CircuitMonkey/synth-zodiac/Documents/photos/USB-c-though-pcb-demo - 1.jpeg

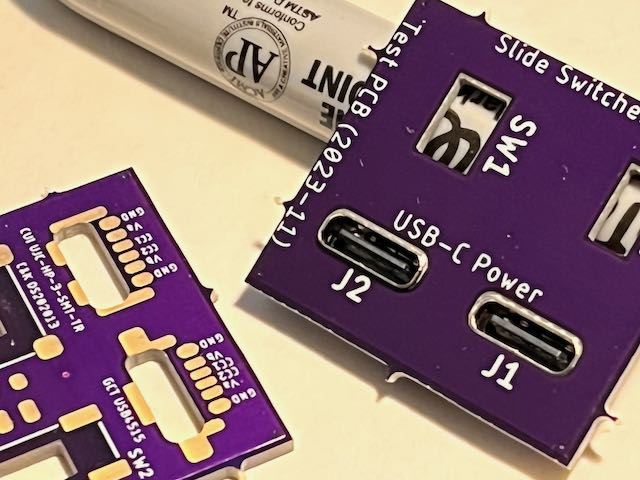
Documents/photos/USB-c-though-pcb-demo - 1.jpeg
