CircuitMonkey/synth-zodiac/Documents/photos/zodiac-pcbs - 1.jpeg

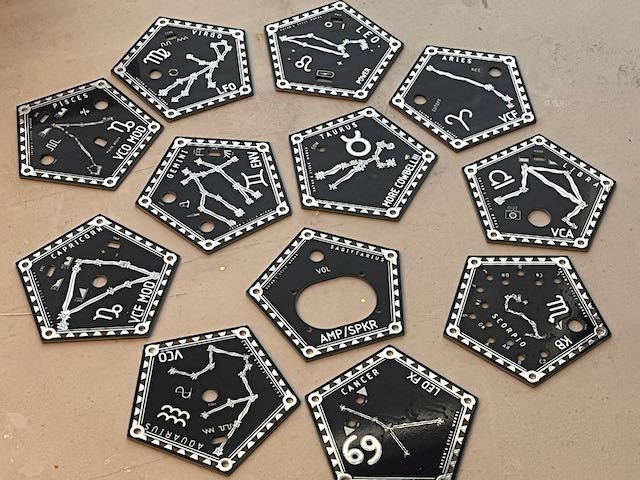
Documents/photos/zodiac-pcbs - 1.jpeg
