CircuitMonkey/synth-zodiac/README.md

# synth-zodiac
Zodiac themed analog synthesizer, shaped like a Dodecahedron.
