CircuitMonkey/synth-zodiac/Documents/zodiac-block-diagram.pdf

# Zodiac Synthesizer – Block Diagram

2022-06-02

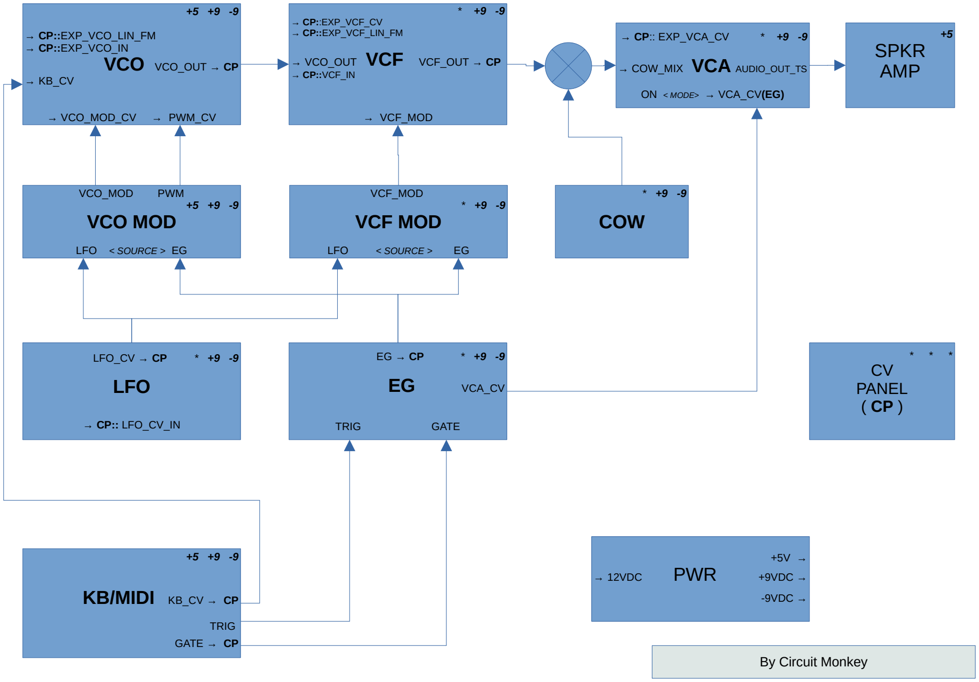
[picture p3: figure]
→ CP::EXP_VCO_LIN_FM → CP::EXP_VCO_IN VCO VCO_OUT → CP; → VCO_MOD_CV; → PWM_CV; LFO_CV → CP; LFO; → CP:: LFO_CV_IN; VCO_MOD; PWM; VCO MOD; LFO < SOURCE > EG; VCA_CV; TRIG; GATE; KB/MIDI KB_CV → CP; TRIG GATE → CP; → CP:: EXP_VCA_CV; → COW_MIX VCA AUDIO_OUT_TS; ON < MODE> → VCA_CV(EG); → 12VDC; PWR; +9VDC →; -9VDC →; SPKR AMP; * +9 -9 COW; CV PANEL ( CP ); → CP::EXP_VCF_CV → CP::EXP_VCF_LIN_FM; → VCO_OUT VCF VCF_OUT → CP; → CP::VCF_IN; → VCF_MOD; VCF_MOD; VCF MOD; < SOURCE >; By Circuit Monkey
