CircuitMonkey/synth-zodiac/Documents/Layouts/layout-bottom-3.png

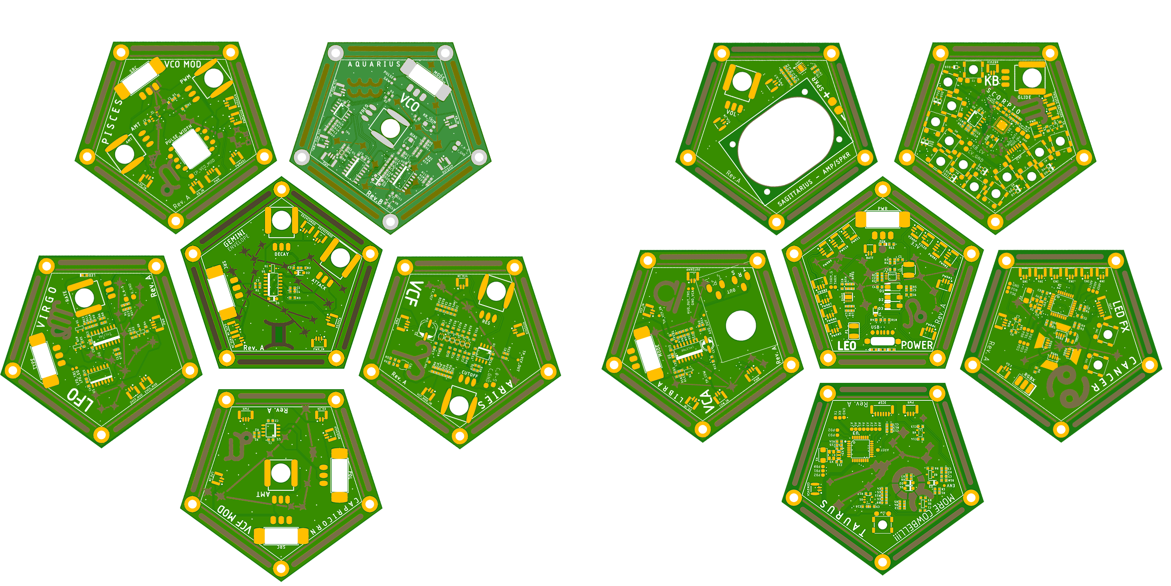
Documents/Layouts/layout-bottom-3.png
