CircuitMonkey/synth-zodiac/Documents/Layouts/layout-top-3.png

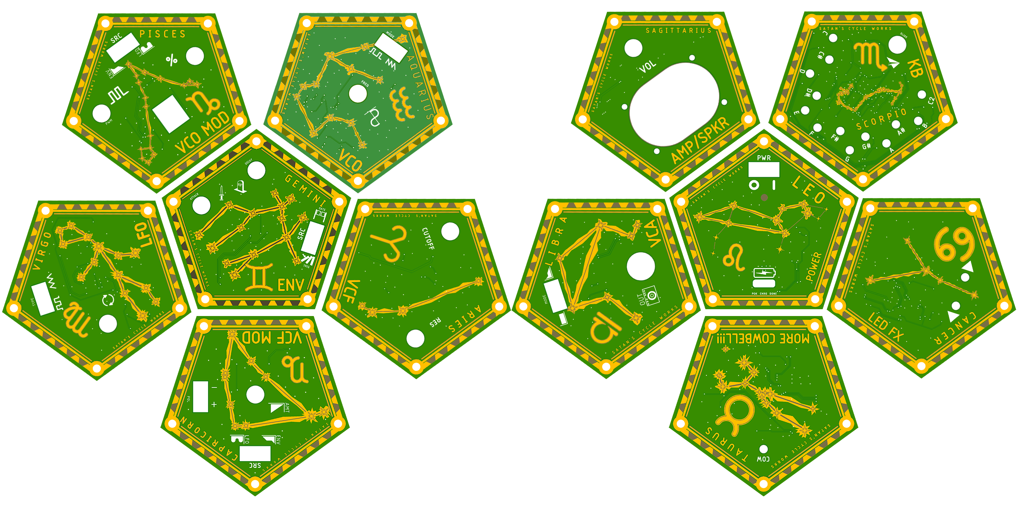
Documents/Layouts/layout-top-3.png
