CircuitMonkey/synth-zodiac/Documents/Layouts/zodiac-layout-2.png

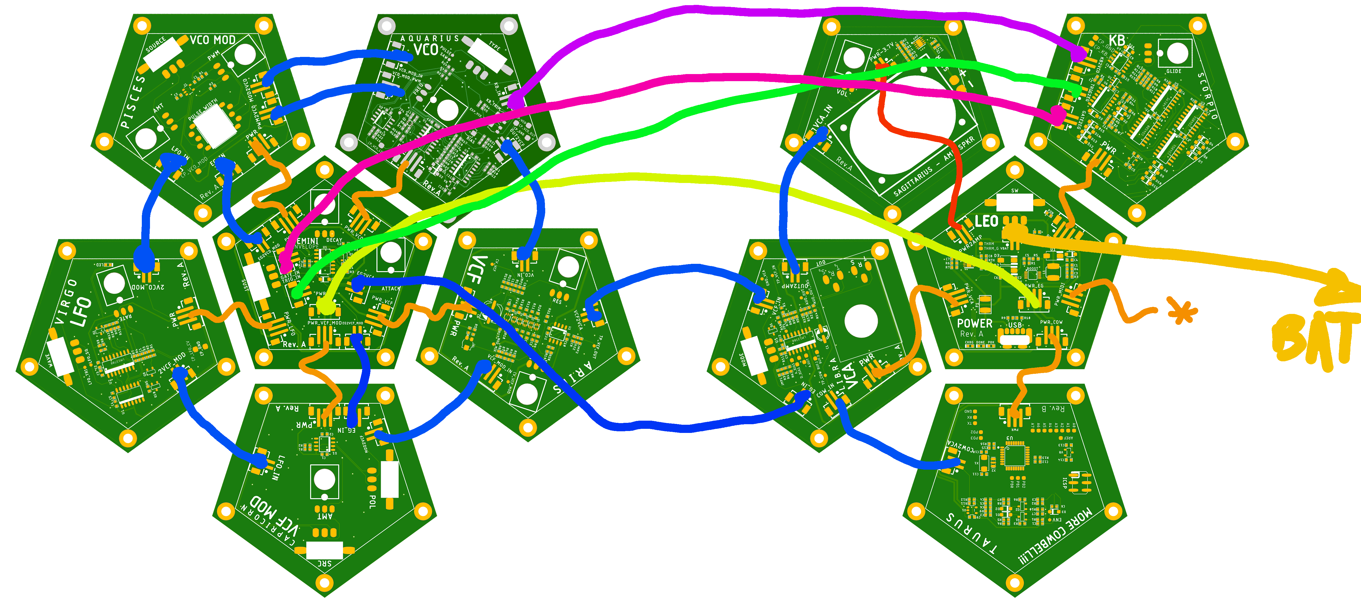
Documents/Layouts/zodiac-layout-2.png
