CircuitMonkey/synth-zodiac/Documents/photos/USB-c-though-pcb-demo - 2.jpeg

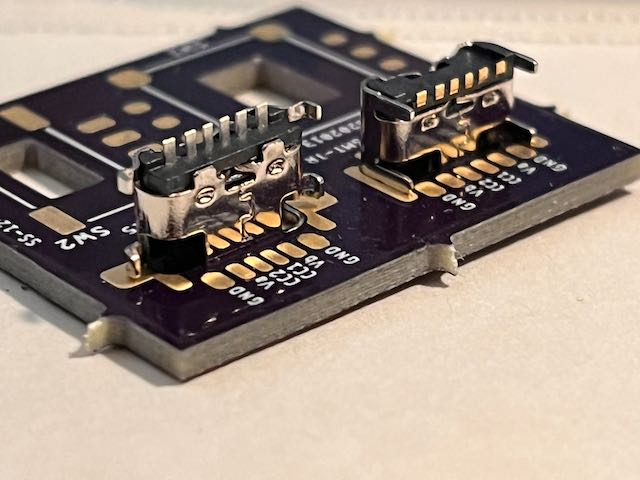
Documents/photos/USB-c-though-pcb-demo - 2.jpeg
