CircuitMonkey/synth-zodiac/Documents/photos/zodiac-pcbs - 2.jpeg

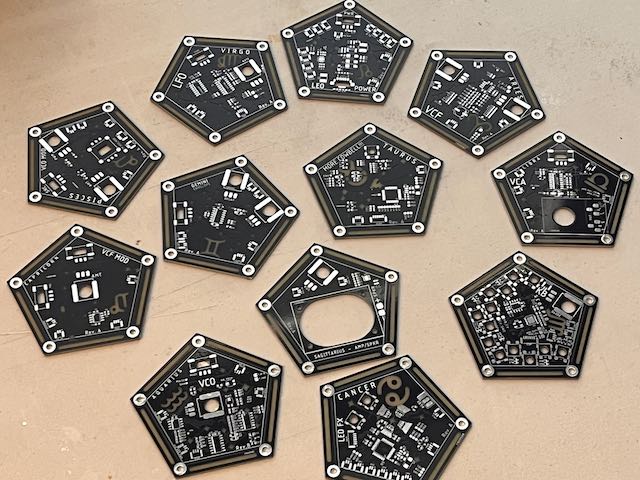
Documents/photos/zodiac-pcbs - 2.jpeg
