CircuitMonkey/synth-zodiac/Documents/synth-zodiac-aries-vcf-bom.ods

Synth – Zodiac – Aries – VCF |  |  |  | Rev. A
Part | Value | Device | Package | Description | COST01 | COST10 | COST100 | MFR | MPN | SKU
PCB | PCB FAB | PENTAGON-40R | PENTAGON-40MM | Pentagram shaped PCB | $2.00 | $1.00 | $0.70
R1 | 68.1K | RESISTOR0603 | 0603-RES | Resistor | $0.10 | $0.05 | $0.02
R2 | 150K | RESISTOR0603 | 0603-RES | Resistor | $0.10 | $0.05 | $0.02
R3 | 100K | RESISTOR0603 | 0603-RES | Resistor | $0.10 | $0.05 | $0.02
R4 | 33.2K | RESISTOR0603 | 0603-RES | Resistor | $0.10 | $0.05 | $0.02
R5 | 4.99K | RESISTOR0603 | 0603-RES | Resistor | $0.10 | $0.05 | $0.02
R6 | 4.99K | RESISTOR0603 | 0603-RES | Resistor | $0.10 | $0.05 | $0.02
R7 | 68.1K | RESISTOR0603 | 0603-RES | Resistor | $0.10 | $0.05 | $0.02
R8 | 1.0K | RESISTOR0603 | 0603-RES | Resistor | $0.10 | $0.05 | $0.02
R9 | 2.74K | RESISTOR0603 | 0603-RES | Resistor | $0.10 | $0.05 | $0.02
R10 | 1.0K | RESISTOR0603 | 0603-RES | Resistor | $0.10 | $0.05 | $0.02
R11 | 1.0K | RESISTOR0603 | 0603-RES | Resistor | $0.10 | $0.05 | $0.02
R12 | 1.0K | RESISTOR0603 | 0603-RES | Resistor | $0.10 | $0.05 | $0.02
R13 | 1.0K | RESISTOR0603 | 0603-RES | Resistor | $0.10 | $0.05 | $0.02
R14 | 2.74K | RESISTOR0603 | 0603-RES | Resistor | $0.10 | $0.05 | $0.02
R15 | 1.0K | RESISTOR0603 | 0603-RES | Resistor | $0.10 | $0.05 | $0.02
R16 | 1.0K | RESISTOR0603 | 0603-RES | Resistor | $0.10 | $0.05 | $0.02
R17 | 12.1K | RESISTOR0603 | 0603-RES | Resistor | $0.10 | $0.05 | $0.02
R18 | 1.0K | RESISTOR0603 | 0603-RES | Resistor | $0.10 | $0.05 | $0.02
R19 | 100 | RESISTOR0603 | 0603-RES | Resistor | $0.10 | $0.05 | $0.02
R20 | 6.81K | RESISTOR0603 | 0603-RES | Resistor | $0.10 | $0.05 | $0.02
R21 | 12.1K | RESISTOR0603 | 0603-RES | Resistor | $0.10 | $0.05 | $0.02
R22 | 100K | RESISTOR0603 | 0603-RES | Resistor | $0.10 | $0.05 | $0.02
R23 | 150K | RESISTOR0603 | 0603-RES | Resistor | $0.10 | $0.05 | $0.02
R24 | 47K | RESISTOR0603 | 0603-RES | Resistor | $0.10 | $0.05 | $0.02
C1 | 2.2uF | CAPACITOR0603 | 0603-CAP | Capacitor | $0.12 | $0.09 | $0.05
C2 | 0.1uF | CAPACITOR0603 | 0603-CAP | Capacitor | $0.12 | $0.09 | $0.05
C3 | 0.1uF | CAPACITOR0603 | 0603-CAP | Capacitor | $0.12 | $0.09 | $0.05
C4 | 0.1uF | CAPACITOR0603 | 0603-CAP | Capacitor | $0.12 | $0.09 | $0.05
C5 | 0.1uF | CAPACITOR0603 | 0603-CAP | Capacitor | $0.12 | $0.09 | $0.05
C6 | 100uF/25V | CAPACITOR_POL-ALUM-SMT-6.3 | CAP_ALUM_SMT_6.3 | Polarized Capacitor | $0.50 | $0.50 | $0.40 | Wurth | 865090445008
C7 | 0.1uF | CAPACITOR0603 | 0603-CAP | Capacitor | $0.12 | $0.09 | $0.05
C8 | 2.2uF | CAPACITOR0603 | 0603-CAP | Capacitor | $0.12 | $0.09 | $0.05
C9 | 2.2uF | CAPACITOR0603 | 0603-CAP | Capacitor | $0.12 | $0.09 | $0.05
C10 | 0.1uF | CAPACITOR0603 | 0603-CAP | Capacitor | $0.12 | $0.09 | $0.05
C11 | 0.1uF | CAPACITOR0603 | 0603-CAP | Capacitor | $0.12 | $0.09 | $0.05
Q1 | PMP4201 | NPN-DUALPMP4201 | SOT666 | Dual NPN Transistor | $0.55 | $0.45 | $0.35 | NXP | PMP4201V
Q2 | PMP4201 | NPN-DUALPMP4201 | SOT666 | Dual NPN Transistor | $0.55 | $0.45 | $0.35 | NXP | PMP4201V
Q3 | PMP4201 | NPN-DUALPMP4201 | SOT666 | Dual NPN Transistor | $0.55 | $0.45 | $0.35 | NXP | PMP4201V
Q4 | PMP4201 | NPN-DUALPMP4201 | SOT666 | Dual NPN Transistor | $0.55 | $0.45 | $0.35 | NXP | PMP4201V
Q5 | PMP4201 | NPN-DUALPMP4201 | SOT666 | Dual NPN Transistor | $0.55 | $0.45 | $0.35 | NXP | PMP4201V
Q6 | BC847BPN | NPN-PNPBC847BPN | SOT363 | NPN PNP pair | $0.25 | $0.20 | $0.10 | PANJIT | BC487BPN
U1 | NE5532A | DUALNE5532-SMD | SOP08 | Dual Op-Amp | $0.65 | $0.55 | $0.40 | TI | NE5532DR
CAL | 10K | TRIMPOTTC33X | TRIM_BOURNS_TC33X | Potentiometer |  |  |  | Bourns | TC33X
CUTOFF | 10K | TRIMPOT9MM_PCB_SHAFT | POT-RV9110 | Potentiometer | $0.70 | $0.60 | $0.60 | Tayda | RV9110NO-OS15A00 | A-5517
RES | 10K | TRIMPOT9MM_PCB_SHAFT | POT-RV9110 | Potentiometer | $0.70 | $0.60 | $0.60 | Tayda | RV9110NO-OS15A00 | A-5517
VCF2VCA | JST, SH, 2P | 02P-SM-VT-SMT | BM02B-SRSS-TB | 2 pin connector | $0.45 | $0.40 | $0.35 | JST | BMB02B-SRSS-TB
VCF_MOD_IN | JST, SH, 2P | 02P-SM-VT-SMT | BM02B-SRSS-TB | 2 pin connector | $0.45 | $0.40 | $0.35 | JST | BMB02B-SRSS-TB
VCO_IN | JST, SH, 2P | 02P-SM-VT-SMT | BM02B-SRSS-TB | 2 pin connector | $0.45 | $0.40 | $0.35 | JST | BMB02B-SRSS-TB
PWR | JST SM 3P | 03P-SM-VT-SMT | BM03B-SRSS-TB | 3 pin connector | $0.60 | $0.45 | $0.38 | JST | BM03B-SRSS-TB
C_0-5 | PADSMD-070X070 | PADSMD-070X070 | SMD-070MIL | Solder Pad
C_GND | PADSMD-070X070 | PADSMD-070X070 | SMD-070MIL | Solder Pad
JMP1 | NP | SHORT0603 | 0603-SHORT | Pre-shorted SMT Resistor Pad
