CircuitMonkey/synth-zodiac/Documents/synth-zodiac-aquarius-vco-bom.ods

Sheet: Rev. B
Synth – Zodiac – Aquarius – VCO |  |  |  | Rev. B
Part | Value | Device | Package | Description | COST01 | COST10 | COST100 | MFR | MPN | SKU
PCB | PCB FAB | PENTAGON-40R | PENTAGON-40MM | Pentagram PCB | $2.00 | $1.00 | $0.70
R1 | 150K | RESISTOR0603 | 0603-RES | Resistor | $0.10 | $0.05 | $0.02
R2 | 221K | RESISTOR0603 | 0603-RES | Resistor | $0.10 | $0.05 | $0.02
R3 | 221K | RESISTOR0603 | 0603-RES | Resistor | $0.10 | $0.05 | $0.02
R4 | 412K | RESISTOR0603 | 0603-RES | Resistor | $0.10 | $0.05 | $0.02
R5 | 150K | RESISTOR0603 | 0603-RES | Resistor | $0.10 | $0.05 | $0.02
R6 | 2.2K | RESISTOR0603 | 0603-RES | Resistor | $0.10 | $0.05 | $0.02
R7 | 47K | RESISTOR0603 | 0603-RES | Resistor | $0.10 | $0.05 | $0.02
R8 | 1.82M | RESISTOR0603 | 0603-RES | Resistor | $0.10 | $0.05 | $0.02
R9 | 10K | RESISTOR0603 | 0603-RES | Resistor | $0.10 | $0.05 | $0.02
R10 | 0 | RESISTOR0603 | 0603-RES | Resistor | $0.10 | $0.05 | $0.02
R11 | 0 | RESISTOR0603 | 0603-RES | Resistor | $0.10 | $0.05 | $0.02
R12 | NS | RESISTOR0603 | 0603-RES | Resistor | $0.10 | $0.05 | $0.02
R13 | 0 | RESISTOR0603 | 0603-RES | Resistor | $0.10 | $0.05 | $0.02
R14 | 0 | RESISTOR0603 | 0603-RES | Resistor | $0.10 | $0.05 | $0.02
R15 | 100K | RESISTOR0603 | 0603-RES | Resistor | $0.10 | $0.05 | $0.02
R16 | 100K | RESISTOR0603 | 0603-RES | Resistor | $0.10 | $0.05 | $0.02
R17 | 10.0K | RESISTOR0603 | 0603-RES | Resistor | $0.10 | $0.05 | $0.02
R18 | 4.75M | RESISTOR0603 | 0603-RES | Resistor | $0.10 | $0.05 | $0.02
R19 | 4.99K | RESISTOR0603 | 0603-RES | Resistor | $0.10 | $0.05 | $0.02
R20 | 4.99K | RESISTOR0603 | 0603-RES | Resistor | $0.10 | $0.05 | $0.02
R21 | 4.99K | RESISTOR0603 | 0603-RES | Resistor | $0.10 | $0.05 | $0.02
R22 | 4.99K | RESISTOR0603 | 0603-RES | Resistor | $0.10 | $0.05 | $0.02
R23 | 10K | RESISTOR0603 | 0603-RES | Resistor | $0.10 | $0.05 | $0.02
C1 | 4700pF | CAPACITOR0603 | 0603-CAP | Capacitor | $0.12 | $0.09 | $0.05
C2 | 22uF | CAPACITOR0603 | 0603-CAP | Capacitor | $0.12 | $0.09 | $0.05
C3 | 0.1uF | CAPACITOR0603 | 0603-CAP | Capacitor | $0.12 | $0.09 | $0.05
C4 | 0.1uF | CAPACITOR0603 | 0603-CAP | Capacitor | $0.12 | $0.09 | $0.05
C5 | 3900pF | CAPACITOR0603 | 0603-CAP | Capacitor | $0.12 | $0.09 | $0.05
C6 | 0.1uF | CAPACITOR0603 | 0603-CAP | Capacitor | $0.12 | $0.09 | $0.05
C7 | 0.1uF | CAPACITOR0603 | 0603-CAP | Capacitor | $0.12 | $0.09 | $0.05
C8 | 1.0uF | CAPACITOR0603 | 0603-CAP | Capacitor | $0.12 | $0.09 | $0.05
C9 | 100pF | CAPACITOR0603 | 0603-CAP | Capacitor | $0.12 | $0.09 | $0.05
C10 | 220pF | CAPACITOR0603 | 0603-CAP | Capacitor | $0.12 | $0.09 | $0.05
C11 | 1uF | CAPACITOR0603 | 0603-CAP | Capacitor | $0.12 | $0.09 | $0.05
C12 | 1uF | CAPACITOR0603 | 0603-CAP | Capacitor | $0.12 | $0.09 | $0.05
D1 | 1N4148 | DIODE-1N4148 | SOD-123 | Diode | $0.20 | $0.18 | $0.10 |  | 1N4148W
D2 | 1N4148 | DIODE-1N4148 | SOD-123 | Diode | $0.20 | $0.18 | $0.10 |  | 1N4148W
Q1 | PMP4201 | NPN-DUALPMP4201 | SOT666 | Dual NPN Transistor | $0.55 | $0.45 | $0.35 | NXP | PMP4201V
U1 | TL074A | QUADTL074A-SOIC | SOP14 | Quad Op-amp | $0.95 | $0.70 | $0.55 | ST | TL074ACDT
U2 | LM393 | DUAL-LM393ED | SOP08 | Dual Op-Amp | $0.40 | $0.32 | $0.20 | ST | LM393ED | Mouser
U3 | CD4066 | CD4066SO14 | SOP14 | Analog Switch | $0.55 | $0.45 | $0.35 | TI | CD4066BM
VR | 5V | LDO-3P--5V-SOT23 | SOT-23 | regulator 3-pin | $0.66 | $0.56 | $0.39 | Diodes, Inc. | AP7387-50SA
KB_TRIM | 100K | TRIMPOTTC33X | TRIM_BOURNS_TC33X | Potentiometer |  |  |  | Bourns | TC33X
BIAS | NP | TRIMPOTTC33X | TRIM_BOURNS_TC33X | Potentiometer |  |  |  | Bourns | TC33X
FREQ | 10K | TRIMPOT9MM_PCB_SHAFT | POT-RV9110 | Potentiometer | $0.70 | $0.60 | $0.60 | Tayda | RV9110NO-OS15A00 | A-5517
MODE | Switch, SPDT | SLIDE-SPDT-MNTSS-12-F45-TH-PCB-2 | SS-12-F45-PNL-SMT-2 | Slide Switch, SPDT | $0.15 | $0.12 | $0.12 | Tayda | A-659/A-5111/A-5104
OUT2VCF | JST, SH, 2P | 02P-SM-VT-SMT | BM02B-SRSS-TB | 2 pin connector | $0.45 | $0.40 | $0.35 | JST | BMB02B-SRSS-TB
KB_IN | JST, SH, 2P | 02P-Wire | BM02B-SRSS-TB | 2 pin connector | $0.45 | $0.40 | $0.35 | JST | BMB02B-SRSS-TB | Swap Black-Red!
VCO_MOD_IN | JST, SH, 2P | 02P-Wire | BM02B-SRSS-TB | 2 pin connector | $0.45 | $0.40 | $0.35 | JST | BMB02B-SRSS-TB | Swap Black-Red!
VCO_MOD_PWM | JST, SH, 2P | 02P-Wire | BM02B-SRSS-TB | 2 pin connector | $0.45 | $0.40 | $0.35 | JST | BMB02B-SRSS-TB | Swap Black-Red!
PWR | JST SM 3P | 03P-Wire | BM03B-SRSS-TB | 3 pin connector | $0.60 | $0.45 | $0.38 | JST | BM03B-SRSS-TB | Swap Black-Red!

Sheet: Rev. A
Synth – Zodiac – Aquarius – VCO |  |  |  | Rev. A
 |  | Don’t Use!
Part | Value | Device | Package | Description | MPN | COST01 | COST10 | COST100 | MFR | SKU | VALUE
FAB |  | PCB Fab |  | PCB Fab |  | $10.00 | $5.00 | $2.00
R2 | 221K | RESISTOR0603 | 0603-RES | Resistor |  | $0.10 | $0.05 | $0.02
R3 | 221K | RESISTOR0603 | 0603-RES | Resistor |  | $0.10 | $0.05 | $0.02
R4 | 412K | RESISTOR0603 | 0603-RES | Resistor |  | $0.10 | $0.05 | $0.02
R5 | 68.1K - NP | RESISTOR0603 | 0603-RES | Resistor |  | $0.10 | $0.05 | $0.02
R6 | 2.2K | RESISTOR0603 | 0603-RES | Resistor |  | $0.10 | $0.05 | $0.02
R7 | 499K | RESISTOR0603 | 0603-RES | Resistor |  | $0.10 | $0.05 | $0.02
R8 | 1.82M | RESISTOR0603 | 0603-RES | Resistor |  | $0.10 | $0.05 | $0.02
R9 | 10K | RESISTOR0603 | 0603-RES | Resistor |  | $0.10 | $0.05 | $0.02
R10 | 0 | RESISTOR0603 | 0603-RES | Resistor |  | $0.10 | $0.05 | $0.02
R11 | 0 | RESISTOR0603 | 0603-RES | Resistor |  | $0.10 | $0.05 | $0.02
R12 | NS | RESISTOR0603 | 0603-RES | Resistor |  | $0.10 | $0.05 | $0.02
R13 | 0 | RESISTOR0603 | 0603-RES | Resistor |  | $0.10 | $0.05 | $0.02
R14 | 0 | RESISTOR0603 | 0603-RES | Resistor |  | $0.10 | $0.05 | $0.02
R15 | 100K | RESISTOR0603 | 0603-RES | Resistor |  | $0.10 | $0.05 | $0.02
R16 | 100K | RESISTOR0603 | 0603-RES | Resistor |  | $0.10 | $0.05 | $0.02
R17 | 10.0K | RESISTOR0603 | 0603-RES | Resistor |  | $0.10 | $0.05 | $0.02
R18 | 4.75M | RESISTOR0603 | 0603-RES | Resistor |  | $0.10 | $0.05 | $0.02
R19 | 4.99K | RESISTOR0603 | 0603-RES | Resistor |  | $0.10 | $0.05 | $0.02
R20 | 4.99K | RESISTOR0603 | 0603-RES | Resistor |  | $0.10 | $0.05 | $0.02
R21 | 4.99K | RESISTOR0603 | 0603-RES | Resistor |  | $0.10 | $0.05 | $0.02
R22 | 4.99K | RESISTOR0603 | 0603-RES | Resistor |  | $0.10 | $0.05 | $0.02
R23 | 10K | RESISTOR0603 | 0603-RES | Resistor |  | $0.10 | $0.05 | $0.02
R24 | 0 | RESISTOR0603 | 0603-RES | Resistor |  | $0.10 | $0.05 | $0.02
C1 | 4700pF | CAPACITOR0603 | 0603-CAP | Capacitor |  | $0.12 | $0.09 | $0.05
C2 | 22uF | CAPACITOR0603 | 0603-CAP | Capacitor |  | $0.12 | $0.09 | $0.05
C3 | 0.1uF | CAPACITOR0603 | 0603-CAP | Capacitor |  | $0.12 | $0.09 | $0.05
C4 | 0.1uF | CAPACITOR0603 | 0603-CAP | Capacitor |  | $0.12 | $0.09 | $0.05
C5 | 3900pF | CAPACITOR0603 | 0603-CAP | Capacitor |  | $0.12 | $0.09 | $0.05
C6 | 0.1uF | CAPACITOR0603 | 0603-CAP | Capacitor |  | $0.12 | $0.09 | $0.05
C7 | 0.1uF | CAPACITOR0603 | 0603-CAP | Capacitor |  | $0.12 | $0.09 | $0.05
C8 | 1.0uF | CAPACITOR0603 | 0603-CAP | Capacitor |  | $0.12 | $0.09 | $0.05
C9 | 100pF | CAPACITOR0603 | 0603-CAP | Capacitor |  | $0.12 | $0.09 | $0.05
C10 | 220pF | CAPACITOR0603 | 0603-CAP | Capacitor |  | $0.12 | $0.09 | $0.05
C11 | 1uF | CAPACITOR0603 | 0603-CAP | Capacitor |  | $0.12 | $0.09 | $0.05
C12 | 1uF | CAPACITOR0603 | 0603-CAP | Capacitor |  | $0.12 | $0.09 | $0.05
D1 | 1N4148 | DIODE-1N4148 | SOD-123 | Diode | 1N4148W | $0.14 | $0.10 | $0.06 |  |  | 1N4148
D2 | 1N4148 | DIODE-1N4148 | SOD-123 | Diode | 1N4148W | $0.14 | $0.10 | $0.06 |  |  | 1N4148
Q1 | PMP4201 | NPN-DUALPMP4201 | SOT666 | Dual NPN Transistor | PMP4201V | $0.55 | $0.45 | $0.35 | NXP |  | PMP4201
U1 | TL074A | QUADTL074A-SOIC | SOP14 | Quad Op-amp | TL074ACDT | $0.95 | $0.70 | $0.55 | ST |  | TL074A
U2 | LM393 | DUAL-LM393ED | SOP08 | Dual Op-Amp | LM393ED | $0.40 | $0.32 | $0.20 | ST |  | LM393
U3 | CD4066 | CD4066SO14 | SOP14 | CD4066 Analog Switch | CD4066BM | $0.55 | $0.45 | $0.35 | TI |  | CD4066
VR | 5V | LDO-3P--5V-SOT23 | SOT-23 | regulator 3-pin | AP7387-50SA | $0.66 | $0.56 | $0.39 | Diodes, Inc. |  | 5V
BIAS | NP | TRIMPOTTC33X | TRIM_BOURNS_TC33X | Potentiometer | TC33X | $0.60 | $0.50 | $0.40 | Bourns
EXP_VCO_TRIM | 100K - NP | TRIMPOTTC33X | TRIM_BOURNS_TC33X | Potentiometer | TC33X | $0.60 | $0.50 | $0.40 | Bourns
FREQ | 10K | TRIMPOT9MM_PCB_SHAFT | POT-RV9110 | Potentiometer | RV9110NO-OS15A00 | $0.70 | $0.60 | $0.60 | Tayda A-5517 | A-5517
KB_TRIM | 100K | TRIMPOTTC33X | TRIM_BOURNS_TC33X | Potentiometer | TC33X | $0.60 | $0.50 | $0.40 | Bourns
KB_IN | 2-pin, VT, SMT | 02PVT-SMT | B2B-PH-SM4 | 2 pin connector | B2B-PH-SM4 | $0.60 | $0.52 | $0.43 | JST |  | 2-pin, VT, SMT
OUT2VCF | 2-pin, VT, SMT | 02PVT-SMT | B2B-PH-SM4 | 2 pin connector | B2B-PH-SM4 | $0.60 | $0.52 | $0.43 | JST |  | 2-pin, VT, SMT
PWR | JST, 3P, VT, SMT | 03P-VT-SMT | B3B-PH-SM4 | 3 pin connector | B3B-PH-SM4 | $0.60 | $0.52 | $0.43 | JST |  | JST, 3P, VT, SMT
VCO_MOD_IN | 2-pin, VT, SMT | 02PVT-SMT | B2B-PH-SM4 | 2 pin connector | B2B-PH-SM4 |  |  |  | JST |  | 2-pin, VT, SMT
VCO_MOD_PWM | 2-pin, VT, SMT | 02PVT-SMT | B2B-PH-SM4 | 2 pin connector | B2B-PH-SM4 |  |  |  | JST |  | 2-pin, VT, SMT
TYPE | SPDT | SLIDE-SPDTSS-12-F45-TH-PCB | SS-12-F45-PNL-SMT | Slide Switch, SPDT | A-659 / A-5111 | $0.15 | $0.12 | $0.12 | Tayda
 |  |  |  |  |  | $21.43 | $13.57 | $8.11
