CircuitMonkey/synth-zodiac/Documents/synth-zodiac-cancer-led-bom.ods

Synth – Zodiac – Cancer – LED Effects |  |  |  | Rev. A
Part | Value | Device | Package | Description | COST01 | COST10 | COST100 | MFR | MPN | MPN2 | OC_MOUSER | OC_SEEED | VALUE
PCB1 | PCB FAB | PENTAGON-40R | PENTAGON-40MM | Pentagram shaped PCB | $2.00 | $1.00 | $0.70 |  |  |  |  |  | PCB FAB
R1 | 10K | RESISTOR0603 | 0603-RES | Resistor | $0.10 | $0.05 | $0.02
R2 | 470 | RESISTOR0603 | 0603-RES | Resistor | $0.10 | $0.05 | $0.02
R3 | 470 | RESISTOR0603 | 0603-RES | Resistor | $0.10 | $0.05 | $0.02
R4 | 4.7K | RESISTOR0603 | 0603-RES | Resistor | $0.10 | $0.05 | $0.02
R5 | 10K | RESISTOR0603 | 0603-RES | Resistor | $0.10 | $0.05 | $0.02
R6 | 330 | RESISTOR0603 | 0603-RES | Resistor | $0.10 | $0.05 | $0.02
C1 | 0.1uF | CAPACITOR0603 | 0603-CAP | Capacitor | $0.12 | $0.09 | $0.05
C2 | 0.1uF | CAPACITOR0603 | 0603-CAP | Capacitor | $0.12 | $0.09 | $0.05
C3 | 0.1uF | CAPACITOR0603 | 0603-CAP | Capacitor | $0.12 | $0.09 | $0.05
C4 | 18pF | CAPACITOR0603 | 0603-CAP | Capacitor | $0.12 | $0.09 | $0.05
C5 | 18pF | CAPACITOR0603 | 0603-CAP | Capacitor | $0.12 | $0.09 | $0.05
C6 | 1uF | CAPACITOR0603 | 0603-CAP | Capacitor | $0.12 | $0.09 | $0.05
C7 | 1uF | CAPACITOR0603 | 0603-CAP | Capacitor | $0.12 | $0.09 | $0.05
DEC | SPST, TACT, MOM | PUSHBTN-MOMB3FS-BLIND | B3FS-BACKMOUNT | Pushbutton Switch | $0.15 | $0.12 | $0.09 | CK | B3FS | Tayda A-3961(2.3mm), A-5134(3.14mm,RA) |  |  | SPST, TACT, MOM
INC | SPST, TACT, MOM | PUSHBTN-MOMB3FS-BLIND | B3FS-BACKMOUNT | Pushbutton Switch | $0.15 | $0.12 | $0.09 | CK | B3FS | Tayda A-3961(2.3mm), A-5134(3.14mm,RA) |  |  | SPST, TACT, MOM
VR1 | 5V | LDO-3P--5V-SOT23 | SOT-23 | regulator 3-pin | $0.66 | $0.56 | $0.39 | Diodes, Inc. | AP7387-50SA |  |  |  | 5V
X1 | 16MHz | 2P3.2X2.5 | 32X25 | Crystal | $0.65 | $0.55 | $0.45 | Epson | FA-238 16.0000MB-K3 |  |  |  | 16MHz
X2 | 16MHz | 2PCTS_445 | CTS_5X3 | Crystal | $0.65 | $0.55 | $0.45 | CTS | 445C35K16M0000 |  |  |  | 16MHz
X3 | 16MHz | RESONATOR-CSTE16 | CSTE-RESONATOR | Resonator | $0.35 | $0.30 | $0.27 | Murata | CSTCE16M |  |  |  | 16MHz
U1 | ATmega328P-AU | ATMEGA328AU | TQFP-32-08 | Atmega 328P | $3.00 | $2.00 | $1.60 | Atmel | ATMEGA328P-AU |  | 556-ATMEGA328P-AU | 310010049 | ATmega328P-AU
RGB1 | SK2812B_3535 | SMART_LED3535 | SMD_3535 | Smart LED SK6812 WS2812 | $0.60 | $0.50 | $0.40 |  |  |  |  |  | SK2812B_3535
RGB2 | SK2812B_4020-Side | SMART_LED4020-SIDE | SMD_4020 | Smart LED SK6812 WS2812 | $0.60 | $0.50 | $0.40
RGB3 | SK2812B_4020-Side | SMART_LED4020-SIDE | SMD_4020 | Smart LED SK6812 WS2812 | $0.60 | $0.50 | $0.40
RGB4 | SK2812B_4020-Side | SMART_LED4020-SIDE | SMD_4020 | Smart LED SK6812 WS2812 | $0.60 | $0.50 | $0.40
RGB5 | SK2812B_4020-Side | SMART_LED4020-SIDE | SMD_4020 | Smart LED SK6812 WS2812 | $0.60 | $0.50 | $0.40
IN0 | JST, SH, 2P | 02P-SM-VT-SMT | BM02B-SRSS-TB | 2 pin connector | $0.45 | $0.40 | $0.35 | JST | BMB02B-SRSS-TB |  |  |  | JST, SH, 2P
IN1 | JST, SH, 2P | 02P-SM-VT-SMT | BM02B-SRSS-TB | 2 pin connector | $0.45 | $0.40 | $0.35 | JST | BMB02B-SRSS-TB |  |  |  | JST, SH, 2P
IN2 | JST, SH, 2P | 02P-SM-VT-SMT | BM02B-SRSS-TB | 2 pin connector | $0.45 | $0.40 | $0.35 | JST | BMB02B-SRSS-TB |  |  |  | JST, SH, 2P
IN3 | JST, SH, 2P | 02P-SM-VT-SMT | BM02B-SRSS-TB | 2 pin connector | $0.45 | $0.40 | $0.35 | JST | BMB02B-SRSS-TB |  |  |  | JST, SH, 2P
IN4 | JST, SH, 2P | 02P-SM-VT-SMT | BM02B-SRSS-TB | 2 pin connector | $0.45 | $0.40 | $0.35 | JST | BMB02B-SRSS-TB |  |  |  | JST, SH, 2P
IN5 | JST, SH, 2P | 02P-SM-VT-SMT | BM02B-SRSS-TB | 2 pin connector | $0.45 | $0.40 | $0.35 | JST | BMB02B-SRSS-TB |  |  |  | JST, SH, 2P
ISCP | Connector, 6P, SM, VT | 06P-SM-VT-SMT | BM06B-SRSS-TB | Connector, 6P | $0.60 | $0.52 | $0.49 | JST | BM06-SRSS-TB |  |  |  | Connector, 6P, SM, VT
V3.7 | JST, SH, 2P | Wire Harness | BM02B-SRSS-TB | 2 pin connector | $0.45 | $0.40 | $0.35 | JST | BMB02B-SRSS-TB |  |  |  | JST, SH, 2P
PWR | JST SM 3P | Wire Harness | BM03B-SRSS-TB | 3 pin connector | $0.60 | $0.45 | $0.38 | JST | BM03B-SRSS-TB |  |  |  | JST SM 3P
