CircuitMonkey/synth-zodiac/Documents/synth-zodiac-leo-power-bom.ods

Synth – Zodiac – Leo – Power |  |  | Rev. A
Part | Value | Device | Package | Description | COST01 | COST10 | COST100 | MFR | MPN
FAB |  | PCB Fab |  |  | $2.00 | $1.00 | $0.75
R1 | 100K | RESISTOR0603 | 0603-RES | Resistor | $0.10 | $0.05 | $0.02
R2 | 10K | RESISTOR0603 | 0603-RES | Resistor | $0.10 | $0.05 | $0.02
R3 | 143K | RESISTOR0603 | 0603-RES | Resistor | $0.10 | $0.05 | $0.02
R4 | 1M | RESISTOR0603 | 0603-RES | Resistor | $0.10 | $0.05 | $0.02
R5 | 0.5ohm | RESISTOR0603 | 0603-RES | Resistor | $0.10 | $0.05 | $0.02
R6 | 1K | RESISTOR0603 | 0603-RES | Resistor | $0.10 | $0.05 | $0.02
R7 | 1K | RESISTOR0603 | 0603-RES | Resistor | $0.10 | $0.05 | $0.02
R8 | 1K | RESISTOR0603 | 0603-RES | Resistor | $0.10 | $0.05 | $0.02
R9 | 5.1K | RESISTOR0603 | 0603-RES | Resistor | $0.10 | $0.05 | $0.02
R10 | 5.1K | RESISTOR0603 | 0603-RES | Resistor | $0.10 | $0.05 | $0.02
R11 | 1K | RESISTOR0603 | 0603-RES | Resistor | $0.10 | $0.05 | $0.02
RPRG | 3K | RESISTOR0603 | 0603-RES | Resistor | $0.10 | $0.05 | $0.02
RTH | 10K | RESISTOR0603 | 0603-RES | Resistor | $0.10 | $0.05 | $0.02
C1 | 10uF/6.3V | CAPACITOR0603 | 0603-CAP | Capacitor | $0.12 | $0.09 | $0.05
C2 | 0.01uF | CAPACITOR0603 | 0603-CAP | Capacitor | $0.12 | $0.09 | $0.05
C3 | 100pF | CAPACITOR0603 | 0603-CAP | Capacitor | $0.12 | $0.09 | $0.05
C4 | 10uF/25V | CAPACITOR0603 | 0603-CAP | Capacitor | $0.12 | $0.09 | $0.05
C5 | 10uF/25V | CAPACITOR0603 | 0603-CAP | Capacitor | $0.12 | $0.09 | $0.05
C6 | 2.2uF/16V | CAPACITOR0603 | 0603-CAP | Capacitor | $0.12 | $0.09 | $0.05
C7 | 1uF/10V | CAPACITOR0603 | 0603-CAP | Capacitor | $0.12 | $0.09 | $0.05
C8 | 1uF/10V | CAPACITOR0603 | 0603-CAP | Capacitor | $0.12 | $0.09 | $0.05
L1 | 10.0uH | INDUCTORSMD-05X04MM | IND-SRN5040 | Inductor | $0.55 | $0.40 | $0.35 | Bourns | SRN5040
D1 | B140 | SCHOTTKYB140 | SMA | Schottky Diodes | $0.38 | $0.28 | $0.18 | Vishay/Various | B140
D2 | B140 | SCHOTTKYB140 | SMA | Schottky Diodes | $0.38 | $0.28 | $0.18 | Vishay/Various | B140
D3 | B140 | SCHOTTKYB140 | SMA | Schottky Diodes | $0.38 | $0.28 | $0.18 | Vishay/Various | B140
D4 | 1N4148 | DIODE-1N4148 | SOD-123 | Diode | $0.20 | $0.18 | $0.10 |  | 1N4148W
POK | BLU | SMT0603 | SMD_0603 | LED SMT | $0.20 | $0.17 | $0.14
PON | WHT | SMT0603 | SMD_0603 | LED SMT | $0.20 | $0.17 | $0.14
DONE | GRN | SMT0603 | SMD_0603 | LED SMT | $0.20 | $0.17 | $0.14
CHRG | RED | SMT0603 | SMD_0603 | LED SMT | $0.20 | $0.17 | $0.14
BOOST | MIC2145 | BOOST-MIC2145-MSOP | MSOP8-0.65 | Micrel 2145 Boost Converter | $2.75 | $2.71 | $2.70 | Micrel | MIC2145YMM
GHRG | MCP73833 | MCP73833-DFN | DFN-10-3X3 | USB Charger for Li-Ion Battery cell. |  |  |  | Microchip | MCP73833-AMI/MF
F1 | 0.5A | FUSEBOURNS-MF-MSMF | BOURNS-MF-MSMF | Fuse | $0.75 | $0.60 | $0.50 | BOURNS | MF-MSMF*
PWR |  | SLIDE-SPDT-MNTSS-12-F45-TH-PCB-2 | SS-12-F45-PNL-SMT-2 | Slide Switch, SPDT | $0.15 | $0.12 | $0.12 | Tayda | A-659/A-5111/A-5104
USB | USB-C, POWER | USB-C-PWRGCT-4515 | GCT-USB4515-PANEL | USB-C, Power Only | $0.70 | $0.55 | $0.45 | GCT | USB4515
PWR01 | JST SM 3P | 03P-SM-VT-SMT | BM03B-SRSS-TB | 3 pin connector | $0.60 | $0.45 | $0.38 | JST | BM03B-SRSS-TB
PWR02 | JST SM 3P | 03P-SM-VT-SMT | BM03B-SRSS-TB | 3 pin connector | $0.60 | $0.45 | $0.38 | JST | BM03B-SRSS-TB
PWR03 | JST SM 3P | 03P-SM-VT-SMT | BM03B-SRSS-TB | 3 pin connector | $0.60 | $0.45 | $0.38 | JST | BM03B-SRSS-TB
PWR04 | JST SM 3P | 03P-SM-VT-SMT | BM03B-SRSS-TB | 3 pin connector | $0.60 | $0.45 | $0.38 | JST | BM03B-SRSS-TB
PWR05 | JST SM 3P | 03P-SM-VT-SMT | BM03B-SRSS-TB | 3 pin connector | $0.60 | $0.45 | $0.38 | JST | BM03B-SRSS-TB
PWR06 | JST SM 3P | 03P-SM-VT-SMT | BM03B-SRSS-TB | 3 pin connector | $0.60 | $0.45 | $0.38 | JST | BM03B-SRSS-TB
PWR07 | JST SM 3P | 03P-SM-VT-SMT | BM03B-SRSS-TB | 3 pin connector | $0.60 | $0.45 | $0.38 | JST | BM03B-SRSS-TB
PWR08 | JST SM 3P | 03P-SM-VT-SMT | BM03B-SRSS-TB | 3 pin connector | $0.60 | $0.45 | $0.38 | JST | BM03B-SRSS-TB
PWR09 | JST SM 3P | 03P-SM-VT-SMT | BM03B-SRSS-TB | 3 pin connector | $0.60 | $0.45 | $0.38 | JST | BM03B-SRSS-TB
PWR10 | JST SM 3P | 03P-SM-VT-SMT | BM03B-SRSS-TB | 3 pin connector | $0.60 | $0.45 | $0.38 | JST | BM03B-SRSS-TB
PWR11 | JST SM 3P | 03P-SM-VT-SMT | BM03B-SRSS-TB | 3 pin connector | $0.60 | $0.45 | $0.38 | JST | BM03B-SRSS-TB
V2AMP | JST, SH, 2P | 02P-SM-VT-SMT | BM02B-SRSS-TB | 2 pin connector | $0.45 | $0.40 | $0.35 | JST | BMB02B-SRSS-TB
V2LED | JST, SH, 2P | 02P-SM-VT-SMT | BM02B-SRSS-TB | 2 pin connector | $0.45 | $0.40 | $0.35 | JST | BMB02B-SRSS-TB
BATT | JST, SH, 2P | 02P-SM-VT-SMT | BM02B-SRSS-TB | 2 pin connector | $0.45 | $0.40 | $0.35 | JST | BMB02B-SRSS-TB
