CircuitMonkey/synth-zodiac/Documents/synth-zodiac-pisces-vco-mod-bom.ods

Synth – Zodiac – Pisces – VCO Mod |  |  |  | Rev. A
Part | Value | Device | Package | Description | COST01 | COST10 | COST100 | MFR | MPN | SKU
PCB | PCB FAB | PENTAGON-40R | PENTAGON-40MM-RAD | Pentagram shaped PCB
R1 | 12K | RESISTOR0603 | 0603-RES | Resistor | $0.10 | $0.05 | $0.02
R2 | 4.99K | RESISTOR0603 | 0603-RES | Resistor | $0.10 | $0.05 | $0.02
C1 | 0.1uF | CAPACITOR0603 | 0603-CAP | Capacitor | $0.12 | $0.09 | $0.05
C2 | 0.1uF | CAPACITOR0603 | 0603-CAP | Capacitor | $0.12 | $0.09 | $0.05
U1 | TL071 | SINGLE-TL071 | SOT-23-5 | Single channel Op-amp | $0.46 | $0.37 | $0.29 | TI | TL071HIDBV
SRC | SPDT, Slide | SLIDE-SPDT-MNTSS-12-F45-TH-PCB-2 | SS-12-F45-PNL-SMT-2 | Slide Switch, SPDT | $0.15 | $0.12 | $0.12 | Tayda | A-659/A-5111/A-5104
PULSE_WIDTH | Switch, DPDT | SLIDE-DPDT-MNTPNL-SMD-TOGGLE-ONLY | CK_OS202013MT5-PNL-SMT-2 | DPDT Slide Switch with mounting pins |  |  |  | CK | OS202013MT5QN1
AMT | 10K | TRIMPOT9MM_PCB_SHAFT | POT-RV9110 | Potentiometer | $0.70 | $0.60 | $0.60 | Tayda | RV9110NO-OS15A00 | A-5517
PWM | 10K | TRIMPOT9MM_PCB_SHAFT | POT-RV9110 | Potentiometer | $0.70 | $0.60 | $0.60 | Tayda | RV9110NO-OS15A00 | A-5517
PWM2VCO | JST, SH, 2P | 02P-SM-VT-SMT | BM02B-SRSS-TB | 2 pin connector | $0.45 | $0.40 | $0.35 | JST | BMB02B-SRSS-TB
MOD2VCO | JST, SH, 2P | 02P-SM-VT-SMT | BM02B-SRSS-TB | 2 pin connector | $0.45 | $0.40 | $0.35 | JST | BMB02B-SRSS-TB
EG_IN | JST, SH, 2P | 02P-SM-VT-SMT | BM02B-SRSS-TB | 2 pin connector | $0.45 | $0.40 | $0.35 | JST | BMB02B-SRSS-TB
LFO_IN | JST, SH, 2P | 02P-SM-VT-SMT | BM02B-SRSS-TB | 2 pin connector | $0.45 | $0.40 | $0.35 | JST | BMB02B-SRSS-TB
PWR | JST SM 3P | 03P-SM-VT-SMT | BM03B-SRSS-TB | 3 pin connector | $0.60 | $0.45 | $0.38 | JST | BM03B-SRSS-TB
PWMADJ | NS, JST, SH, 2P | 02P-SM-VT-SMT | BM02B-SRSS-TB | 2 pin connector | $0.45 | $0.40 | $0.35 | JST | BMB02B-SRSS-TB
