CircuitMonkey/synth-zodiac/Documents/synth-zodiac-sagittarius-speaker-bom.ods

Synth – Zodiac – Sagittarius – Speaker |  |  |  | Rev. A
Part | Value | Device | Package | Description | COST01 | COST10 | COST100 | MFR | MPN | SKU
PCB1 | PCB FAB | PENTAGON-40R | PENTAGON-40MM | Pentagram shaped PCB | 2 | 1 | 0.7
R1 | 100K | RESISTOR0603 | 0603-RES | Resistor | 0.1 | 0.05 | 0.02
R2 | 100K | RESISTOR0603 | 0603-RES | Resistor | 0.1 | 0.05 | 0.02
R3 | 0 | RESISTOR0603 | 0603-RES | Resistor | 0.1 | 0.05 | 0.02
C1 | 0.1uF | CAPACITOR0603 | 0603-CAP | Capacitor | 0.12 | 0.09 | 0.05
C2 | 0.1uF | CAPACITOR0603 | 0603-CAP | Capacitor | 0.12 | 0.09 | 0.05
C3 | 4.7uF | CAPACITOR0603 | 0603-CAP | Capacitor | 0.12 | 0.09 | 0.05
C4 | 10uF | CAPACITOR0603 | 0603-CAP | Capacitor | 0.12 | 0.09 | 0.05
C5 | 1uF | CAPACITOR0603 | 0603-CAP | Capacitor | 0.12 | 0.09 | 0.05
AMP | PAM8302 | PAM8302-DFN | U-DFN3030-8 | PAM8302 Class-D Mono Amplifier | 0.7 | 0.6 | 0.46 | Diodes, Inc. | PAM8302AAYC
VOL | 10K | TRIMPOT9MM_PCB_SHAFT | POT-RV9110 | Potentiometer | 0.7 | 0.6 | 0.6 | Tayda | RV9110NO-OS15A00 | A-5517
SPKR | 8ohm/6W | Speaker | SPKR-40X30 | Speaker | 6.75 | 5.6 | 5.1 | CUI | CDS-40288
VCA_IN | JST, SH, 2P | Wire Harness | BM02B-SRSS-TB | 2 pin connector | 0.45 | 0.4 | 0.35 | JST | BMB02B-SRSS-TB
PWR-3.7 | JST, SH, 2P | Wire Harness | BM02B-SRSS-TB | 2 pin connector | 0.45 | 0.4 | 0.35 | JST | BMB02B-SRSS-TB
