CircuitMonkey/synth-zodiac/Documents/synth-zodiac-scorpio-kbd-mcu-bom.ods

Synth – Zodiac – Scorpio – Keyboard |  |  |  | Rev. A
Part | Value | Device | Package | Description | COST01 | COST10 | COST100 | MFR | MPN | MPN2
PCB | PCB FAB | PENTAGON-40R | PENTAGON-40MM-RAD | Pentagram shaped PCB | $2.00 | $1.00 | $0.70
R8 | 100K | RESISTOR0603 | 0603-RES | Resistor | $0.10 | $0.05 | $0.02
R16 | 10K | RESISTOR0603 | 0603-RES | Resistor | $0.10 | $0.05 | $0.02
C1 | 0.1uF | CAPACITOR0603 | 0603-CAP | Capacitor | $0.12 | $0.09 | $0.05
C5 | 1uF | CAPACITOR0603 | 0603-CAP | Capacitor | $0.12 | $0.09 | $0.05
C6 | 1uF | CAPACITOR0603 | 0603-CAP | Capacitor | $0.12 | $0.09 | $0.05
C7 | 1uF | CAPACITOR0603 | 0603-CAP | Capacitor | $0.12 | $0.09 | $0.05
C9 | 0.1uF | CAPACITOR0603 | 0603-CAP | Capacitor | $0.12 | $0.09 | $0.05
C10 | 0.1uF | CAPACITOR0603 | 0603-CAP | Capacitor | $0.12 | $0.09 | $0.05
C15 | 1.0uF | CAPACITOR0603 | 0603-CAP | Capacitor | $0.12 | $0.09 | $0.05
C16 | 18pF | CAPACITOR0603 | 0603-CAP | Capacitor | $0.12 | $0.09 | $0.05
C17 | 18pF | CAPACITOR0603 | 0603-CAP | Capacitor | $0.12 | $0.09 | $0.05
C18 | 0.1uF | CAPACITOR0603 | 0603-CAP | Capacitor | $0.12 | $0.09 | $0.05
C19 | 0.1uF | CAPACITOR0603 | 0603-CAP | Capacitor | $0.12 | $0.09 | $0.05
D4 | MMDL914 | DIODE-SWITCHING-SOD323 | SOD-323 | Diode | $0.11 | $0.05 | $0.03 | ON Semi | MMDL914
D5 | MMDL914 | DIODE-SWITCHING-SOD323 | SOD-323 | Diode | $0.11 | $0.05 | $0.03 | ON Semi | MMDL914
D6 | MMDL914 | DIODE-SWITCHING-SOD323 | SOD-323 | Diode | $0.11 | $0.05 | $0.03 | ON Semi | MMDL914
D7 | MMDL914 | DIODE-SWITCHING-SOD323 | SOD-323 | Diode | $0.11 | $0.05 | $0.03 | ON Semi | MMDL914
D8 | MMDL914 | DIODE-SWITCHING-SOD323 | SOD-323 | Diode | $0.11 | $0.05 | $0.03 | ON Semi | MMDL914
D9 | MMDL914 | DIODE-SWITCHING-SOD323 | SOD-323 | Diode | $0.11 | $0.05 | $0.03 | ON Semi | MMDL914
D10 | MMDL914 | DIODE-SWITCHING-SOD323 | SOD-323 | Diode | $0.11 | $0.05 | $0.03 | ON Semi | MMDL914
D11 | MMDL914 | DIODE-SWITCHING-SOD323 | SOD-323 | Diode | $0.11 | $0.05 | $0.03 | ON Semi | MMDL914
D12 | MMDL914 | DIODE-SWITCHING-SOD323 | SOD-323 | Diode | $0.11 | $0.05 | $0.03 | ON Semi | MMDL914
D13 | MMDL914 | DIODE-SWITCHING-SOD323 | SOD-323 | Diode | $0.11 | $0.05 | $0.03 | ON Semi | MMDL914
D14 | MMDL914 | DIODE-SWITCHING-SOD323 | SOD-323 | Diode | $0.11 | $0.05 | $0.03 | ON Semi | MMDL914
D15 | MMDL914 | DIODE-SWITCHING-SOD323 | SOD-323 | Diode | $0.11 | $0.05 | $0.03 | ON Semi | MMDL914
D16 | MMDL914 | DIODE-SWITCHING-SOD323 | SOD-323 | Diode | $0.11 | $0.05 | $0.03 | ON Semi | MMDL914
VR | 5V | LDO-3P--5V-SOT23 | SOT-23 | regulator 3-pin | $0.66 | $0.56 | $0.39 | Diodes, Inc. | AP7387-50SA
X1 | 16MHz | 2P3.2X2.5 | 32X25 | Crystal | $0.80 | $0.60 | $0.40 | Epson | FA-238 16.0000MB-K3
U1 | ATmega328P-MU | ATMEGA328MU | MLF32 | Atmega 328P | $3.00 | $2.00 | $1.80 | Atmel | atmega328p-mu
U2 | TL072A | DUALTL072A | SOP08 | Dual Op-Amp | $0.65 | $0.55 | $0.45 | ST | TL072A
RGB | SK2812B_3535 | SMART_LED3535 | SMD_3535 | Smart LED SK6812 WS2812 | $0.60 | $0.50 | $0.40
A | SPST, TACT, MOM | PUSHBTN-MOMB3FS-BLIND | B3FS-BACKMOUNT | Pushbutton Switch | $0.15 | $0.12 | $0.09 | CK | B3FS | Tayda A-3959(3.1mm),A-3961(2.3mm), A-5134(3.14mm,RA)
A# | SPST, TACT, MOM | PUSHBTN-MOMB3FS-BLIND | B3FS-BACKMOUNT | Pushbutton Switch | $0.15 | $0.12 | $0.09 | CK | B3FS | Tayda A-3961(2.3mm), A-5134(3.14mm,RA)
B | SPST, TACT, MOM | PUSHBTN-MOMB3FS-BLIND | B3FS-BACKMOUNT | Pushbutton Switch | $0.15 | $0.12 | $0.09 | CK | B3FS | Tayda A-3961(2.3mm), A-5134(3.14mm,RA)
C | SPST, TACT, MOM | PUSHBTN-MOMB3FS-BLIND | B3FS-BACKMOUNT | Pushbutton Switch | $0.15 | $0.12 | $0.09 | CK | B3FS | Tayda A-3961(2.3mm), A-5134(3.14mm,RA)
C# | SPST, TACT, MOM | PUSHBTN-MOMB3FS-BLIND | B3FS-BACKMOUNT | Pushbutton Switch | $0.15 | $0.12 | $0.09 | CK | B3FS | Tayda A-3961(2.3mm), A-5134(3.14mm,RA)
D | SPST, TACT, MOM | PUSHBTN-MOMB3FS-BLIND | B3FS-BACKMOUNT | Pushbutton Switch | $0.15 | $0.12 | $0.09 | CK | B3FS | Tayda A-3961(2.3mm), A-5134(3.14mm,RA)
D# | SPST, TACT, MOM | PUSHBTN-MOMB3FS-BLIND | B3FS-BACKMOUNT | Pushbutton Switch | $0.15 | $0.12 | $0.09 | CK | B3FS | Tayda A-3961(2.3mm), A-5134(3.14mm,RA)
E | SPST, TACT, MOM | PUSHBTN-MOMB3FS-BLIND | B3FS-BACKMOUNT | Pushbutton Switch | $0.15 | $0.12 | $0.09 | CK | B3FS | Tayda A-3961(2.3mm), A-5134(3.14mm,RA)
F | SPST, TACT, MOM | PUSHBTN-MOMB3FS-BLIND | B3FS-BACKMOUNT | Pushbutton Switch | $0.15 | $0.12 | $0.09 | CK | B3FS | Tayda A-3961(2.3mm), A-5134(3.14mm,RA)
F# | SPST, TACT, MOM | PUSHBTN-MOMB3FS-BLIND | B3FS-BACKMOUNT | Pushbutton Switch | $0.15 | $0.12 | $0.09 | CK | B3FS | Tayda A-3961(2.3mm), A-5134(3.14mm,RA)
G | SPST, TACT, MOM | PUSHBTN-MOMB3FS-BLIND | B3FS-BACKMOUNT | Pushbutton Switch | $0.15 | $0.12 | $0.09 | CK | B3FS | Tayda A-3961(2.3mm), A-5134(3.14mm,RA)
G# | SPST, TACT, MOM | PUSHBTN-MOMB3FS-BLIND | B3FS-BACKMOUNT | Pushbutton Switch | $0.15 | $0.12 | $0.09 | CK | B3FS | Tayda A-3961(2.3mm), A-5134(3.14mm,RA)
C2 | SPST, TACT, MOM | PUSHBTN-MOMB3FS-BLIND | B3FS-BACKMOUNT | Pushbutton Switch | $0.15 | $0.12 | $0.09 | CK | B3FS | Tayda A-3961(2.3mm), A-5134(3.14mm,RA)
GATE2EG | JST, SH, 2P | 02P-SM-VT-SMT | BM02B-SRSS-TB | 2 pin connector | $0.45 | $0.40 | $0.35 | JST | BMB02B-SRSS-TB
KB2VCO | JST, SH, 2P | 02P-SM-VT-SMT | BM02B-SRSS-TB | 2 pin connector | $0.45 | $0.40 | $0.35 | JST | BMB02B-SRSS-TB
TRIG2EG | JST, SH, 2P | 02P-SM-VT-SMT | BM02B-SRSS-TB | 2 pin connector | $0.45 | $0.40 | $0.35 | JST | BMB02B-SRSS-TB
PWR | JST, SH, 3P | Wire harness | BM03B-SRSS-TB | 3 pin connector | $0.60 | $0.45 | $0.38 | JST | BM03B-SRSS-TB
ICSP | JAS, SH, 6P | 06P-SM-VT-SMT | BM06B-SRSS-TB | Connector, 6P | $0.60 | $0.52 | $0.49 | JST | BM06-SRSS-TB
GLIDE | 1M | TRIMPOT9MM_PCB_SHAFT | POT-RV9110 | Potentiometer | $0.70 | $0.60 | $0.60 | Tayda | RV9110NO-OS15A00 | Tayda A-5517
 |  |  |  | Parts: | $15.86 | $11.28 | $8.81
