CircuitMonkey/synth-zodiac/Documents/Layouts/layout-bottom-3-wiring.png

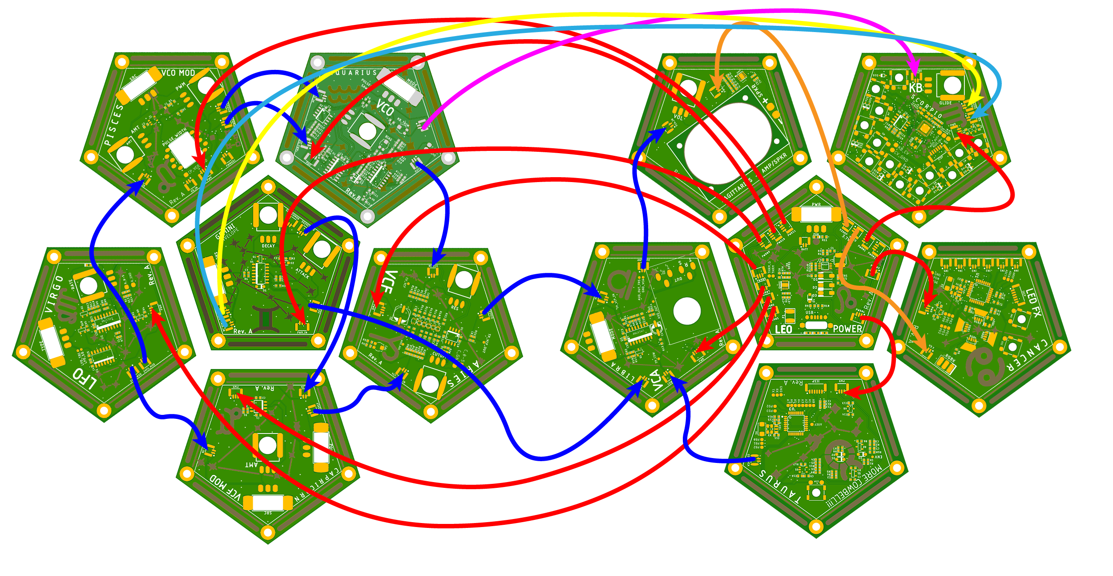
Documents/Layouts/layout-bottom-3-wiring.png
