CircuitMonkey/synth-zodiac/PCB/synth-zodiac-aquarius-vco-sch-b.pdf

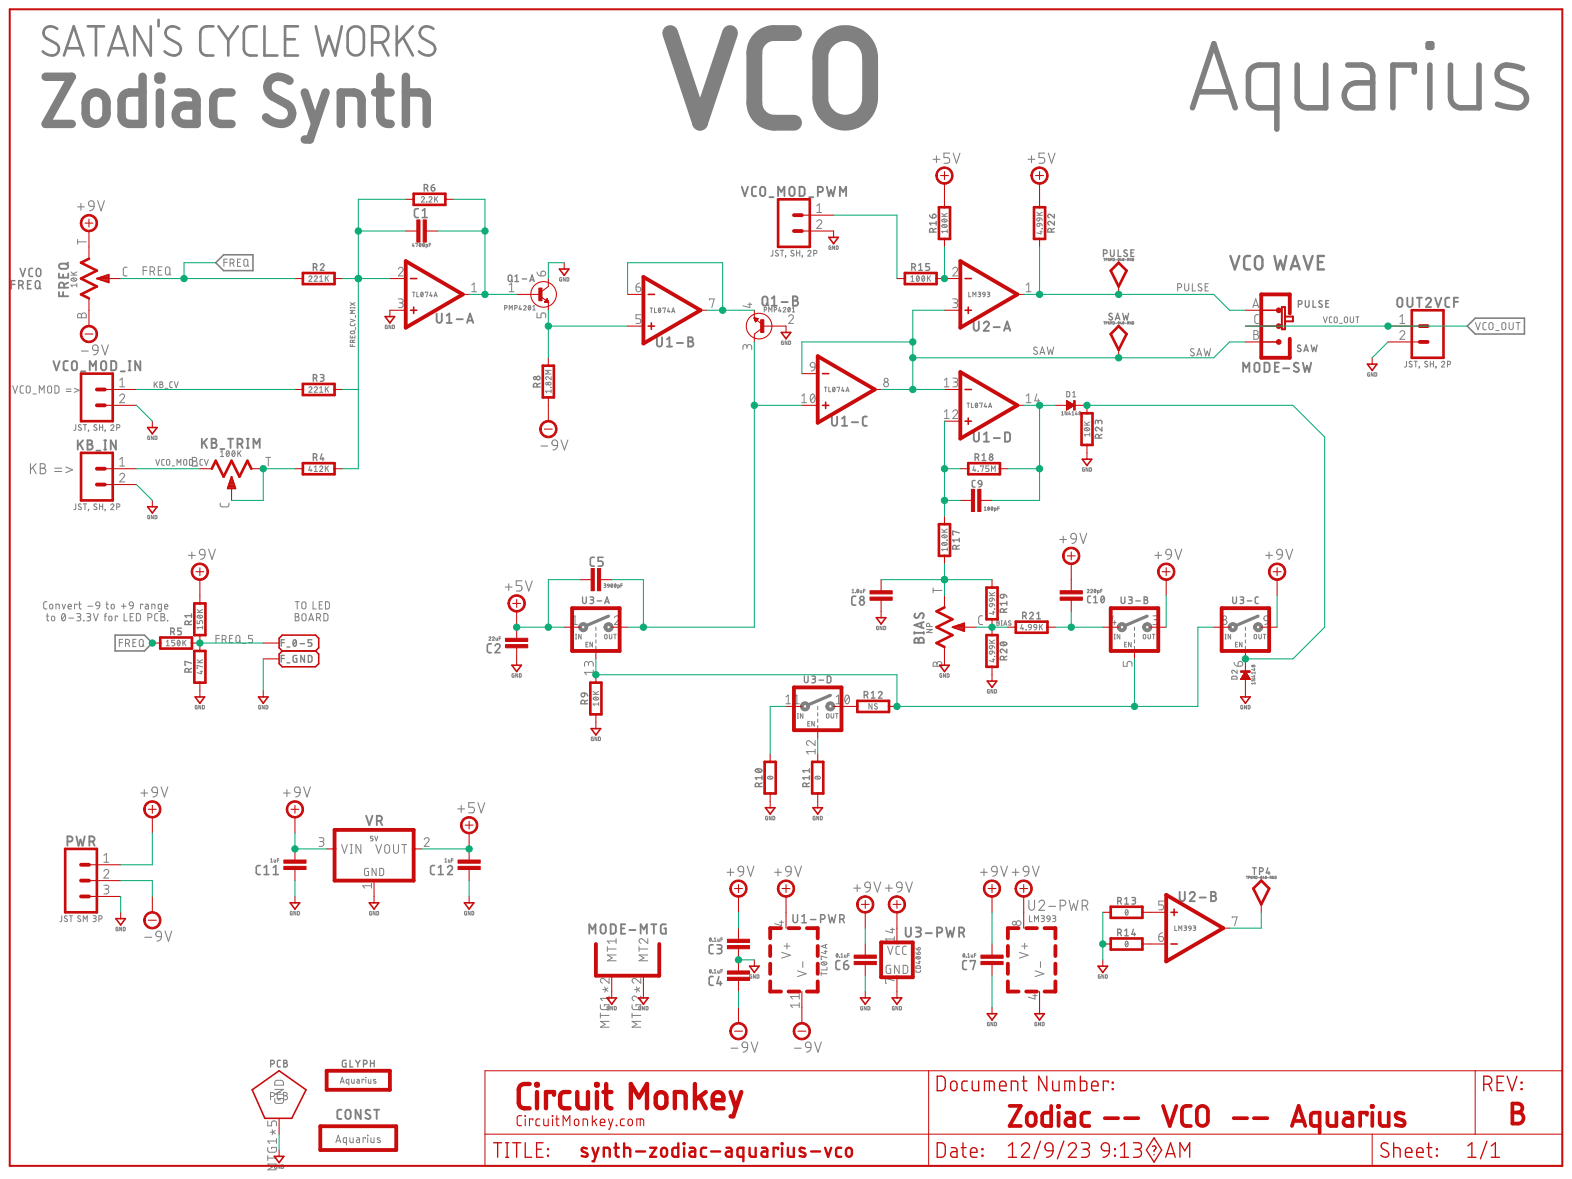
[picture p10: page 1]
