CircuitMonkey/synth-zodiac/Documents/synth-zodiac-aquarius-vco-sch-b.pdf

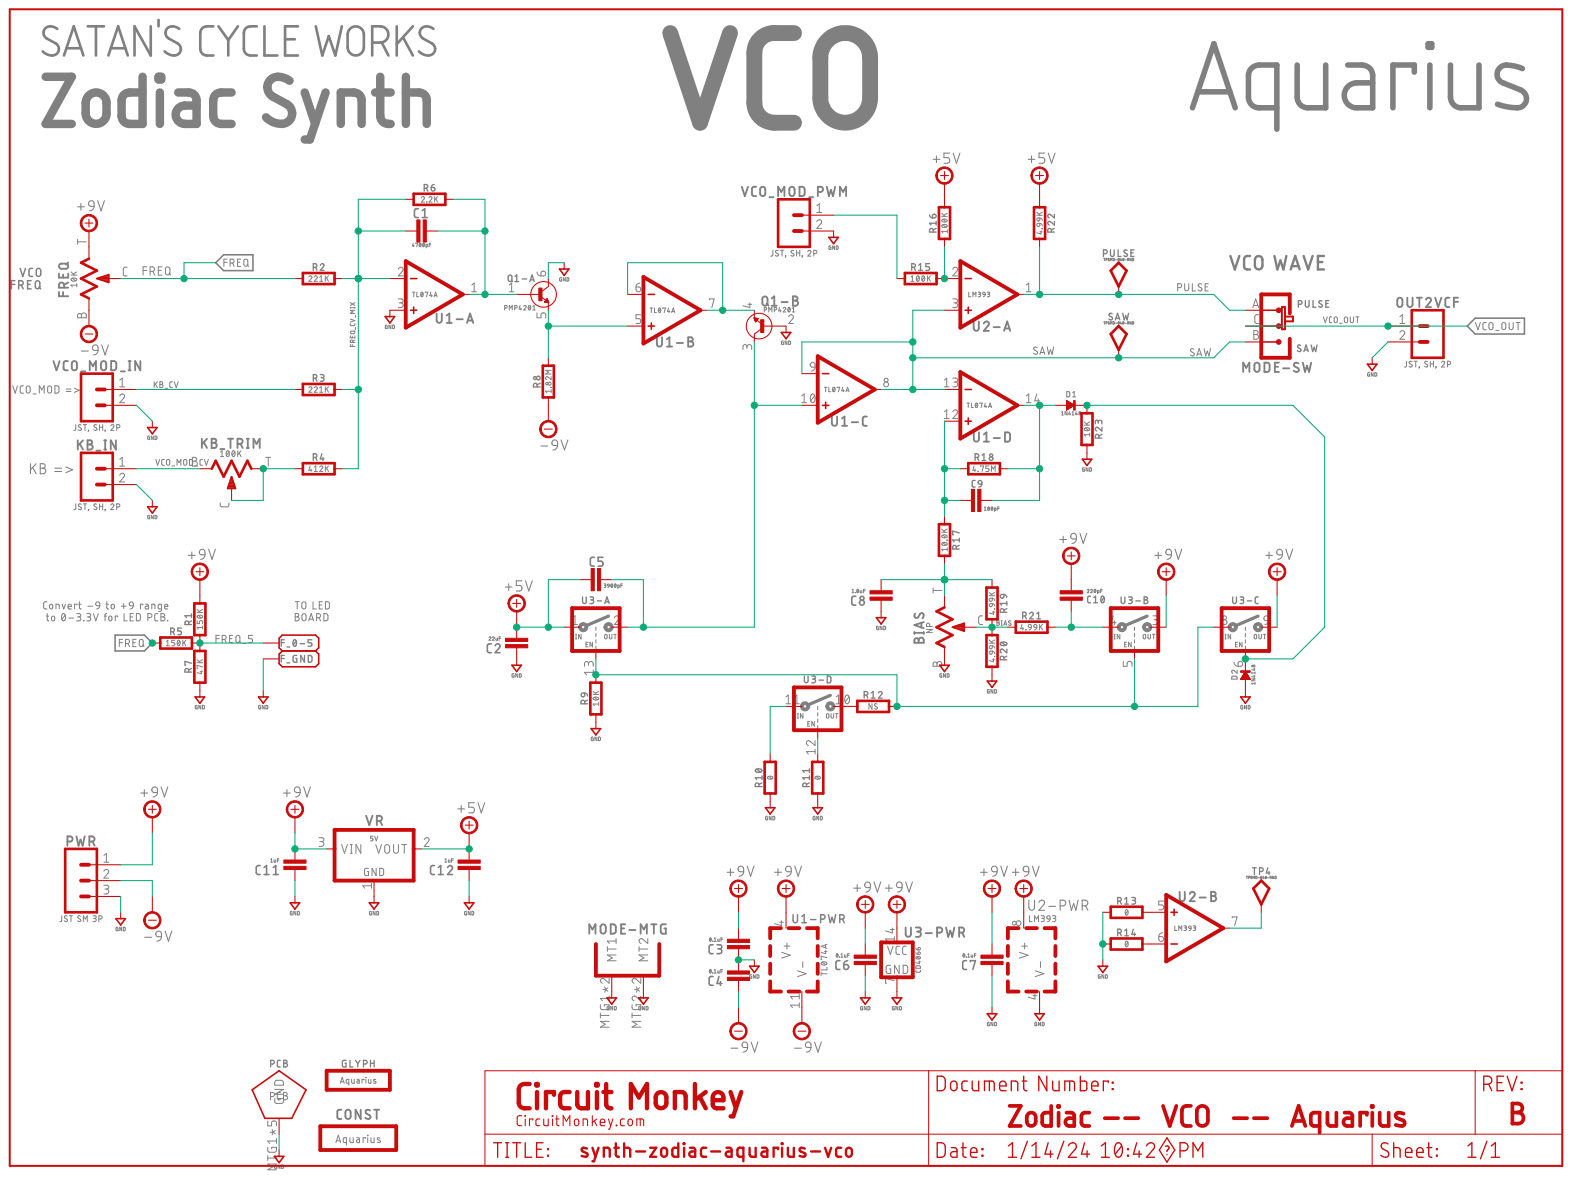
[picture p11: page 1]
