CircuitMonkey/synth-zodiac/Documents/synth-zodiac-leo-power-sch-a.pdf

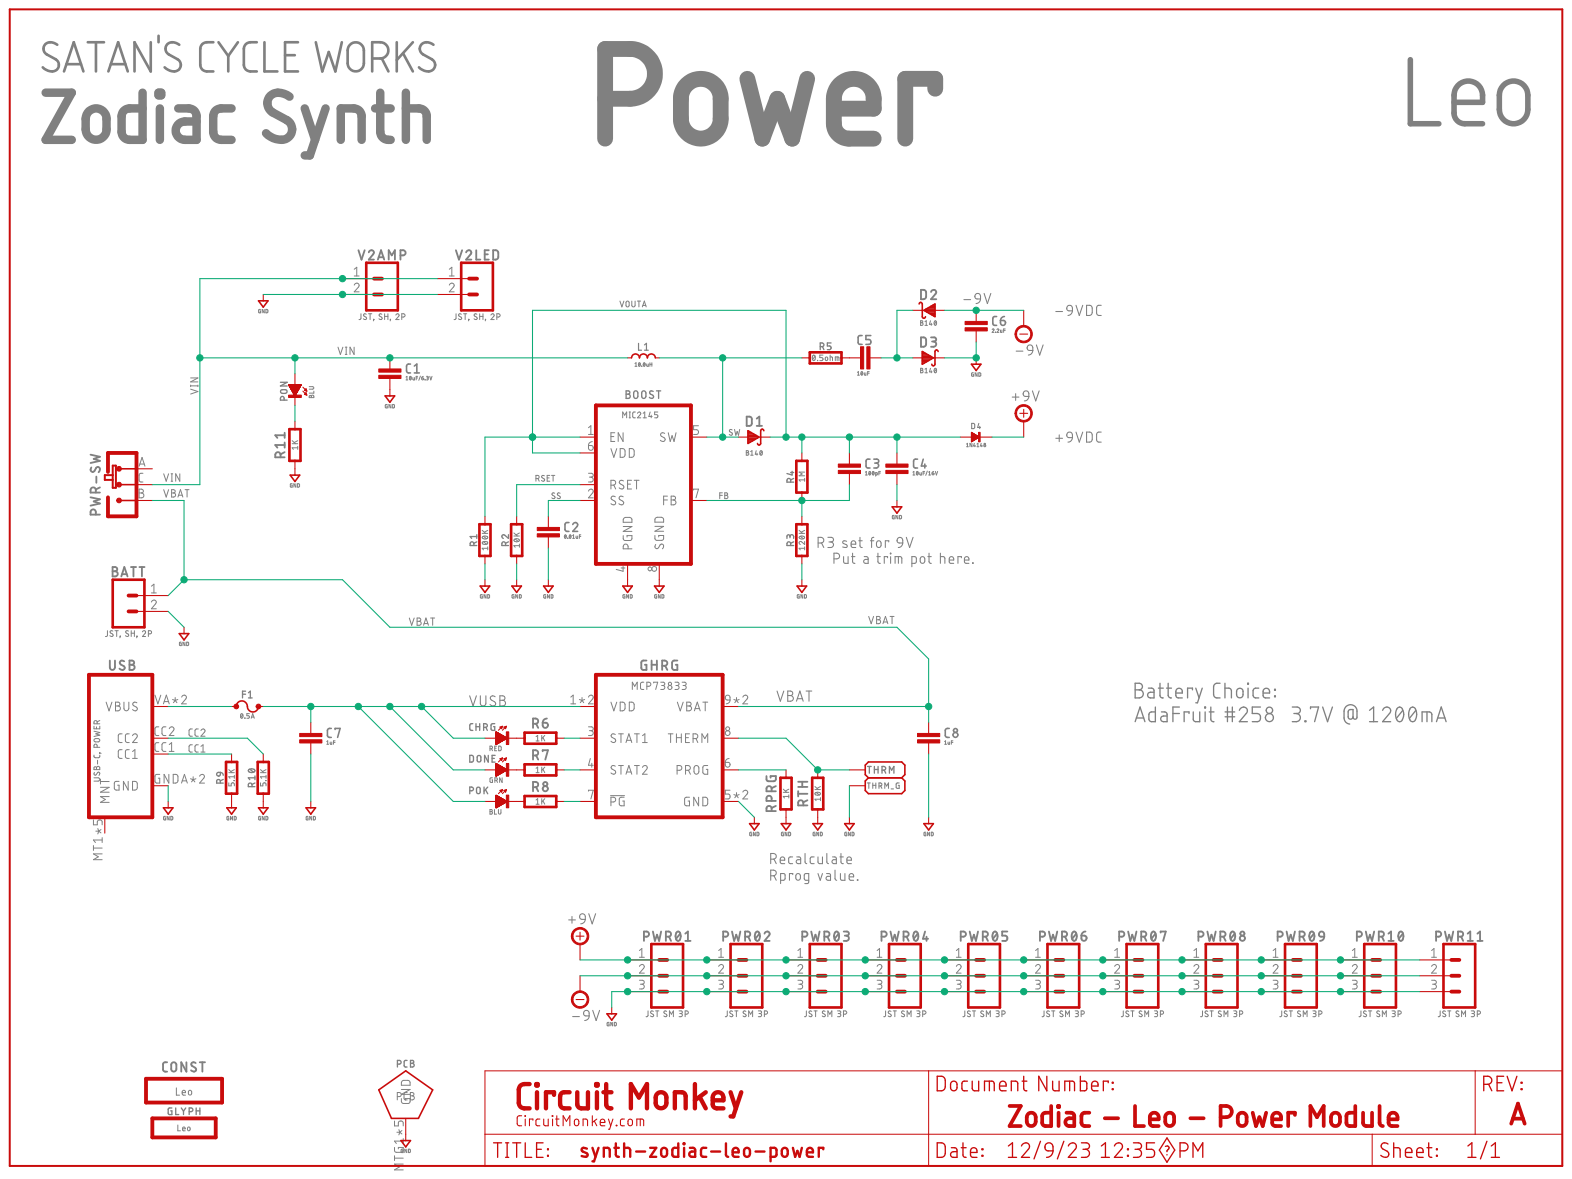
[picture p12: page 1]
