CircuitMonkey/synth-zodiac/Documents/synth-zodiac-aquarius-vco-sch-a.pdf

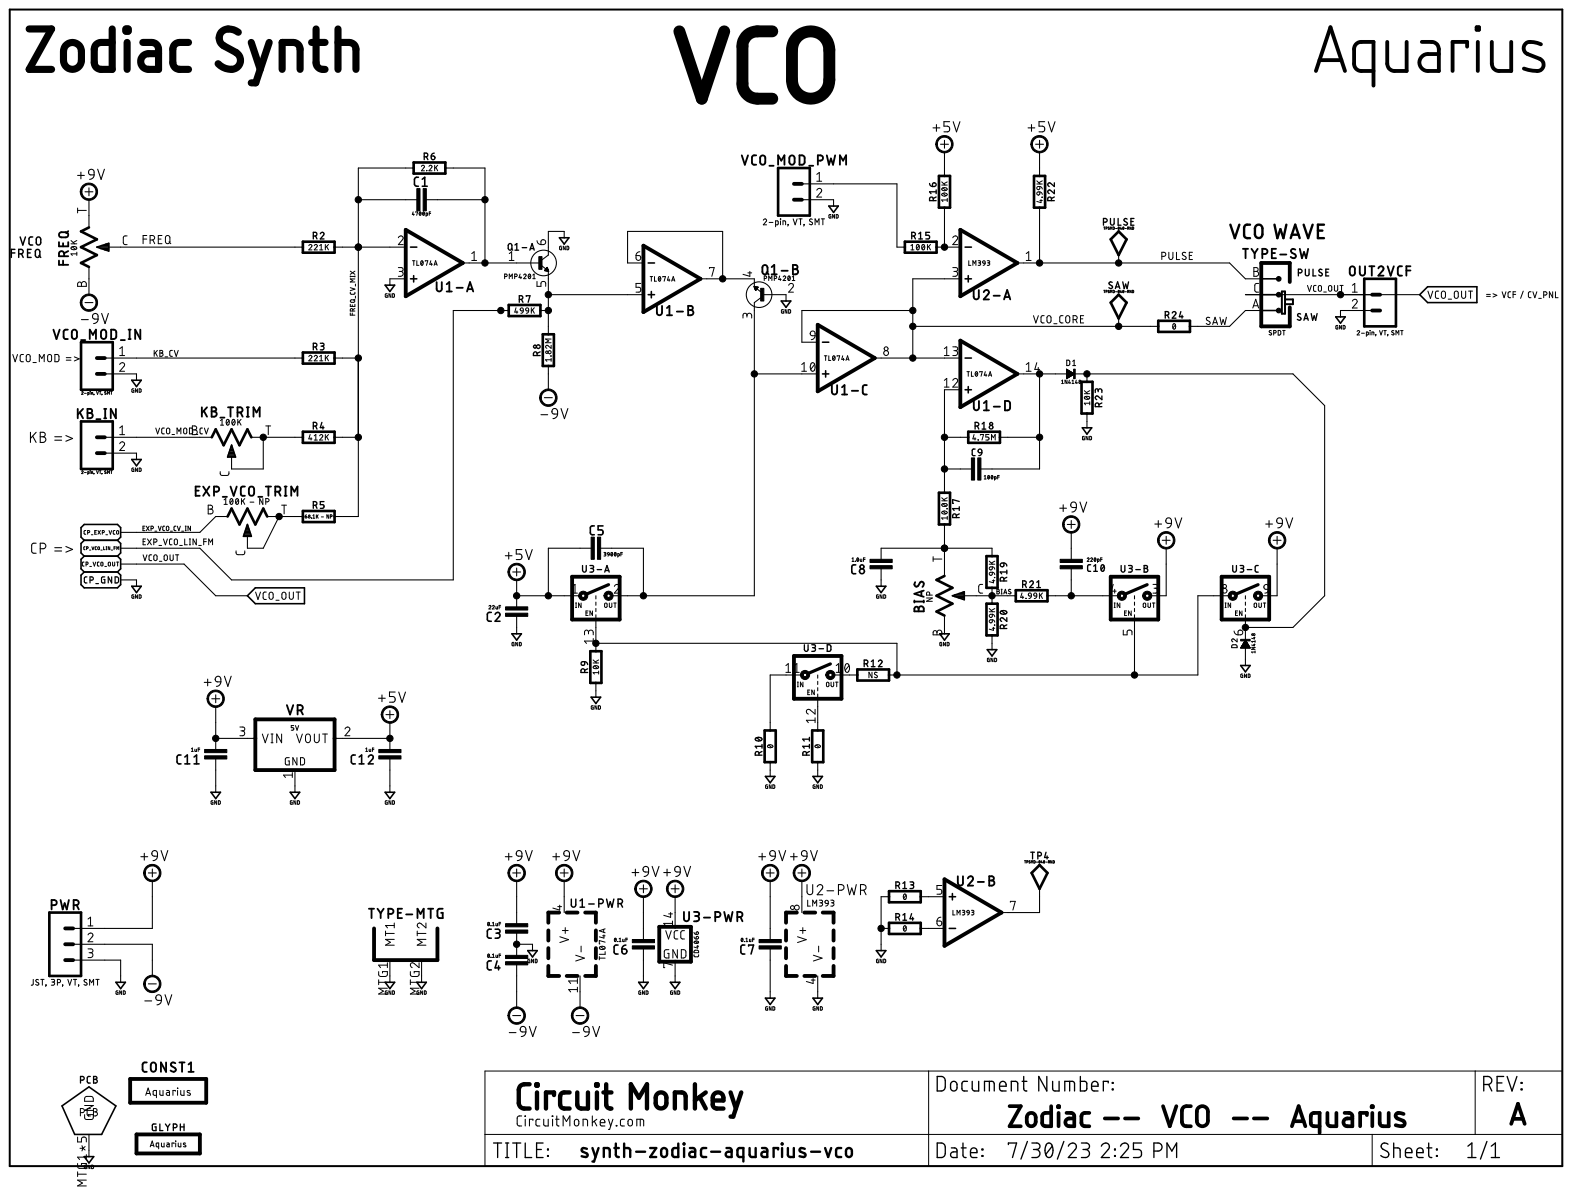
[picture p13: page 1]
