CircuitMonkey/synth-zodiac/PCB/synth-zodiac-leo-power.brd

## EAGLE design PCB/synth-zodiac-leo-power.brd (2024-01-27)

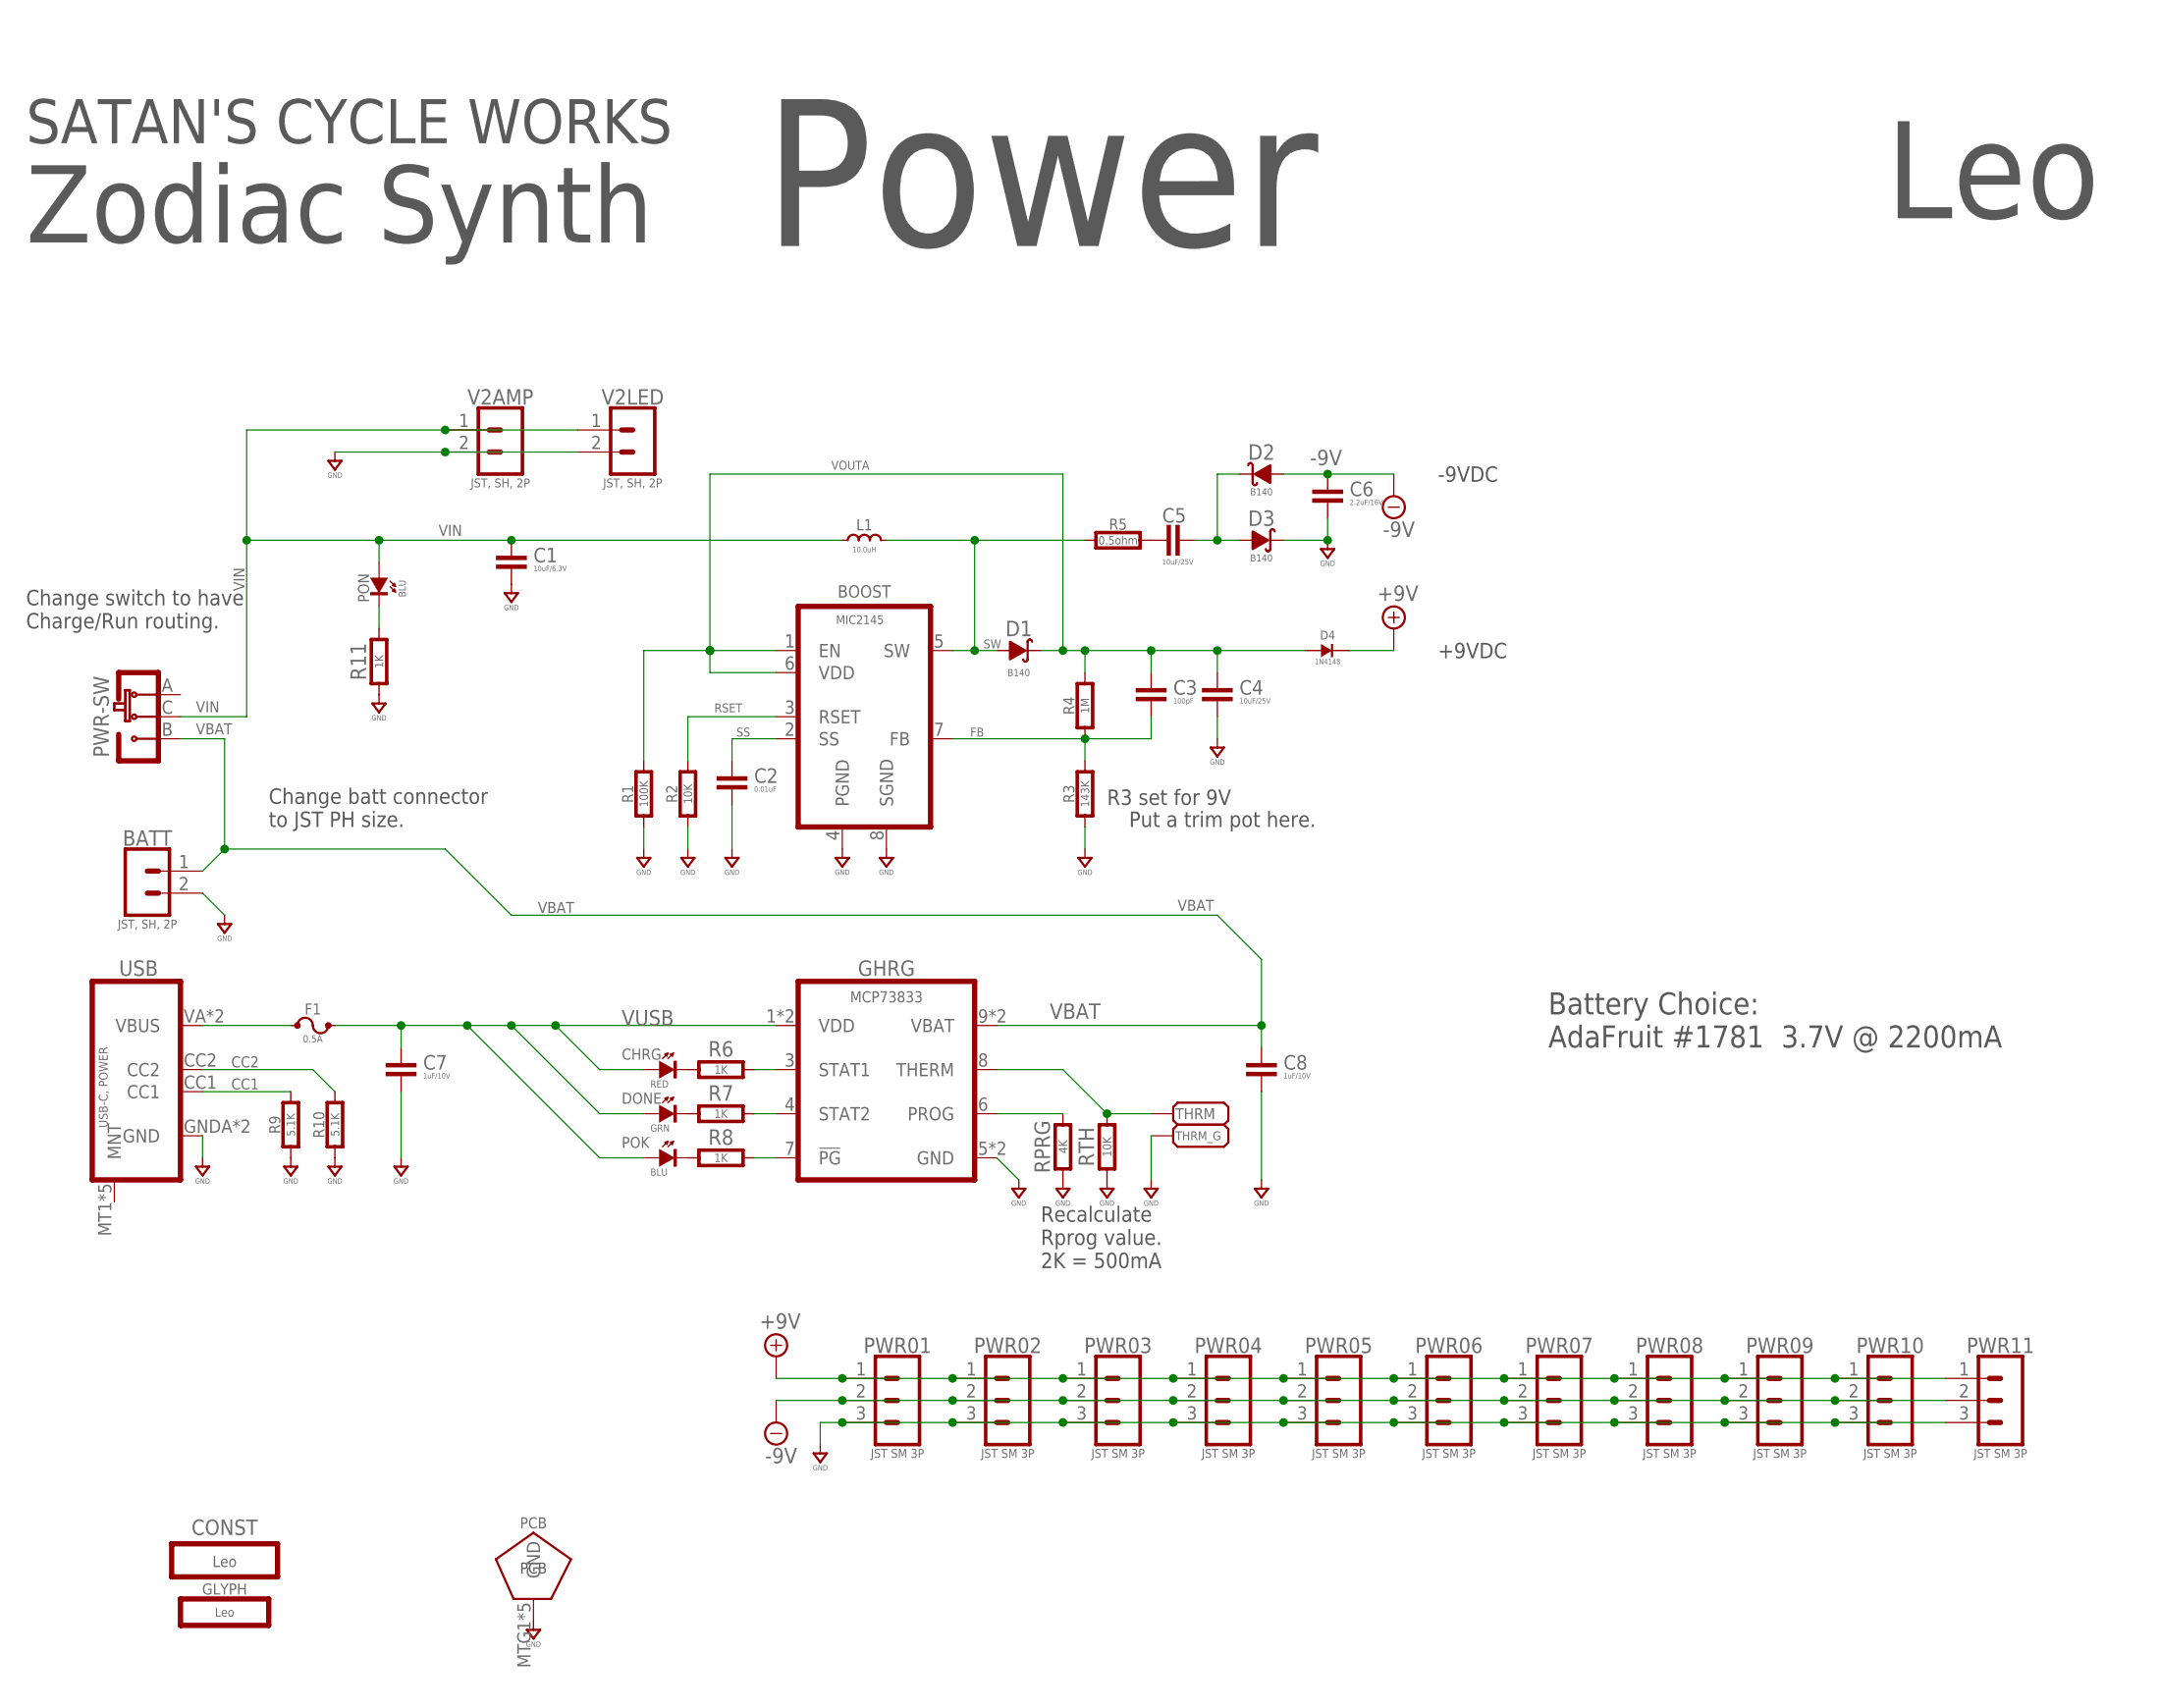
[picture p14: schematic synth-zodiac-leo-power.sch]

Parts:
BATT: JST, SH, 2P; BM02B-SRSS-TB
BOOST: MIC2145; MSOP8-0.65
C1: 10uF/6.3V; 0603-CAP
C2: 0.01uF; 0603-CAP
C3: 100pF; 0603-CAP
C4, C5: 10uF/25V; 0603-CAP
C6: 2.2uF/16V; 0603-CAP
C7, C8: 1uF/10V; 0603-CAP
CHRG: RED; SMD_0603
CONST: Leo; LEO-CONST
D1, D2, D3: B140; SMA
D4: 1N4148; SOD-123
DONE: GRN; SMD_0603
F1: 0.5A; BOURNS-MF-MSMF
GHRG: MCP73833; DFN-10-3X3
GLYPH: Leo; LEO-GLYPH
L1: 10.0uH; IND-SRN5040
PCB: PCB FAB; PENTAGON-40MM-RAD
POK: BLU; SMD_0603
PON: BLU; SMD_0603
PWR: SLIDE-SPDT-MNTSS-12-F45-TH-PCB-2; SS-12-F45-PNL-SMT-2
PWR01, PWR02, PWR03, PWR04, PWR05, PWR06, PWR07, PWR08, PWR09, PWR10, PWR11: JST SM 3P; BM03B-SRSS-TB
R1: 100K; 0603-RES
R2: 10K; 0603-RES
R3: 143K; 0603-RES
R4: 1M; 0603-RES
R5: 0.5ohm; 0603-RES
R6, R7, R8, R11: 1K; 0603-RES
R9, R10: 5.1K; 0603-RES
RPRG: 4K; 0603-RES
RTH: 10K; 0603-RES
THRM: PADSMD-050X050; SMD-050X050
THRM_G: PADSMD-050X050; SMD-050X050
USB: USB-C, POWER; GCT-USB4515-PANEL
V2AMP, V2LED: JST, SH, 2P; BM02B-SRSS-TB

Connections:
+9V: D4.K, PWR01.1, PWR02.1, PWR03.1, PWR04.1, PWR05.1, PWR06.1, PWR07.1, PWR08.1, PWR09.1, PWR10.1, PWR11.1
-9V: C6.1, D2.A, PWR01.2, PWR02.2, PWR03.2, PWR04.2, PWR05.2, PWR06.2, PWR07.2, PWR08.2, PWR09.2, PWR10.2, PWR11.2
CC1: R9.2, USB.CC1
CC2: R10.2, USB.CC2
FB: BOOST.7 (FB), C3.2, R3.2, R4.1
GND: BATT.2, BOOST.4 (PGND), BOOST.8 (SGND), C1.2, C2.2, C4.2, C6.2, C7.2, C8.2, D3.K, GHRG.5 (GND), GHRG.PAD (GND), PCB.MTG1, PCB.MTG2, PCB.MTG3, PCB.MTG4, PCB.MTG5, PWR01.3, PWR02.3, PWR03.3, PWR04.3, PWR05.3, PWR06.3, PWR07.3, PWR08.3, PWR09.3, PWR10.3, PWR11.3, R1.1, R2.1, R3.1, R9.1, R10.1, R11.1, RPRG.1, RTH.1, THRM_G.1, USB.GNDA (GND), USB.GNDB (GND), V2AMP.2, V2LED.2
unnamed: C5.1, R5.2
unnamed: C5.2, D2.K, D3.A
unnamed: CHRG.K (C), R6.1
unnamed: PON.K (C), R11.2
unnamed: DONE.K (C), R7.1
unnamed: POK.K (C), R8.1
unnamed: GHRG.6 (PROG), RPRG.2
unnamed: GHRG.3 (STAT1), R6.2
unnamed: GHRG.4 (STAT2), R7.2
unnamed: GHRG.7 (!PG), R8.2
unnamed: GHRG.8 (THERM), RTH.2, THRM.1
RSET: BOOST.3 (RSET), R2.2
SS: BOOST.2 (SS), C2.1
SW: BOOST.5 (SW), D1.A, L1.1, R5.1
VBAT: BATT.1, C8.1, GHRG.9 (VBAT), GHRG.10 (VBAT), PWR.B
VBUS: F1.1, USB.VA (VBUS), USB.VB (VBUS)
VIN: C1.1, L1.2, PON.A, PWR.C, V2AMP.1, V2LED.1
VOUTA: BOOST.1 (EN), BOOST.6 (VDD), C3.1, C4.1, D1.K, D4.A, R1.2, R4.2
VUSB: C7.1, CHRG.A, DONE.A, F1.2, GHRG.1 (VDD), GHRG.2 (VDD), POK.A

Notes on the sheet:
Battery Choice: AdaFruit #1781 3.7V @ 2200mA
R3 set for 9V
-9VDC
+9VDC
Put a trim pot here.
Recalculate Rprog value. 2K = 500mA
Power
Zodiac Synth
Leo
SATAN'S CYCLE WORKS
Change switch to have Charge/Run routing.
Change batt connector to JST PH size.

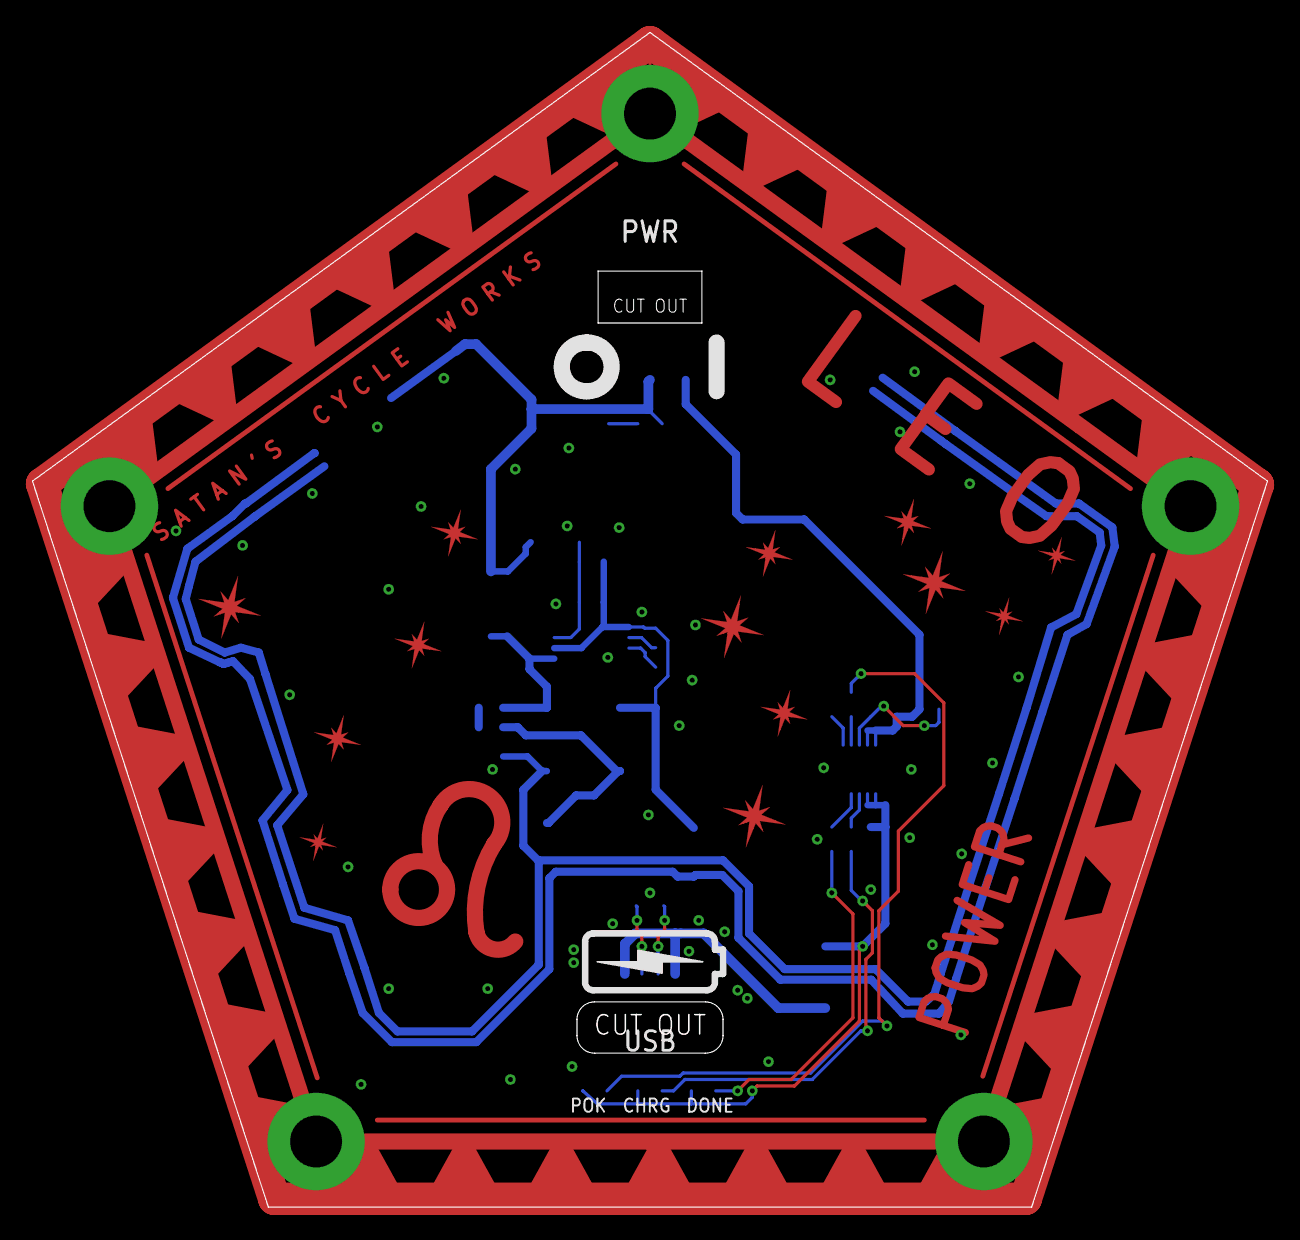
[picture p15: board synth-zodiac-leo-power.brd from above]

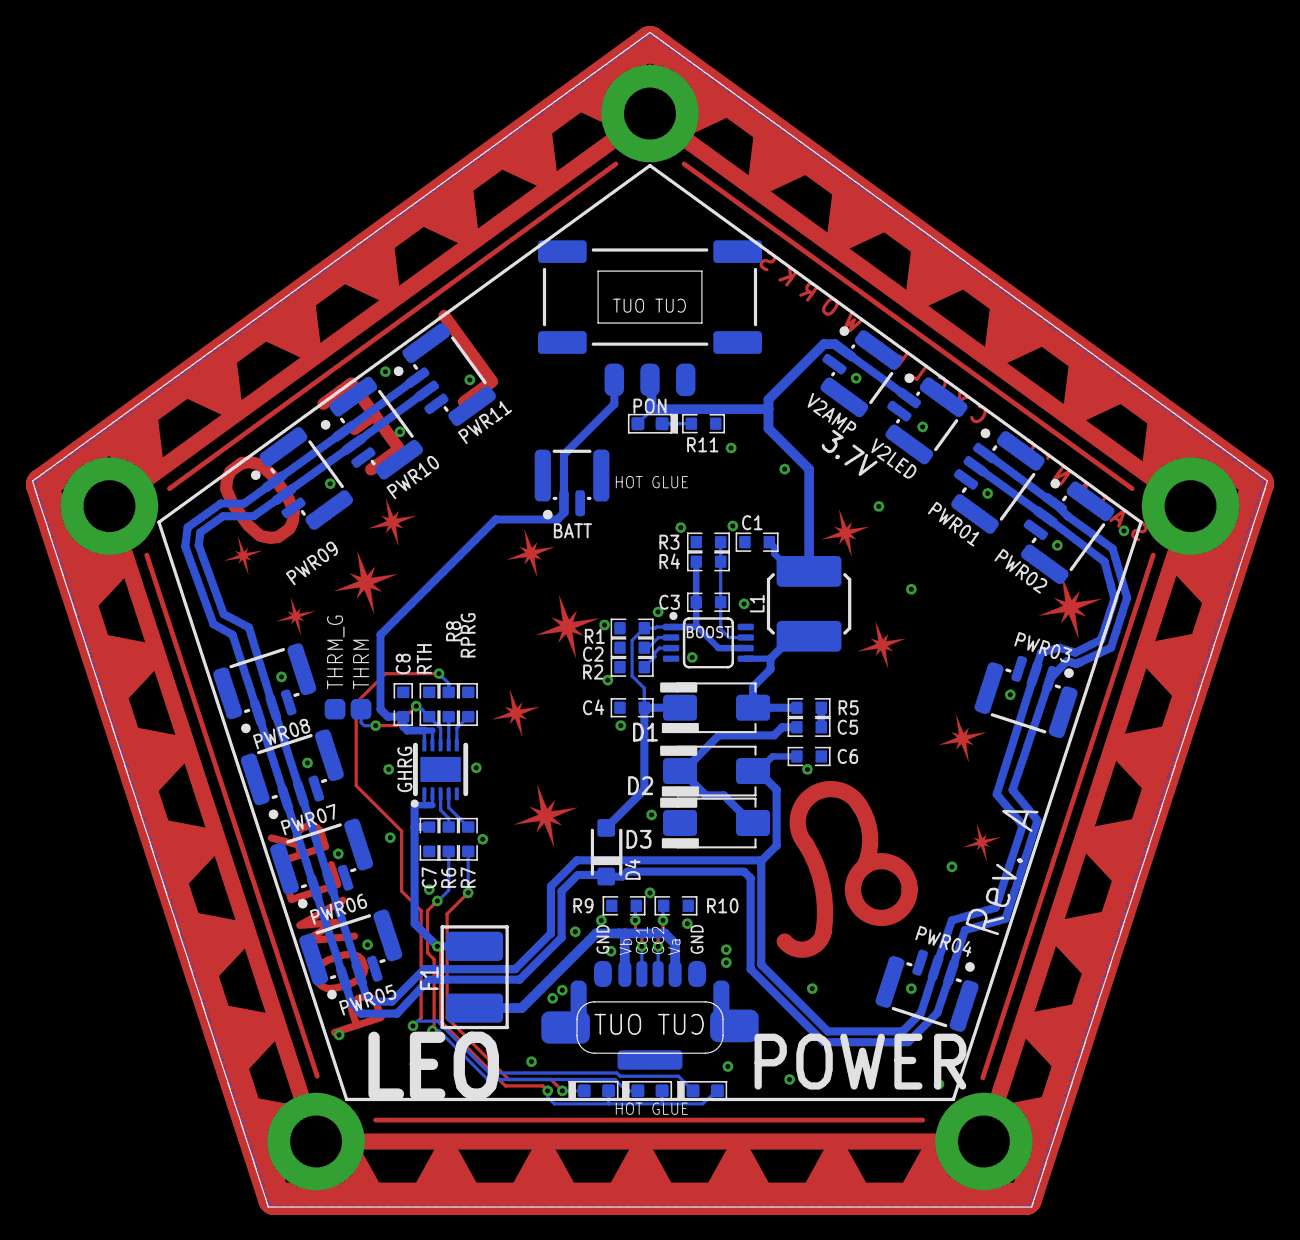
[picture p16: board synth-zodiac-leo-power.brd from below]

Board: 2 copper layers, 76.1 x 72.4 mm, 54 parts (49 on the bottom side), 25 nets.
