CircuitMonkey/synth-zodiac/PCB/synth-zodiac-taurus-cowbell.brd

## EAGLE design PCB/synth-zodiac-taurus-cowbell.brd (2024-01-21)

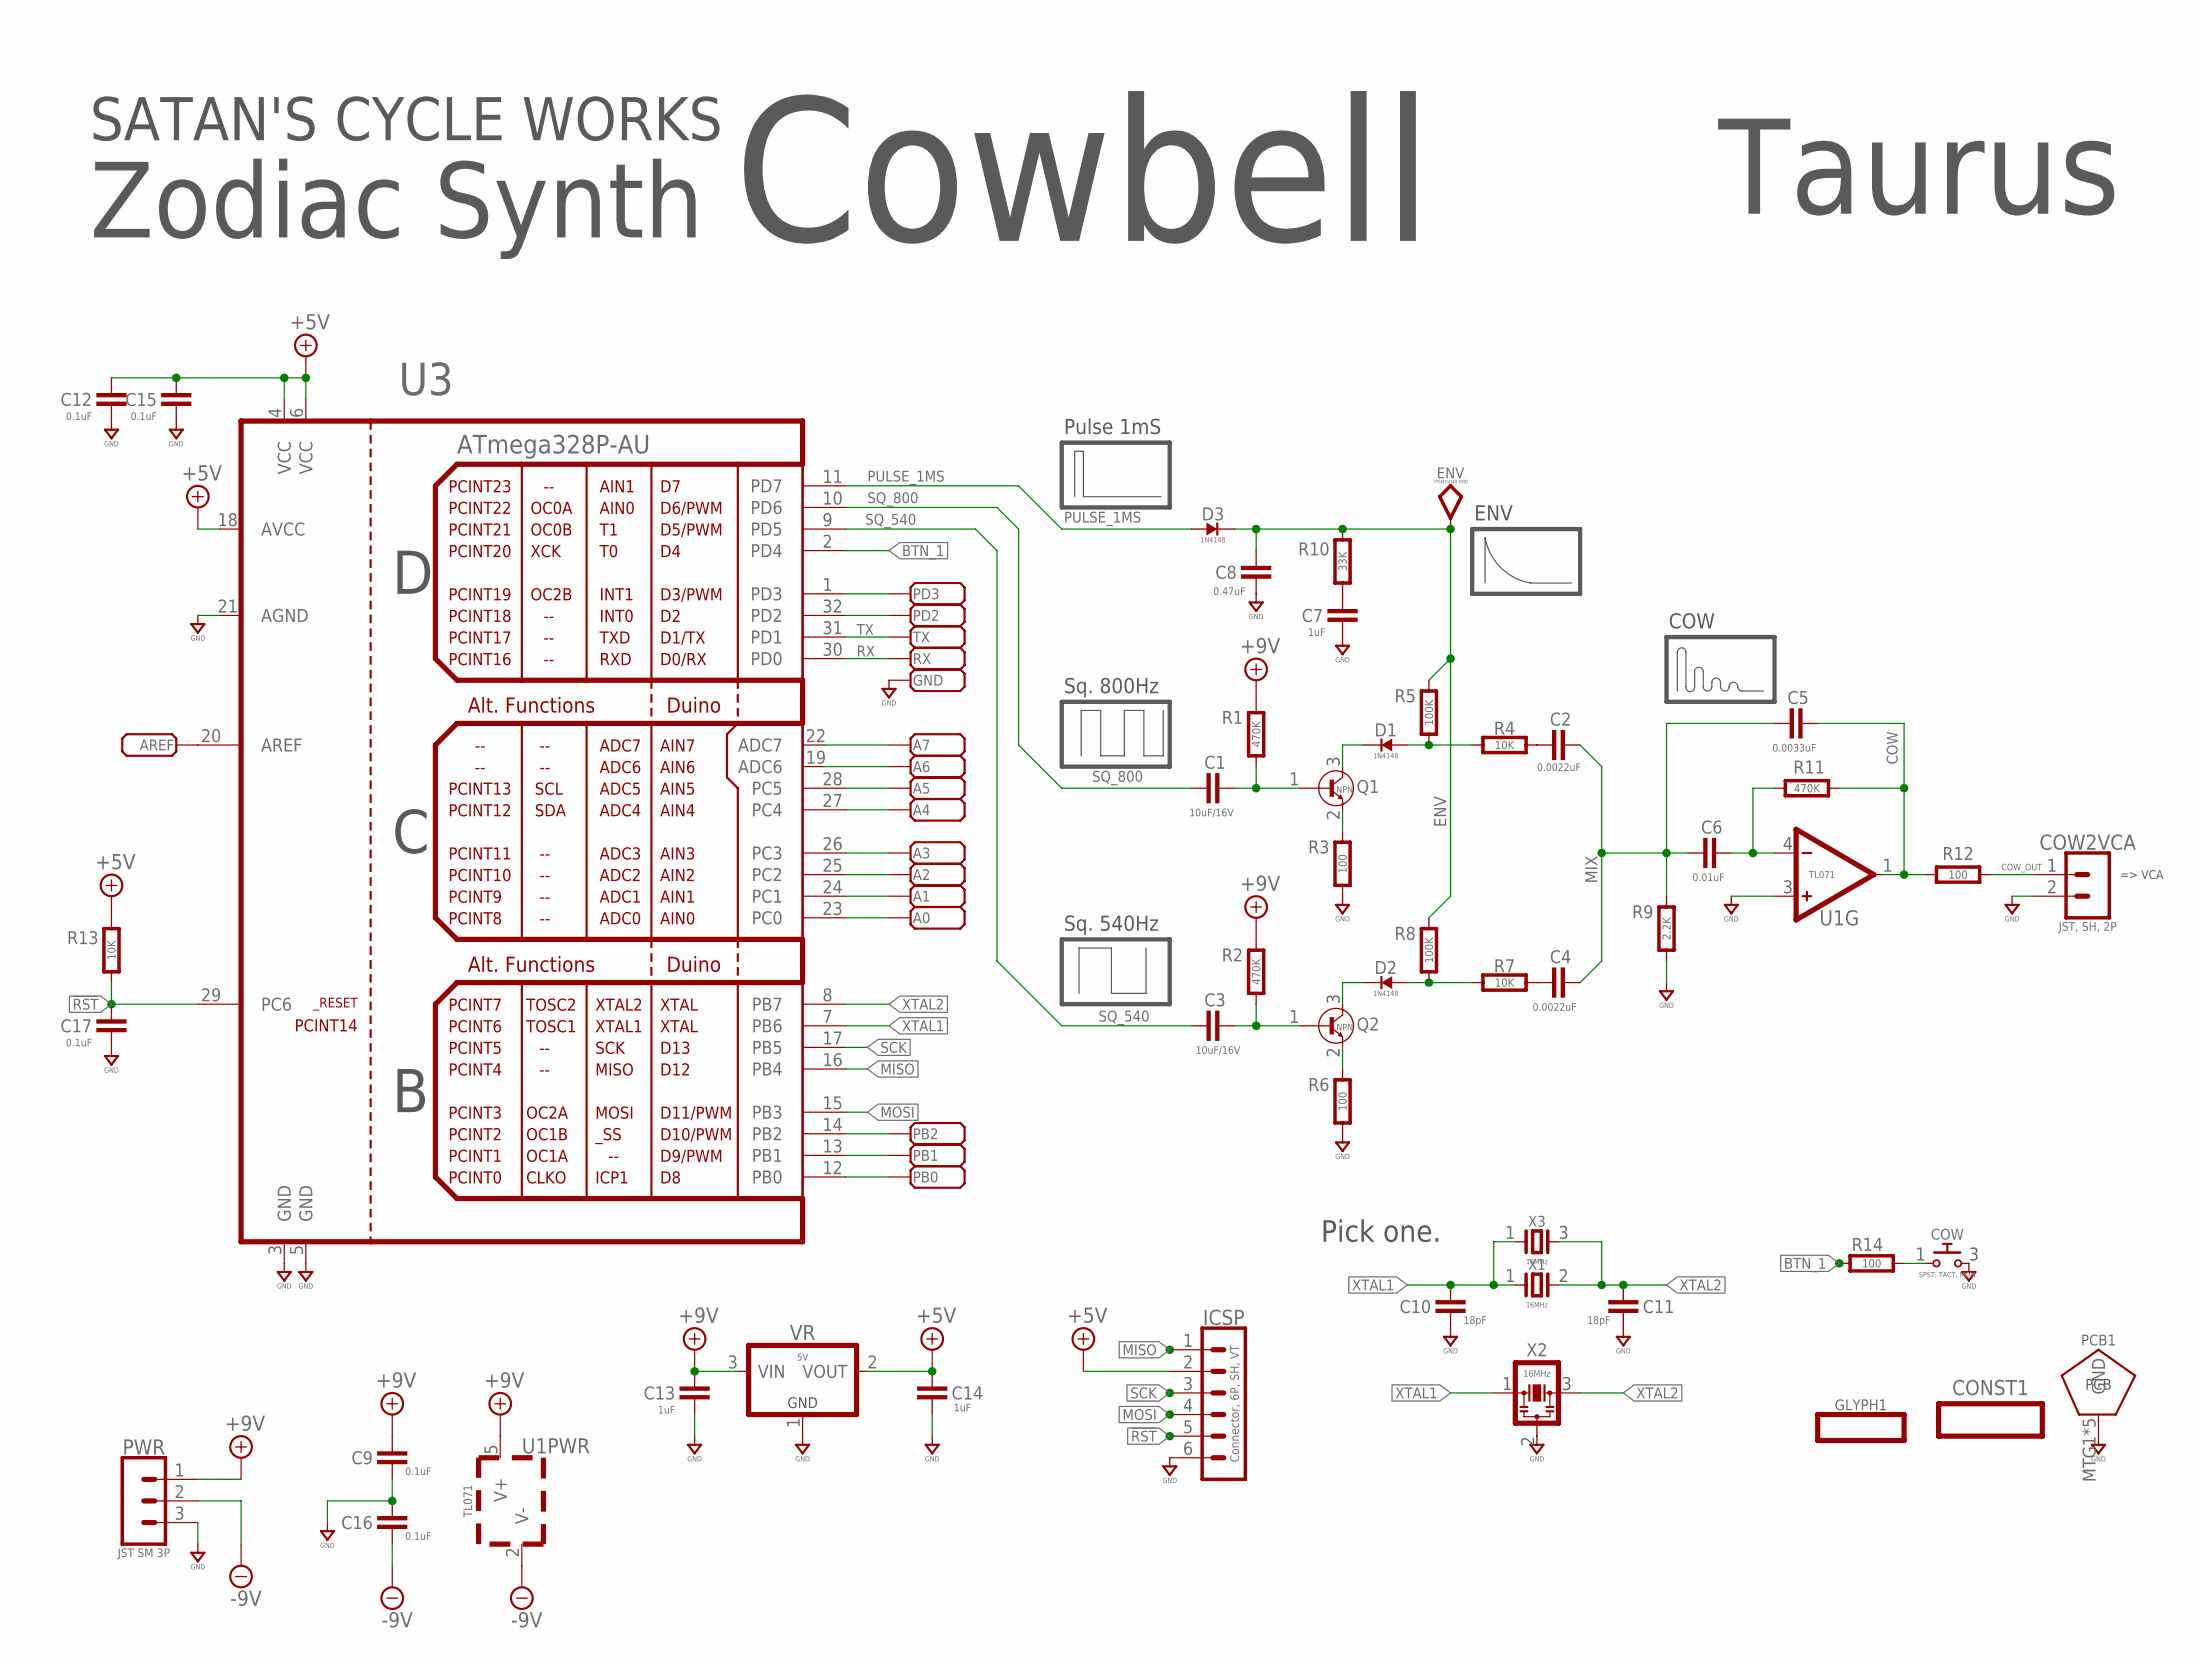
[picture p17: schematic synth-zodiac-taurus-cowbell.sch]

Parts:
A0, A1, A2, A3, A4, A5, A6, A7: PADSMD-050X050; SMD-050X050
AREF: PADSMD-050X050; SMD-050X050
C1, C3: 10uF/16V; 0603-CAP
C2, C4: 0.0022uF; 0603-CAP
C5: 0.0033uF; 0603-CAP
C6: 0.01uF; 0603-CAP
C7, C13, C14: 1uF; 0603-CAP
C8: 0.47uF; 0603-CAP
C9, C12, C15, C16, C17: 0.1uF; 0603-CAP
C10, C11: 18pF; 0603-CAP
CONST1: CONSTELLATION-TAURUS; TAURUS-CONST
COW: SPST, TACT, MOM; B3FS-BACKMOUNT
COW2VCA: JST, SH, 2P; BM02B-SRSS-TB
D1, D2, D3: 1N4148; SOD-123
ENV: TPSMD-040-RND; SMD-040MIL-RND
GLYPH1: GLYPH-TAURUS; TAURUS-GLYPH
GND: PADSMD-050X050; SMD-050X050
ICSP: Connector, 6P, SH, VT; BM06B-SRSS-TB
PB0, PB1, PB2: PADSMD-050X050; SMD-050X050
PCB1: PCB FAB; PENTAGON-40MM-RAD
PD2, PD3: PADSMD-050X050; SMD-050X050
PWR: JST SM 3P; BM03B-SRSS-TB
Q1, Q2: NPN; SOT-23
R1, R2, R11: 470K; 0603-RES
R3, R6, R12, R14: 100; 0603-RES
R4, R7, R13: 10K; 0603-RES
R5, R8: 100K; 0603-RES
R9: 2.2K; 0603-RES
R10: 33K; 0603-RES
RX: PADSMD-050X050; SMD-050X050
TX: PADSMD-050X050; SMD-050X050
U1: TL071; SOT-23-5
U3: ATmega328P-AU; TQFP-32-08
VR: 5V; SOT-23
X1: 16MHz; CTS_5X3
X2: 16MHz; CSTE-RESONATOR
X3: 16MHz; 32X25

Connections:
!RST: C17.1, ICSP.5, R13.2, U3.29 (PC6)
+5V: C12.1, C14.1, C15.1, ICSP.2, R13.1, U3.4 (VCC), U3.6 (VCC), U3.18 (AVCC), VR.2 (VOUT)
+9V: C9.1, C13.1, PWR.1, R1.2, R2.2, U1.5 (V+), VR.3 (VIN)
-9V: C16.2, PWR.2, U1.2 (V-)
BTN_1: R14.1, U3.2 (PD4)
COW: C5.2, R11.2, R12.1, U1.1 (OUT)
COW_OUT: COW2VCA.1, R12.2
ENV: C8.1, D3.K, ENV.TP, R5.2, R8.2, R10.1
GND: C7.2, C8.2, C9.2, C10.2, C11.2, C12.2, C13.2, C14.2, C15.2, C16.1, C17.2, COW.3 (2), COW2VCA.2, GND.1, ICSP.6, PCB1.MTG1, PCB1.MTG2, PCB1.MTG3, PCB1.MTG4, PCB1.MTG5, PWR.3, R3.1, R6.1, R9.1, U1.3 (+), U3.3 (GND), U3.5 (GND), U3.21 (AGND), VR.1 (GND), X2.2
MISO: ICSP.1, U3.16 (PB4)
MIX: C2.2, C4.2, C5.1, C6.1, R9.2
MOSI: ICSP.4, U3.15 (PB3)
unnamed: D1.K, Q1.3 (COLLECTOR)
unnamed: Q1.2 (EMITTER), R3.2
unnamed: C1.2, Q1.1 (BASE), R1.1
unnamed: D1.A, R4.1, R5.1
unnamed: C2.1, R4.2
unnamed: D2.K, Q2.3 (COLLECTOR)
unnamed: Q2.2 (EMITTER), R6.2
unnamed: C3.2, Q2.1 (BASE), R2.1
unnamed: D2.A, R7.1, R8.1
unnamed: C4.1, R7.2
unnamed: COW.1, R14.2
unnamed: PD3.1, U3.1 (PD3)
unnamed: C6.2, R11.1, U1.4 (-)
unnamed: PD2.1, U3.32 (PD2)
unnamed: C7.1, R10.2
unnamed: PB2.1, U3.14 (PB2)
unnamed: PB1.1, U3.13 (PB1)
unnamed: PB0.1, U3.12 (PB0)
unnamed: A0.1, U3.23 (PC0)
unnamed: A1.1, U3.24 (PC1)
unnamed: A2.1, U3.25 (PC2)
unnamed: A3.1, U3.26 (PC3)
unnamed: A4.1, U3.27 (PC4)
unnamed: A5.1, U3.28 (PC5)
unnamed: A6.1, U3.19 (ADC6)
unnamed: A7.1, U3.22 (ADC7)
unnamed: AREF.1, U3.20 (AREF)
PULSE_1MS: D3.A, U3.11 (PD7)
RX: RX.1, U3.30 (PD0)
SCK: ICSP.3, U3.17 (PB5)
SQ_540: C3.1, U3.9 (PD5)
SQ_800: C1.1, U3.10 (PD6)
TX: TX.1, U3.31 (PD1)
XTAL1: C10.1, U3.7 (PB6), X1.1, X2.1, X3.1
XTAL2: C11.1, U3.8 (PB7), X1.2, X2.3, X3.3

Notes on the sheet:
=> VCA
ENV
Pulse 1mS
Pick one.
Sq. 800Hz
Sq. 540Hz
COW
Cowbell
Zodiac Synth
Taurus
SATAN'S CYCLE WORKS

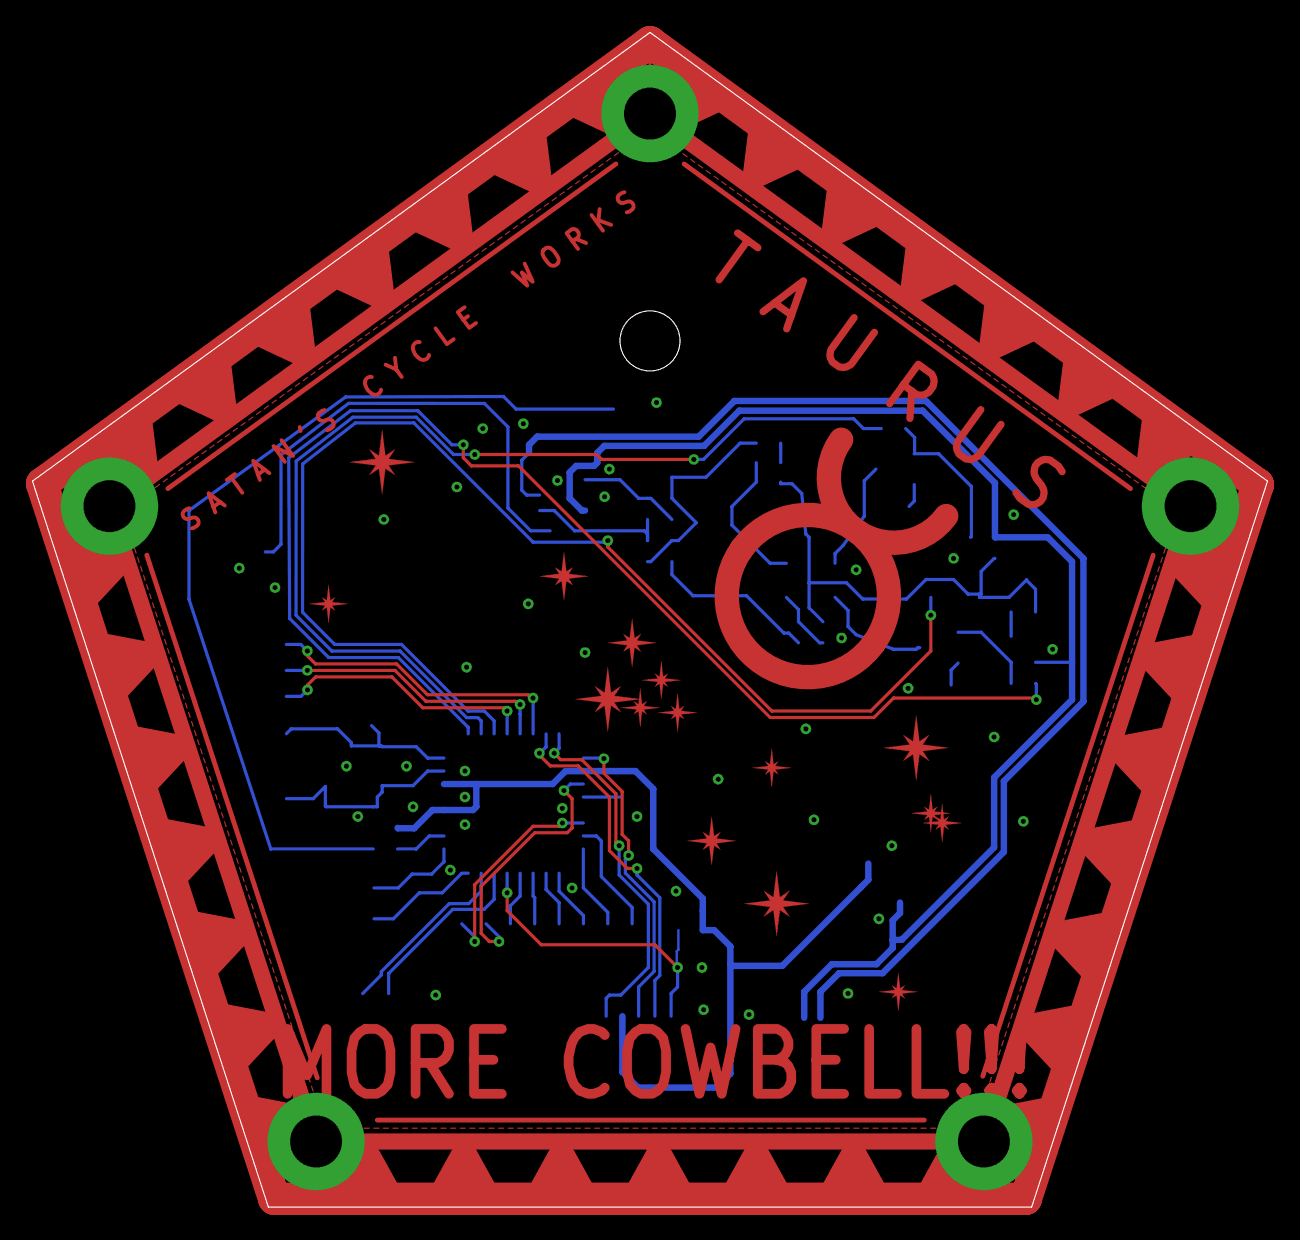
[picture p18: board synth-zodiac-taurus-cowbell.brd from above]

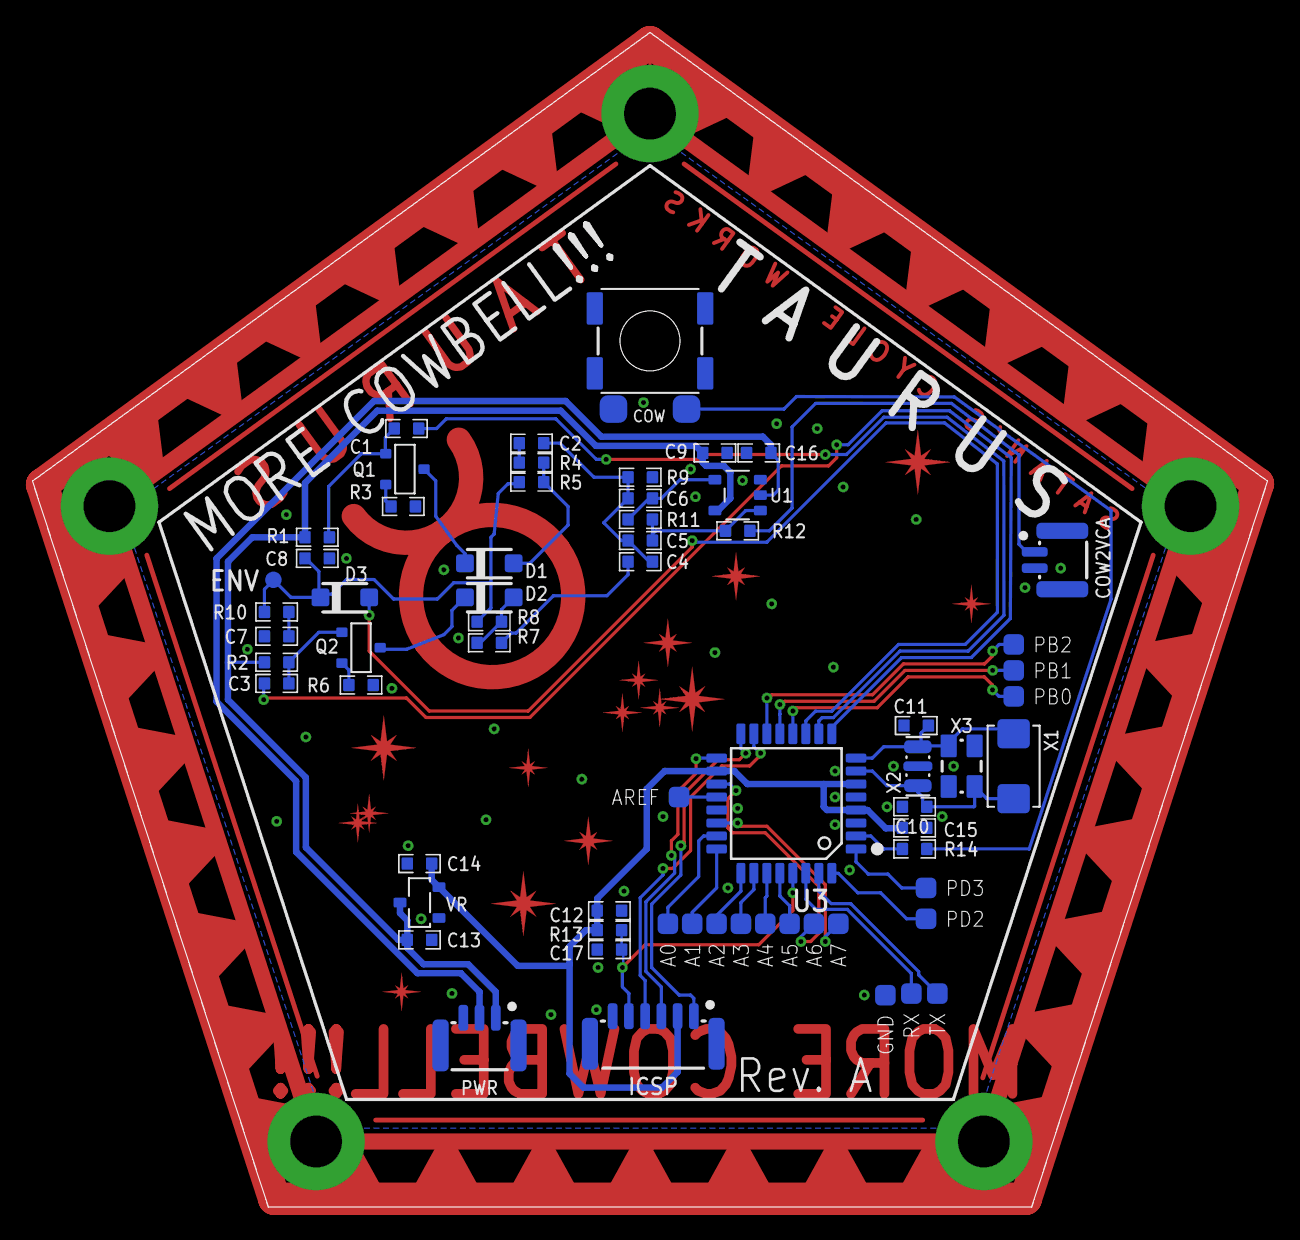
[picture p19: board synth-zodiac-taurus-cowbell.brd from below]

Board: 2 copper layers, 76.1 x 72.4 mm, 67 parts (63 on the bottom side), 47 nets.
