CircuitMonkey/synth-zodiac/PCB/synth-zodiac-virgo-lfo.brd

## EAGLE design PCB/synth-zodiac-virgo-lfo.brd (2024-01-21)

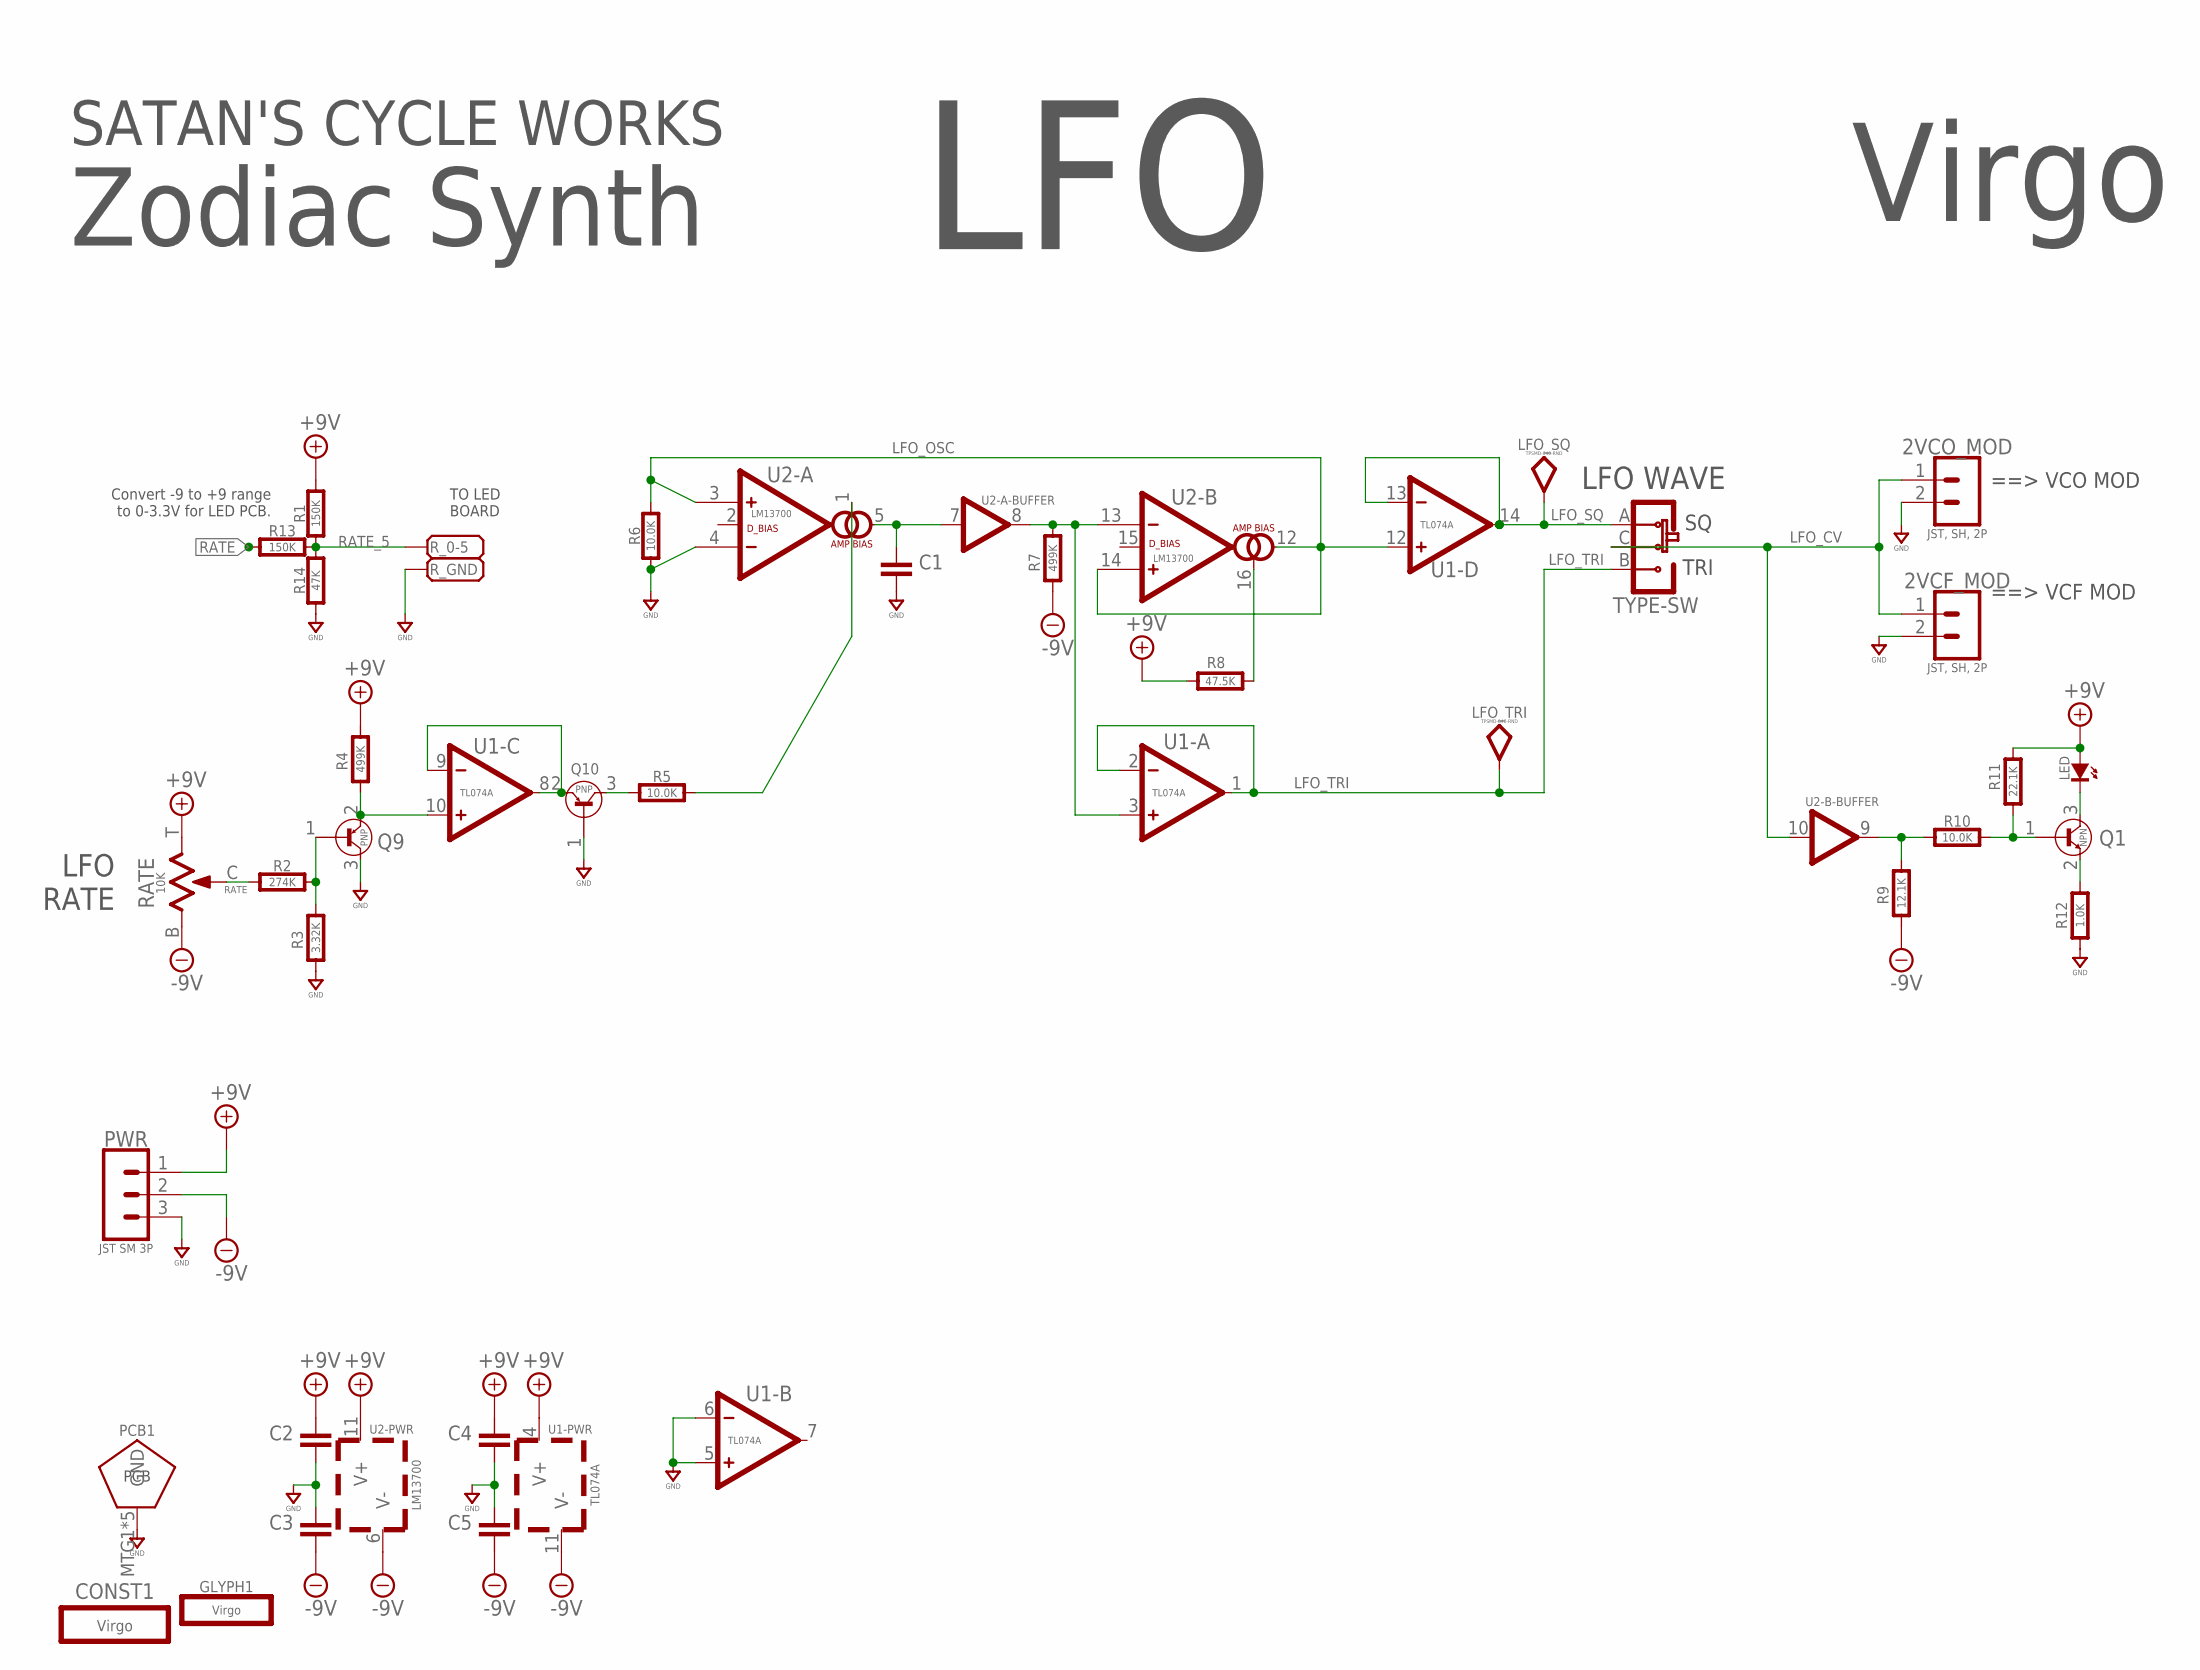
[picture p20: schematic synth-zodiac-virgo-lfo.sch]

Parts:
2VCF_MOD, 2VCO_MOD: JST, SH, 2P; BM02B-SRSS-TB
C1, C2, C3, C4, C5: 0.1uF; 0603-CAP
CONST1: Virgo; VIRGO-CONST
GLYPH1: Virgo; VIRGO-GLYPH
LED: BLU; SMD_0603
LFO_SQ: TPSMD-040-RND; SMD-040MIL-RND
LFO_TRI: TPSMD-040-RND; SMD-040MIL-RND
PCB1: PCB FAB; PENTAGON-40MM-RAD
PWR: JST SM 3P; BM03B-SRSS-TB
Q1: NPN; SOT-23
Q9, Q10: PNP; SOT-23
R1, R13: 150K; 0603-RES
R2: 274K; 0603-RES
R3: 3.32K; 0603-RES
R4, R7: 499K; 0603-RES
R5, R6, R10: 10.0K; 0603-RES
R8: 47.5K; 0603-RES
R9: 12.1K; 0603-RES
R11: 22.1K; 0603-RES
R12: 1.0K; 0603-RES
R14: 47K; 0603-RES
RATE: 10K; POT-RV9110
R_0-5: PADSMD-070X070; SMD-070MIL
R_GND: PADSMD-070X070; SMD-070MIL
TYPE: SLIDE-SPDT-MNTSS-12-F45-TH-PCB-2; SS-12-F45-PNL-SMT-2
U1: TL074A; SOP14
U2: LM13700; SO16

Connections:
+9V: C2.1, C4.1, LED.A, PWR.1, R1.2, R4.1, R8.2, R11.1, RATE.T (3), U1.4 (V+), U2.11 (V+)
-9V: C3.2, C5.2, PWR.2, R7.2, R9.2, RATE.B (1), U1.11 (V-), U2.6 (V-)
GND: 2VCF_MOD.2, 2VCO_MOD.2, C1.2, C2.2, C3.1, C4.2, C5.1, PCB1.MTG1, PCB1.MTG2, PCB1.MTG3, PCB1.MTG4, PCB1.MTG5, PWR.3, Q9.3 (COLLECTOR), Q10.1 (BASE), R3.2, R6.1, R12.2, R14.1, R_GND.1, U1.5 (+), U1.6 (-), U2.4 (-)
LFO_CV: 2VCF_MOD.1, 2VCO_MOD.1, TYPE.C, U2.10 (IN)
LFO_OSC: R6.2, U1.12 (+), U2.3 (+), U2.12 (OUT), U2.14 (+)
LFO_SQ: LFO_SQ.TP, TYPE.A, U1.13 (-), U1.14 (OUT)
LFO_TRI: LFO_TRI.TP, TYPE.B, U1.1 (OUT), U1.2 (-)
unnamed: Q9.1 (BASE), R2.2, R3.1
unnamed: Q9.2 (EMITTER), R4.2, U1.10 (+)
unnamed: Q10.2 (EMITTER), U1.8 (OUT), U1.9 (-)
unnamed: Q10.3 (COLLECTOR), R5.1
unnamed: R5.2, U2.1 (AMP-BIAS)
unnamed: C1.1, U2.5 (OUT), U2.7 (IN)
unnamed: R7.1, U1.3 (+), U2.8 (OUT), U2.13 (-)
unnamed: R8.1, U2.16 (AMP-BIAS)
unnamed: Q1.1 (BASE), R10.2, R11.2
unnamed: Q1.2 (EMITTER), R12.1
unnamed: R9.1, R10.1, U2.9 (OUT)
unnamed: LED.K (C), Q1.3 (COLLECTOR)
RATE: R2.1, R13.1, RATE.C (2)
RATE_5: R1.1, R13.2, R14.2, R_0-5.1

Notes on the sheet:
LFO RATE
LFO WAVE
TRI
==> VCO MOD
==> VCF MOD
TO LED BOARD
Convert -9 to +9 range to 0-3.3V for LED PCB.
LFO
Zodiac Synth
Virgo
SATAN'S CYCLE WORKS
