CircuitMonkey/synth-zodiac/PCB/synth-zodiac-virgo-lfo.brd

## EAGLE design PCB/synth-zodiac-virgo-lfo.brd (continued)

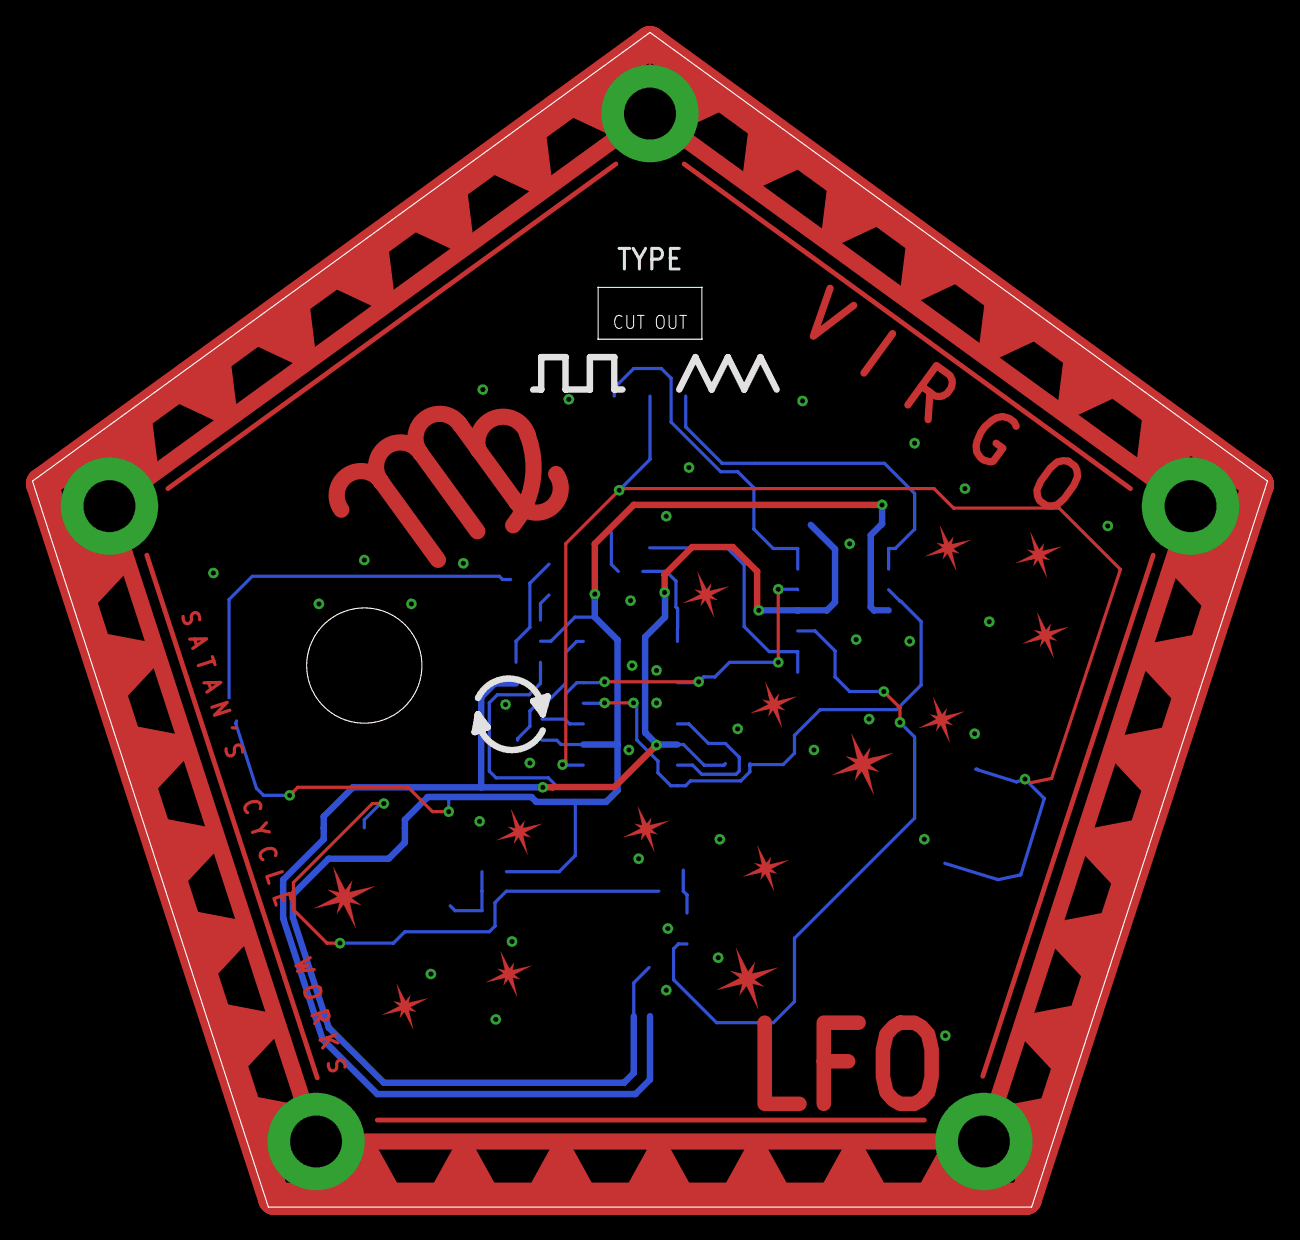
[picture p21: board synth-zodiac-virgo-lfo.brd from above]

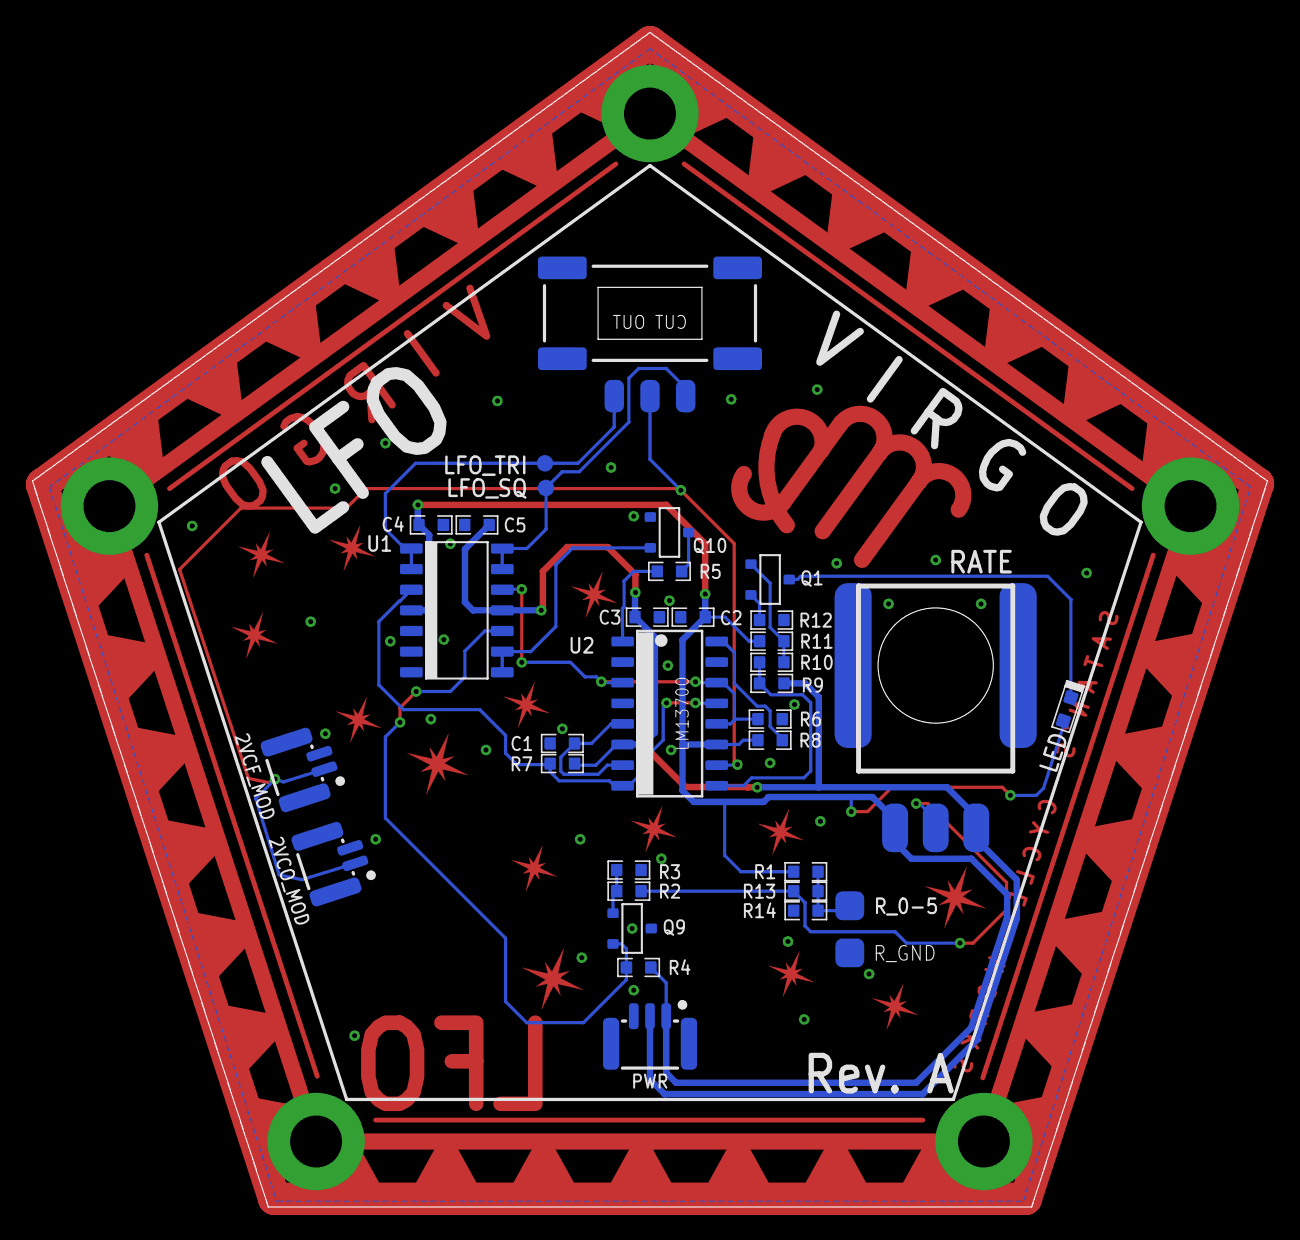
[picture p22: board synth-zodiac-virgo-lfo.brd from below]

Board: 2 copper layers, 76.1 x 72.4 mm, 37 parts (33 on the bottom side), 21 nets.
