CircuitMonkey/synth-zodiac/PCB/synth-zodiac-gemini-envelope.brd

## EAGLE design PCB/synth-zodiac-gemini-envelope.brd (2024-01-21)

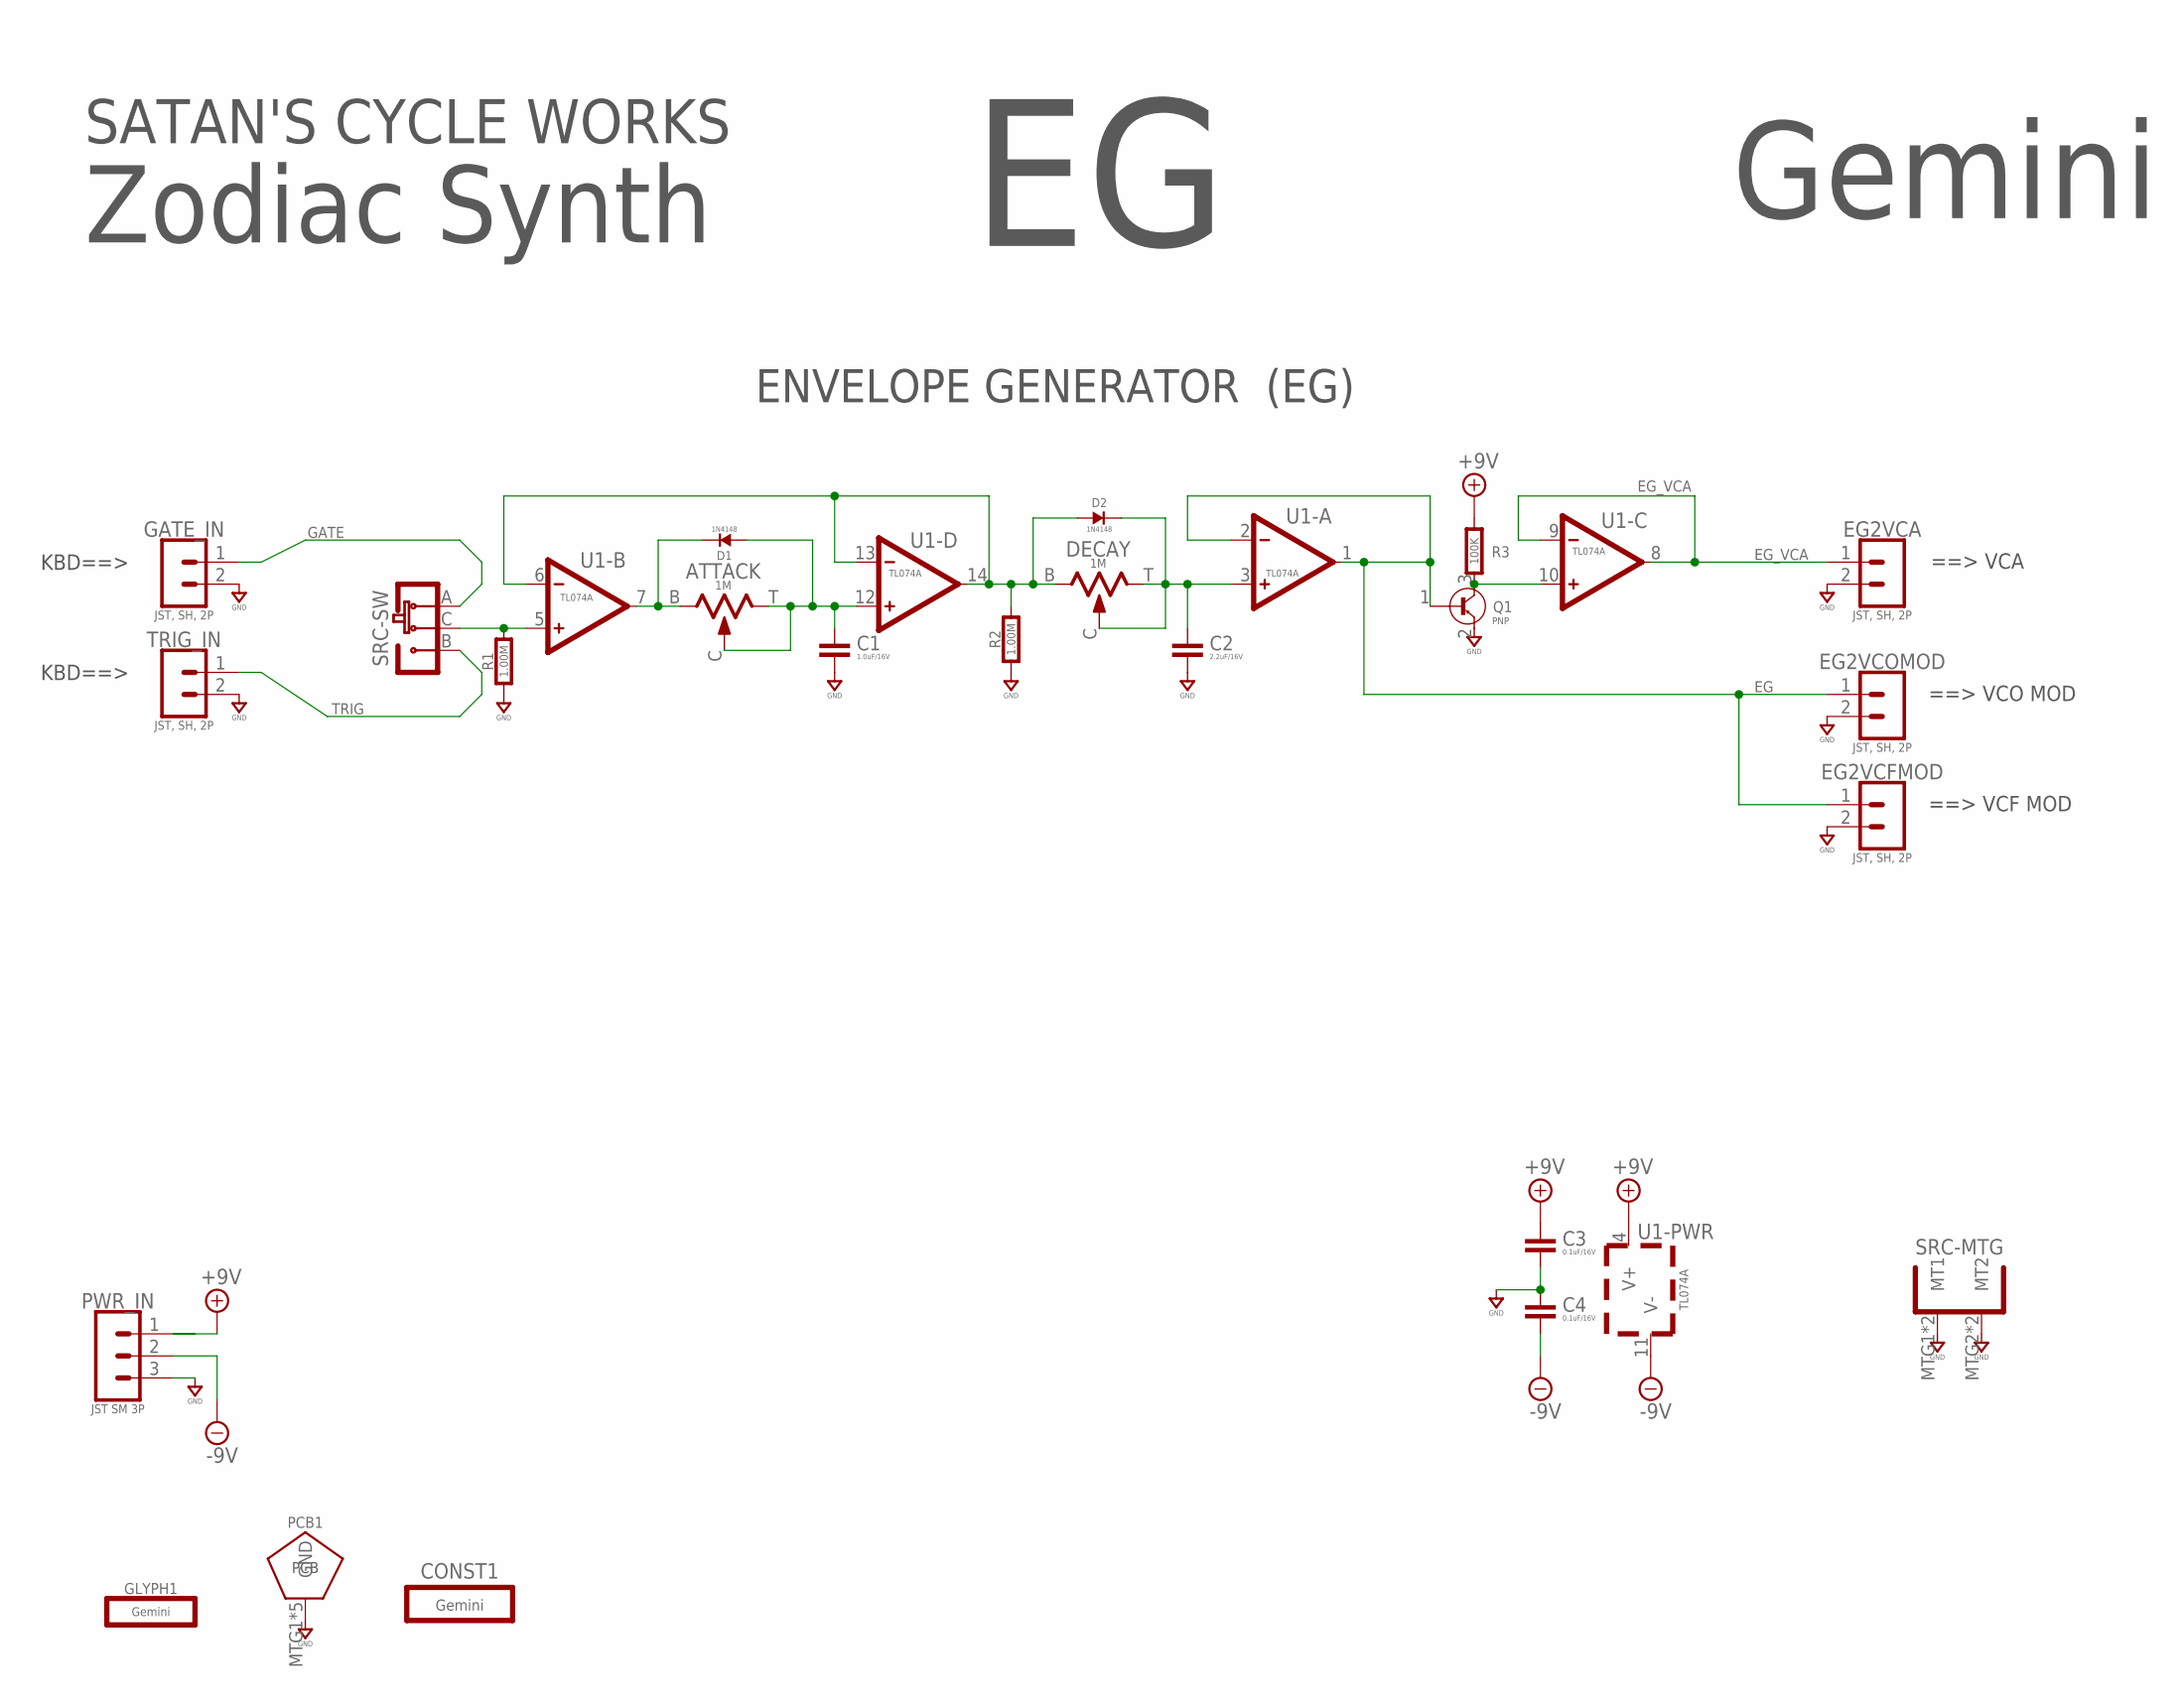
[picture p23: schematic synth-zodiac-gemini-envelope.sch]

Parts:
ATTACK: 1M; POT-RV9110
C1: 1.0uF/16V; 0603-CAP
C2: 2.2uF/16V; 0603-CAP
C3, C4: 0.1uF/16V; 0603-CAP
CONST1: Gemini; GEMINI-CONST
D1, D2: 1N4148; SOD-123
DECAY: 1M; POT-RV9110
EG2VCA, EG2VCFMOD, EG2VCOMOD: JST, SH, 2P; BM02B-SRSS-TB
GATE_IN: JST, SH, 2P; BM02B-SRSS-TB
GLYPH1: Gemini; GEMINI-GLYPH
PCB1: PCB FAB; PENTAGON-40MM-RAD
PWR_IN: JST SM 3P; BM03B-SRSS-TB
Q1: PNP; SOT-23
R1, R2: 1.00M; 0603-RES
R3: 100K; 0603-RES
SRC: SLIDE-SPDT-MNTSS-12-F45-TH-PCB-2; SS-12-F45-PNL-SMT-2
TRIG_IN: JST, SH, 2P; BM02B-SRSS-TB
U1: TL074A; SOP14

Connections:
+9V: C3.1, PWR_IN.1, R3.2, U1.4 (V+)
-9V: C4.2, PWR_IN.2, U1.11 (V-)
EG: EG2VCFMOD.1, EG2VCOMOD.1, Q1.1 (BASE), U1.1 (OUT), U1.2 (-)
EG_VCA: EG2VCA.1, U1.8 (OUT), U1.9 (-)
GATE: GATE_IN.1, SRC.A
GND: C1.2, C2.2, C3.2, C4.1, EG2VCA.2, EG2VCFMOD.2, EG2VCOMOD.2, GATE_IN.2, PCB1.MTG1, PCB1.MTG2, PCB1.MTG3, PCB1.MTG4, PCB1.MTG5, PWR_IN.3, Q1.2 (EMITTER), R1.1, R2.1, SRC.MTG1 (MT1), SRC.MTG2 (MT2), SRC.MTG3 (MT1), SRC.MTG4 (MT2), TRIG_IN.2
unnamed: R1.2, SRC.C, U1.5 (+)
unnamed: ATTACK.B (1), D1.K, U1.7 (OUT)
unnamed: ATTACK.C (2), ATTACK.T (3), C1.1, D1.A, U1.12 (+)
unnamed: C2.1, D2.K, DECAY.C (2), DECAY.T (3), U1.3 (+)
unnamed: D2.A, DECAY.B (1), R2.2, U1.6 (-), U1.13 (-), U1.14 (OUT)
unnamed: Q1.3 (COLLECTOR), R3.1, U1.10 (+)
TRIG: SRC.B, TRIG_IN.1

Notes on the sheet:
ENVELOPE GENERATOR (EG)
==> VCO MOD
==> VCA
==> VCF MOD
KBD==>
Zodiac Synth
Gemini
SATAN'S CYCLE WORKS

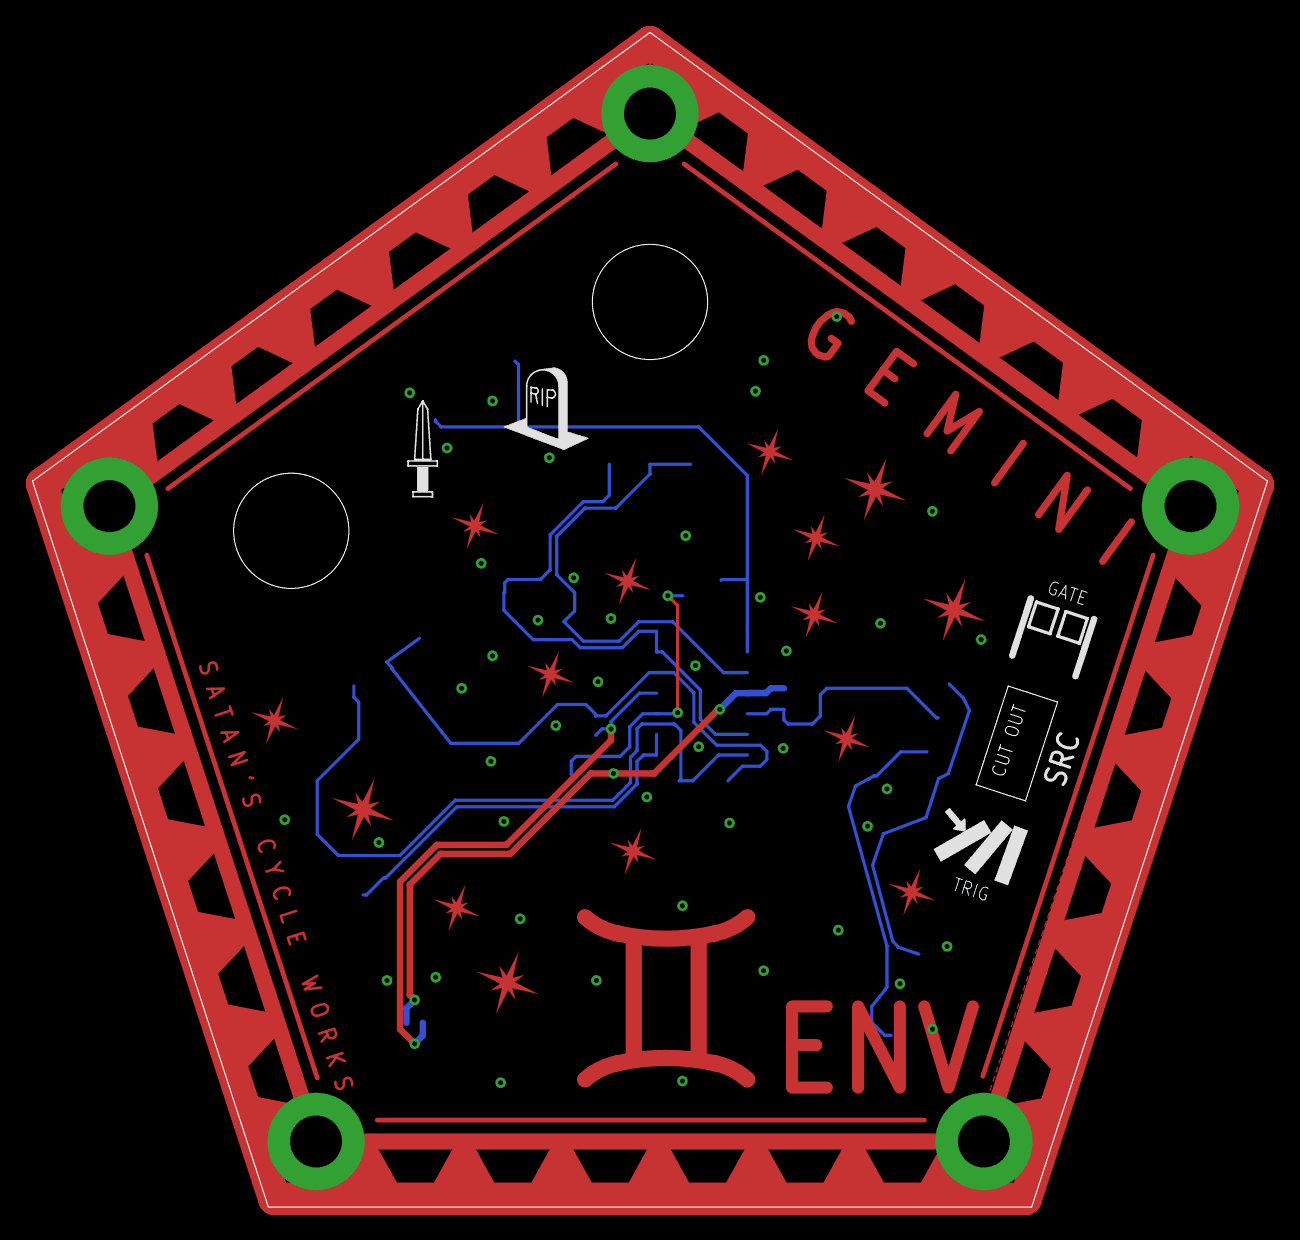
[picture p24: board synth-zodiac-gemini-envelope.brd from above]

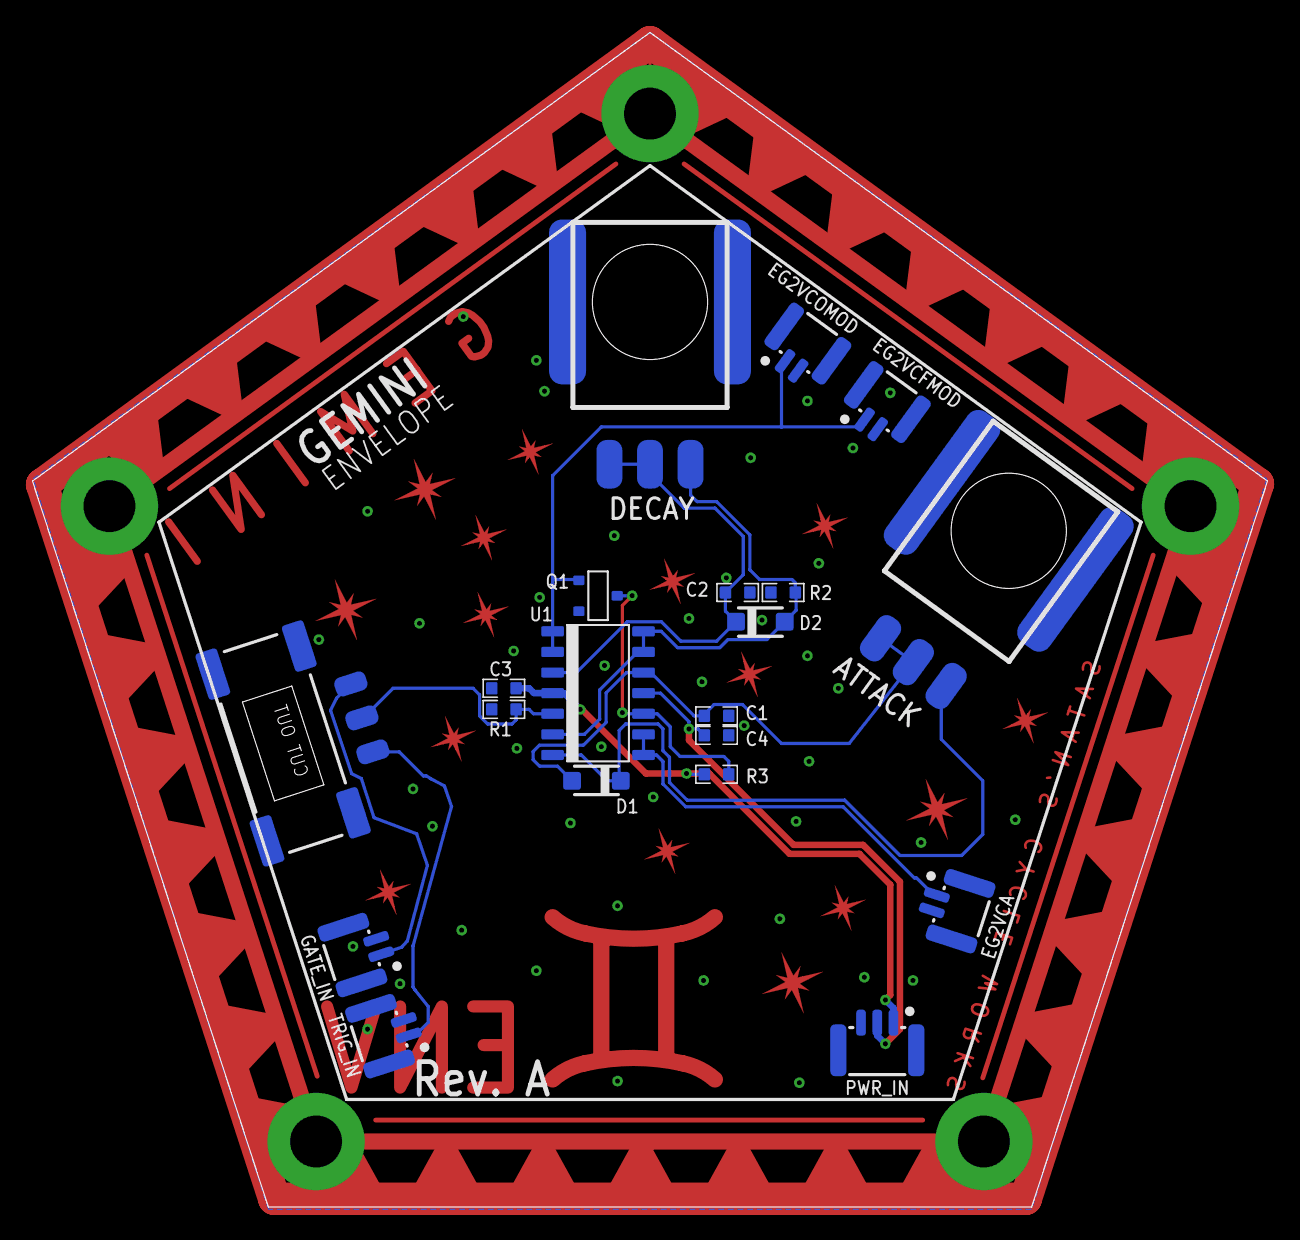
[picture p25: board synth-zodiac-gemini-envelope.brd from below]

Board: 2 copper layers, 76.1 x 72.4 mm, 23 parts (19 on the bottom side), 13 nets.
