CircuitMonkey/synth-zodiac/PCB/synth-zodiac-scorpio-kbd-mcu.brd

## EAGLE design PCB/synth-zodiac-scorpio-kbd-mcu.brd (2024-01-21)

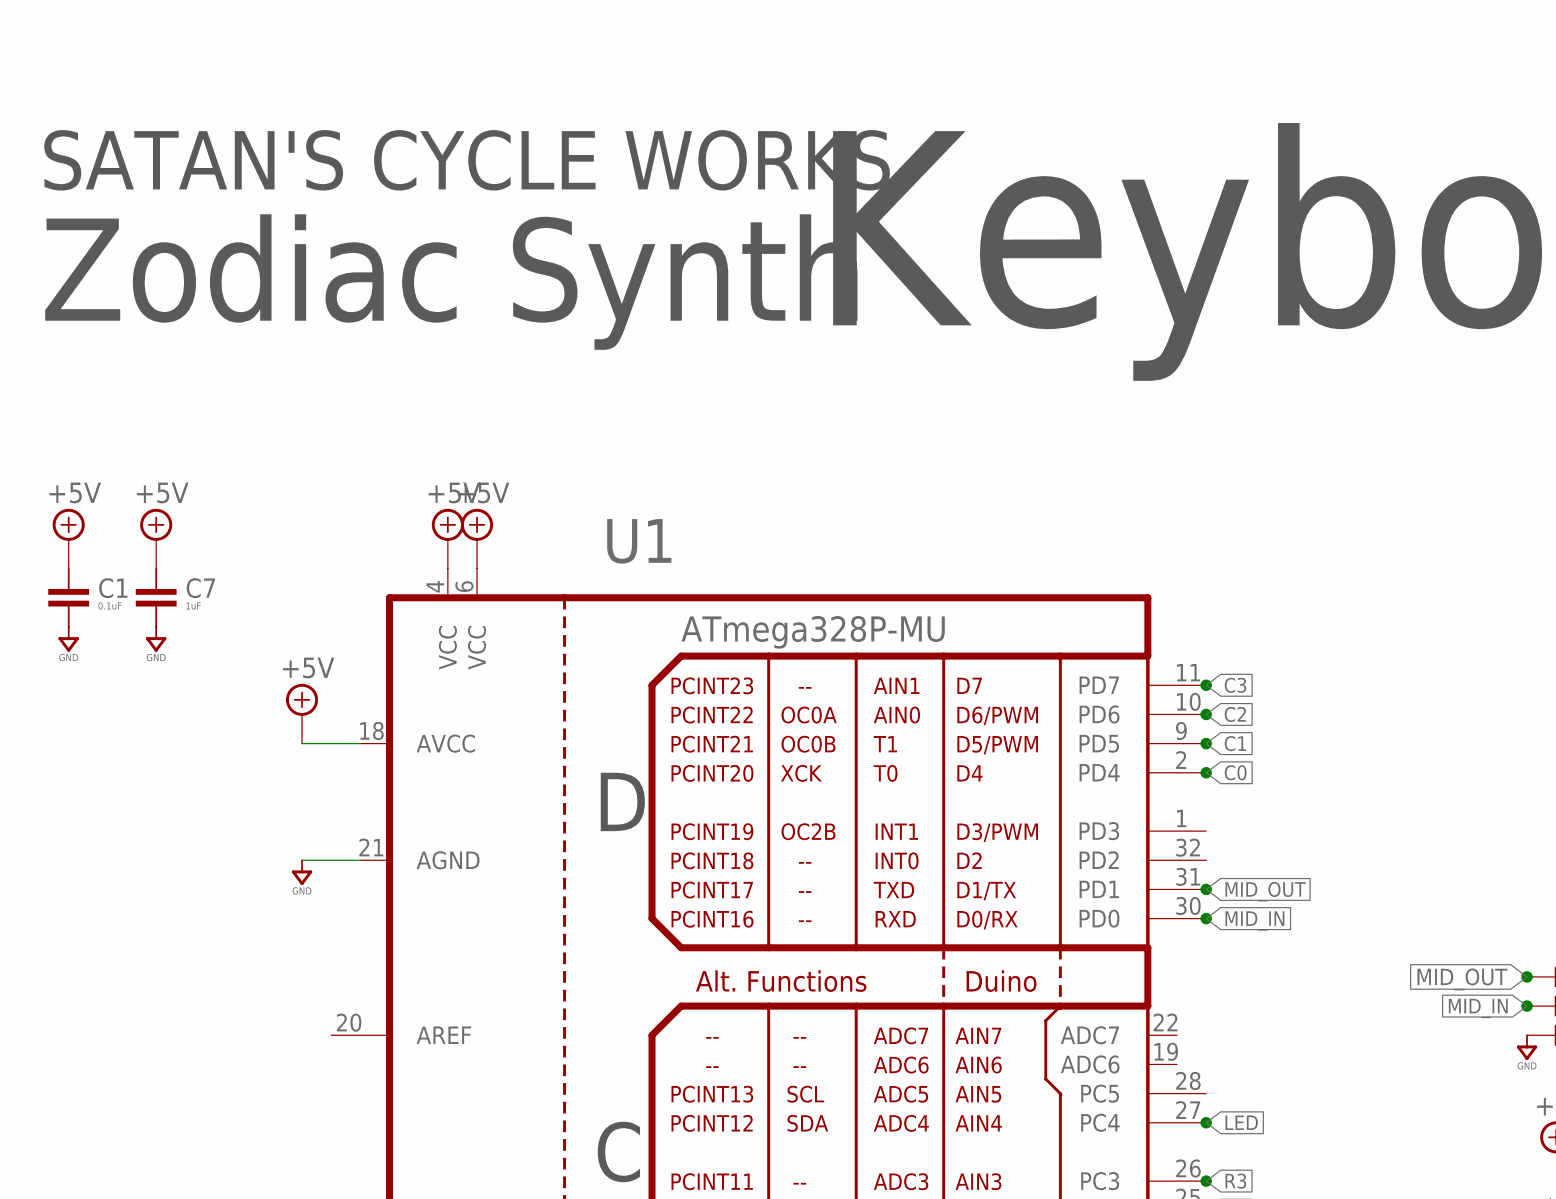
[picture p26: schematic synth-zodiac-scorpio-kbd-mcu.sch, part in row 1, column 1]

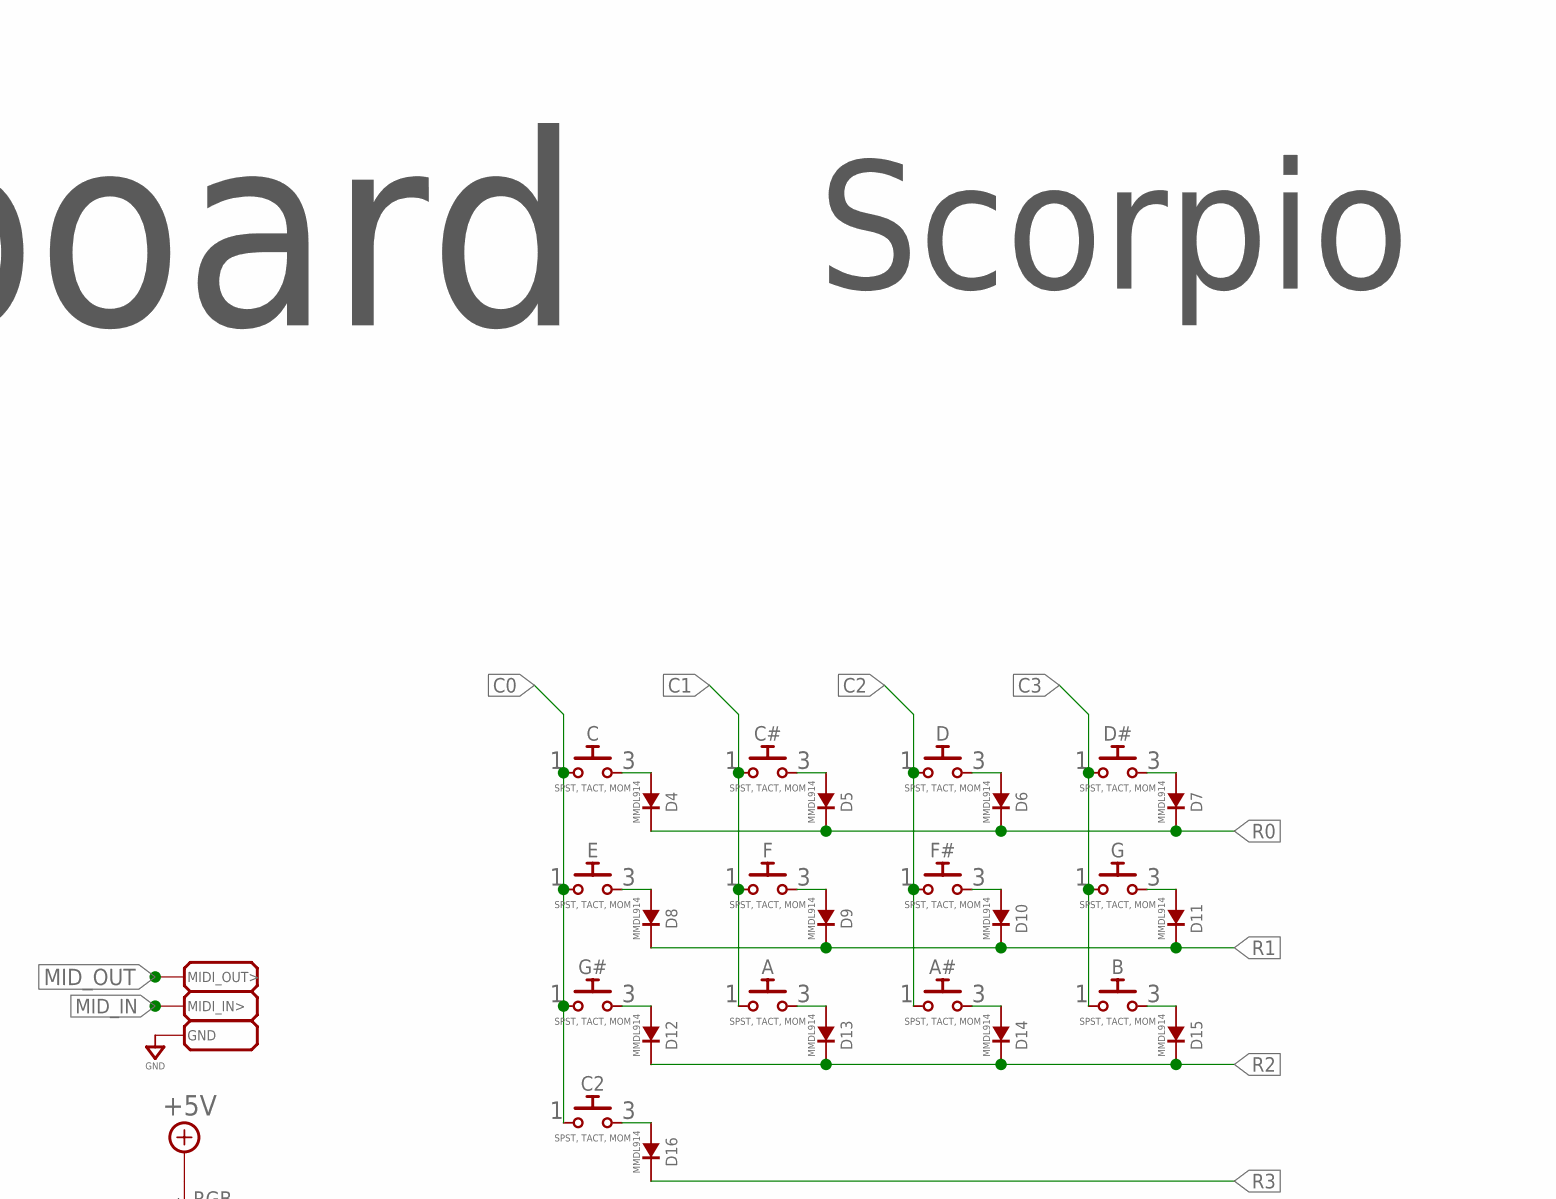
[picture p27: schematic synth-zodiac-scorpio-kbd-mcu.sch, part in row 1, column 2]

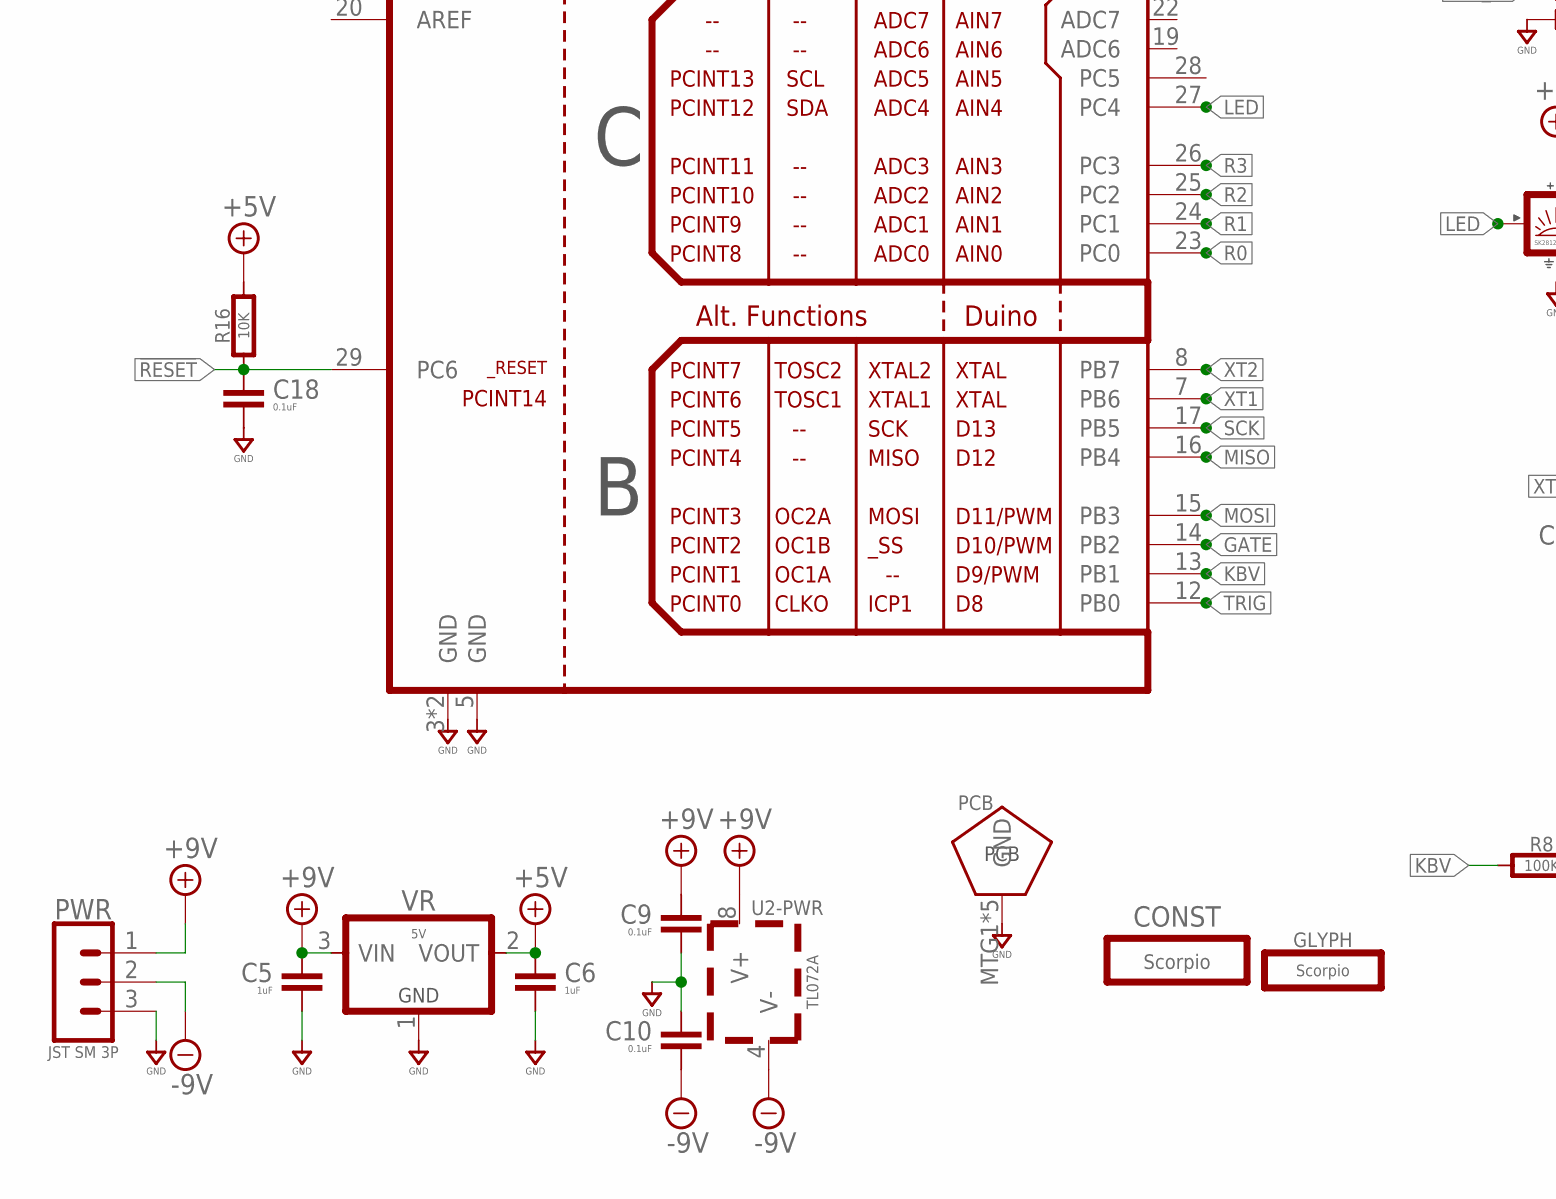
[picture p28: schematic synth-zodiac-scorpio-kbd-mcu.sch, part in row 2, column 1]

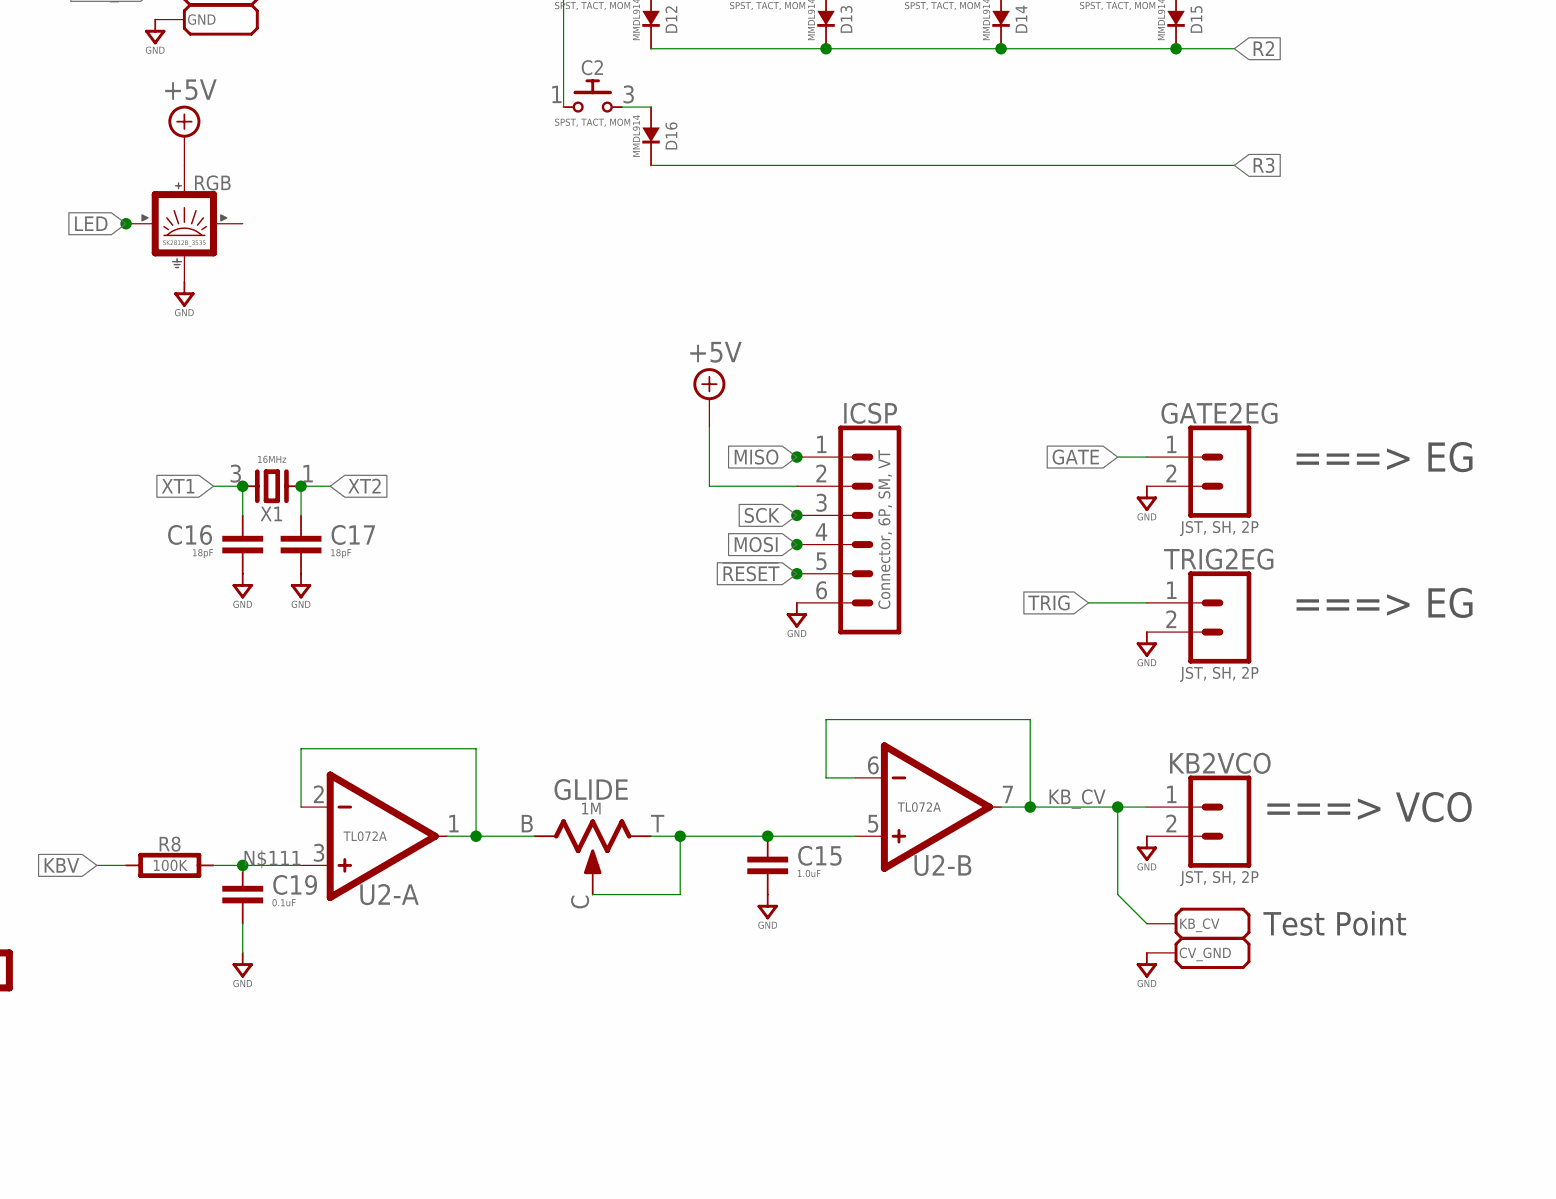
[picture p29: schematic synth-zodiac-scorpio-kbd-mcu.sch, part in row 2, column 2]

Parts:
A: SPST, TACT, MOM; B3FS-BACKMOUNT
A#: SPST, TACT, MOM; B3FS-BACKMOUNT
B: SPST, TACT, MOM; B3FS-BACKMOUNT
C, C2: SPST, TACT, MOM; B3FS-BACKMOUNT
C1, C9, C10, C18, C19: 0.1uF; 0603-CAP
C5, C6, C7: 1uF; 0603-CAP
C15: 1.0uF; 0603-CAP
C16, C17: 18pF; 0603-CAP
C#: SPST, TACT, MOM; B3FS-BACKMOUNT
CONST: Scorpio; SCORPIO-CONST
CV_GND: PAD-70X70SMD-070X070; SMD-070MIL
D: SPST, TACT, MOM; B3FS-BACKMOUNT
D4, D5, D6, D7, D8, D9, D10, D11, D12, D13, D14, D15, D16: MMDL914; SOD-323
D#: SPST, TACT, MOM; B3FS-BACKMOUNT
E: SPST, TACT, MOM; B3FS-BACKMOUNT
F: SPST, TACT, MOM; B3FS-BACKMOUNT
F#: SPST, TACT, MOM; B3FS-BACKMOUNT
G: SPST, TACT, MOM; B3FS-BACKMOUNT
G#: SPST, TACT, MOM; B3FS-BACKMOUNT
GATE2EG: JST, SH, 2P; BM02B-SRSS-TB
GLIDE: 1M; POT-RV9110
GLYPH: Scorpio; SCORPIO-GLYPH
GND: PAD-70X70SMD-070X070; SMD-070MIL
ICSP: Connector, 6P, SM, VT; BM06B-SRSS-TB
KB2VCO: JST, SH, 2P; BM02B-SRSS-TB
KB_CV: PAD-70X70SMD-070X070; SMD-070MIL
MIDI_IN>: PAD-70X70SMD-070X070; SMD-070MIL
MIDI_OUT>: PAD-70X70SMD-070X070; SMD-070MIL
PCB: PCB FAB; PENTAGON-40MM-RAD
PWR: JST SM 3P; BM03B-SRSS-TB
R8: 100K; 0603-RES
R16: 10K; 0603-RES
RGB: SK2812B_3535; SMD_3535
TRIG2EG: JST, SH, 2P; BM02B-SRSS-TB
U1: ATmega328P-MU; MLF32
U2: TL072A; SOP08
VR: 5V; SOT-23
X1: 16MHz; 32X25

Connections:
!RESET: C18.1, ICSP.5, R16.1, U1.29 (PC6)
+5V: C1.1, C6.1, C7.1, ICSP.2, R16.2, RGB.4 (VDD), U1.4 (VCC), U1.6 (VCC), U1.18 (AVCC), VR.2 (VOUT)
+9V: C5.1, C9.1, PWR.1, U2.8 (V+), VR.3 (VIN)
-9V: C10.2, PWR.2, U2.4 (V-)
C0: C.1, C2.1, E.1, G#.1, U1.2 (PD4)
C1: A.1, C#.1, F.1, U1.9 (PD5)
C2: A#.1, D.1, F#.1, U1.10 (PD6)
C3: B.1, D#.1, G.1, U1.11 (PD7)
GATE: GATE2EG.1, U1.14 (PB2)
GND: C1.2, C5.2, C6.2, C7.2, C9.2, C10.1, C15.2, C16.2, C17.2, C18.2, C19.2, CV_GND.1, GATE2EG.2, GND.1, ICSP.6, KB2VCO.2, PCB.MTG1, PCB.MTG2, PCB.MTG3, PCB.MTG4, PCB.MTG5, PWR.3, RGB.2 (GND), TRIG2EG.2, U1.3 (GND), U1.5 (GND), U1.21 (AGND), U1.PAD (GND), VR.1 (GND)
KBV: R8.1, U1.13 (PB1)
KB_CV: KB2VCO.1, KB_CV.1, U2.6 (-), U2.7 (OUT)
LED: RGB.3 (IN), U1.27 (PC4)
MID_IN: MIDI_IN>.1, U1.30 (PD0)
MID_OUT: MIDI_OUT>.1, U1.31 (PD1)
MISO: ICSP.1, U1.16 (PB4)
MOSI: ICSP.4, U1.15 (PB3)
unnamed: C19.1, R8.2, U2.3 (+)
unnamed: GLIDE.B (1), U2.1 (OUT), U2.2 (-)
unnamed: C.3 (2), D4.A
unnamed: C15.1, GLIDE.C (2), GLIDE.T (3), U2.5 (+)
unnamed: C#.3 (2), D5.A
unnamed: D.3 (2), D6.A
unnamed: D7.A, D#.3 (2)
unnamed: D8.A, E.3 (2)
unnamed: D9.A, F.3 (2)
unnamed: D10.A, F#.3 (2)
unnamed: D11.A, G.3 (2)
unnamed: D12.A, G#.3 (2)
unnamed: A.3 (2), D13.A
unnamed: A#.3 (2), D14.A
unnamed: B.3 (2), D15.A
unnamed: C2.3 (2), D16.A
R0: D4.K, D5.K, D6.K, D7.K, U1.23 (PC0)
R1: D8.K, D9.K, D10.K, D11.K, U1.24 (PC1)
R2: D12.K, D13.K, D14.K, D15.K, U1.25 (PC2)
R3: D16.K, U1.26 (PC3)
SCK: ICSP.3, U1.17 (PB5)
TRIG: TRIG2EG.1, U1.12 (PB0)
XT1: C16.1, U1.7 (PB6), X1.3
XT2: C17.1, U1.8 (PB7), X1.1

Notes on the sheet:
===> EG
===> VCO
Test Point
Keyboard
Zodiac Synth
Scorpio
SATAN'S CYCLE WORKS
