CircuitMonkey/synth-zodiac/PCB/synth-zodiac-scorpio-kbd-mcu.brd

## EAGLE design PCB/synth-zodiac-scorpio-kbd-mcu.brd (continued)

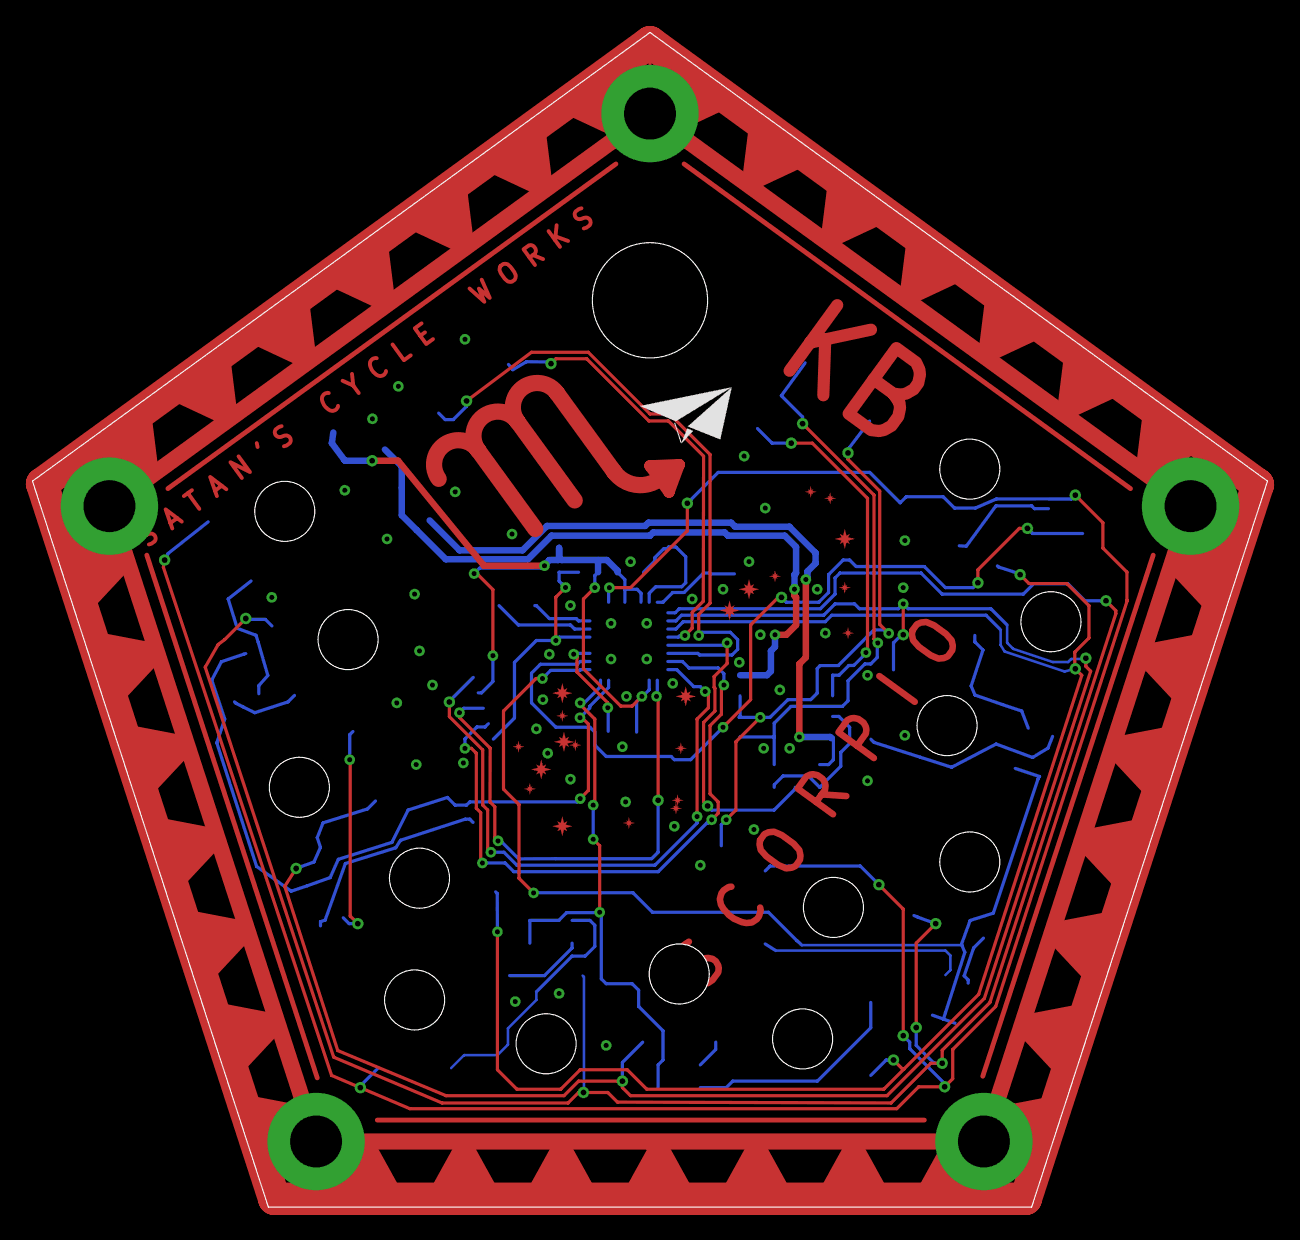
[picture p30: board synth-zodiac-scorpio-kbd-mcu.brd from above]

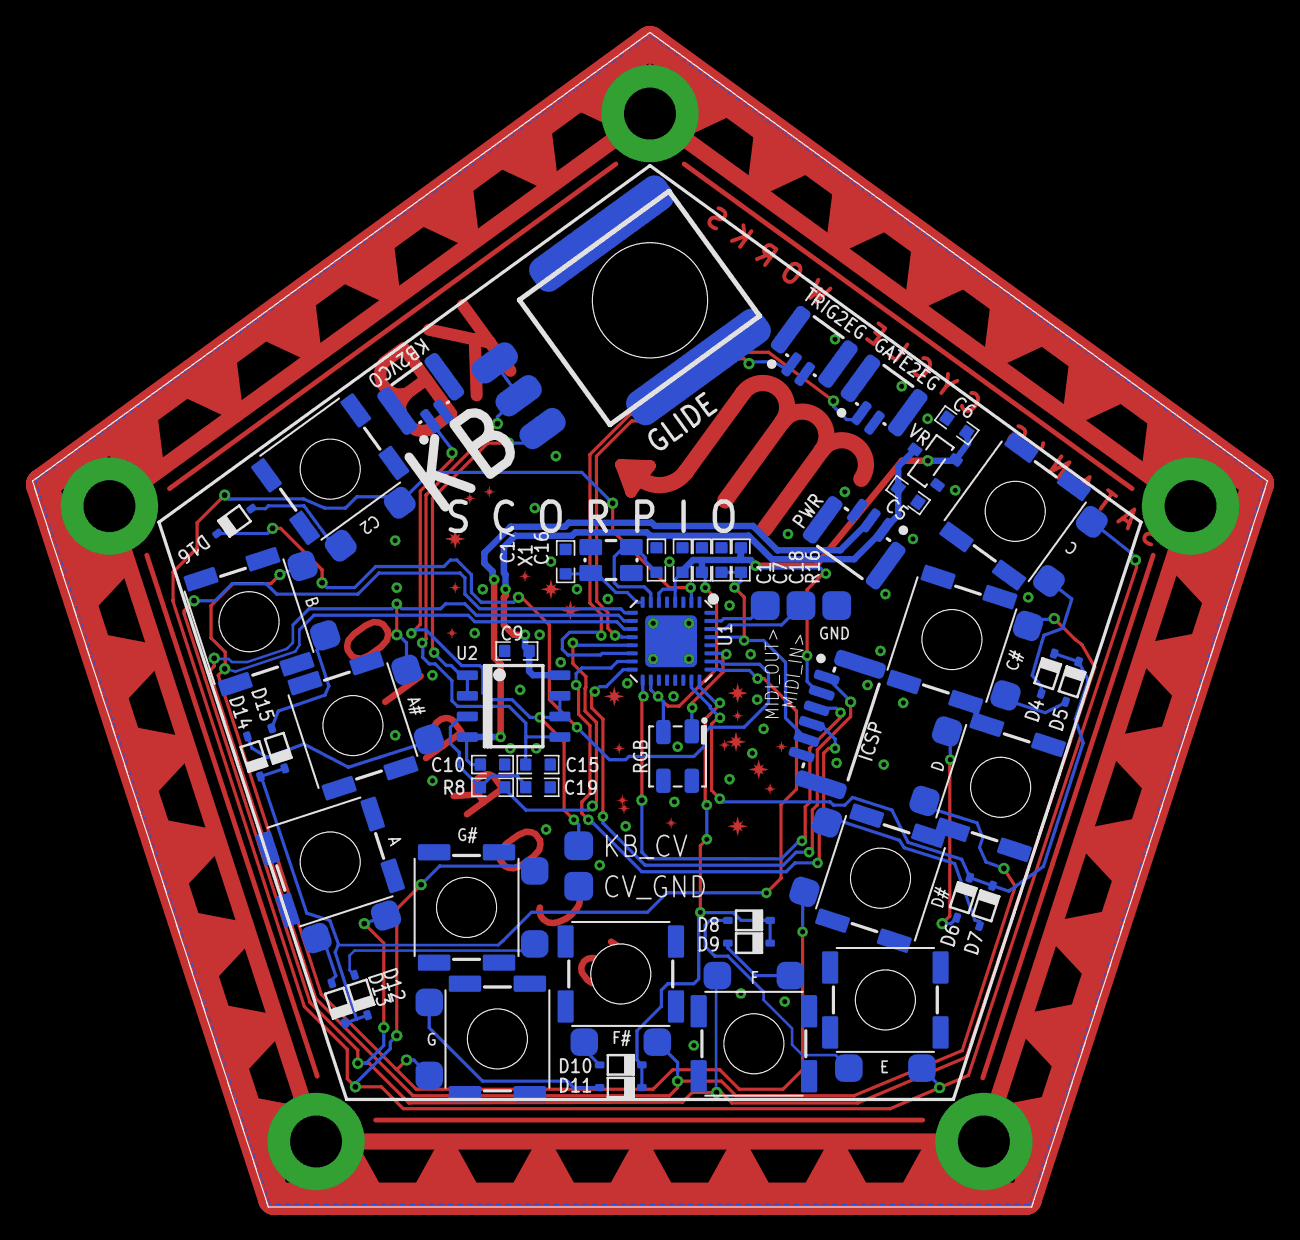
[picture p31: board synth-zodiac-scorpio-kbd-mcu.brd from below]

Board: 2 copper layers, 76.1 x 72.4 mm, 58 parts (42 on the bottom side), 41 nets.
