CircuitMonkey/synth-zodiac/PCB/synth-zodiac-cancer-led.brd

## EAGLE design PCB/synth-zodiac-cancer-led.brd (2023-12-11)

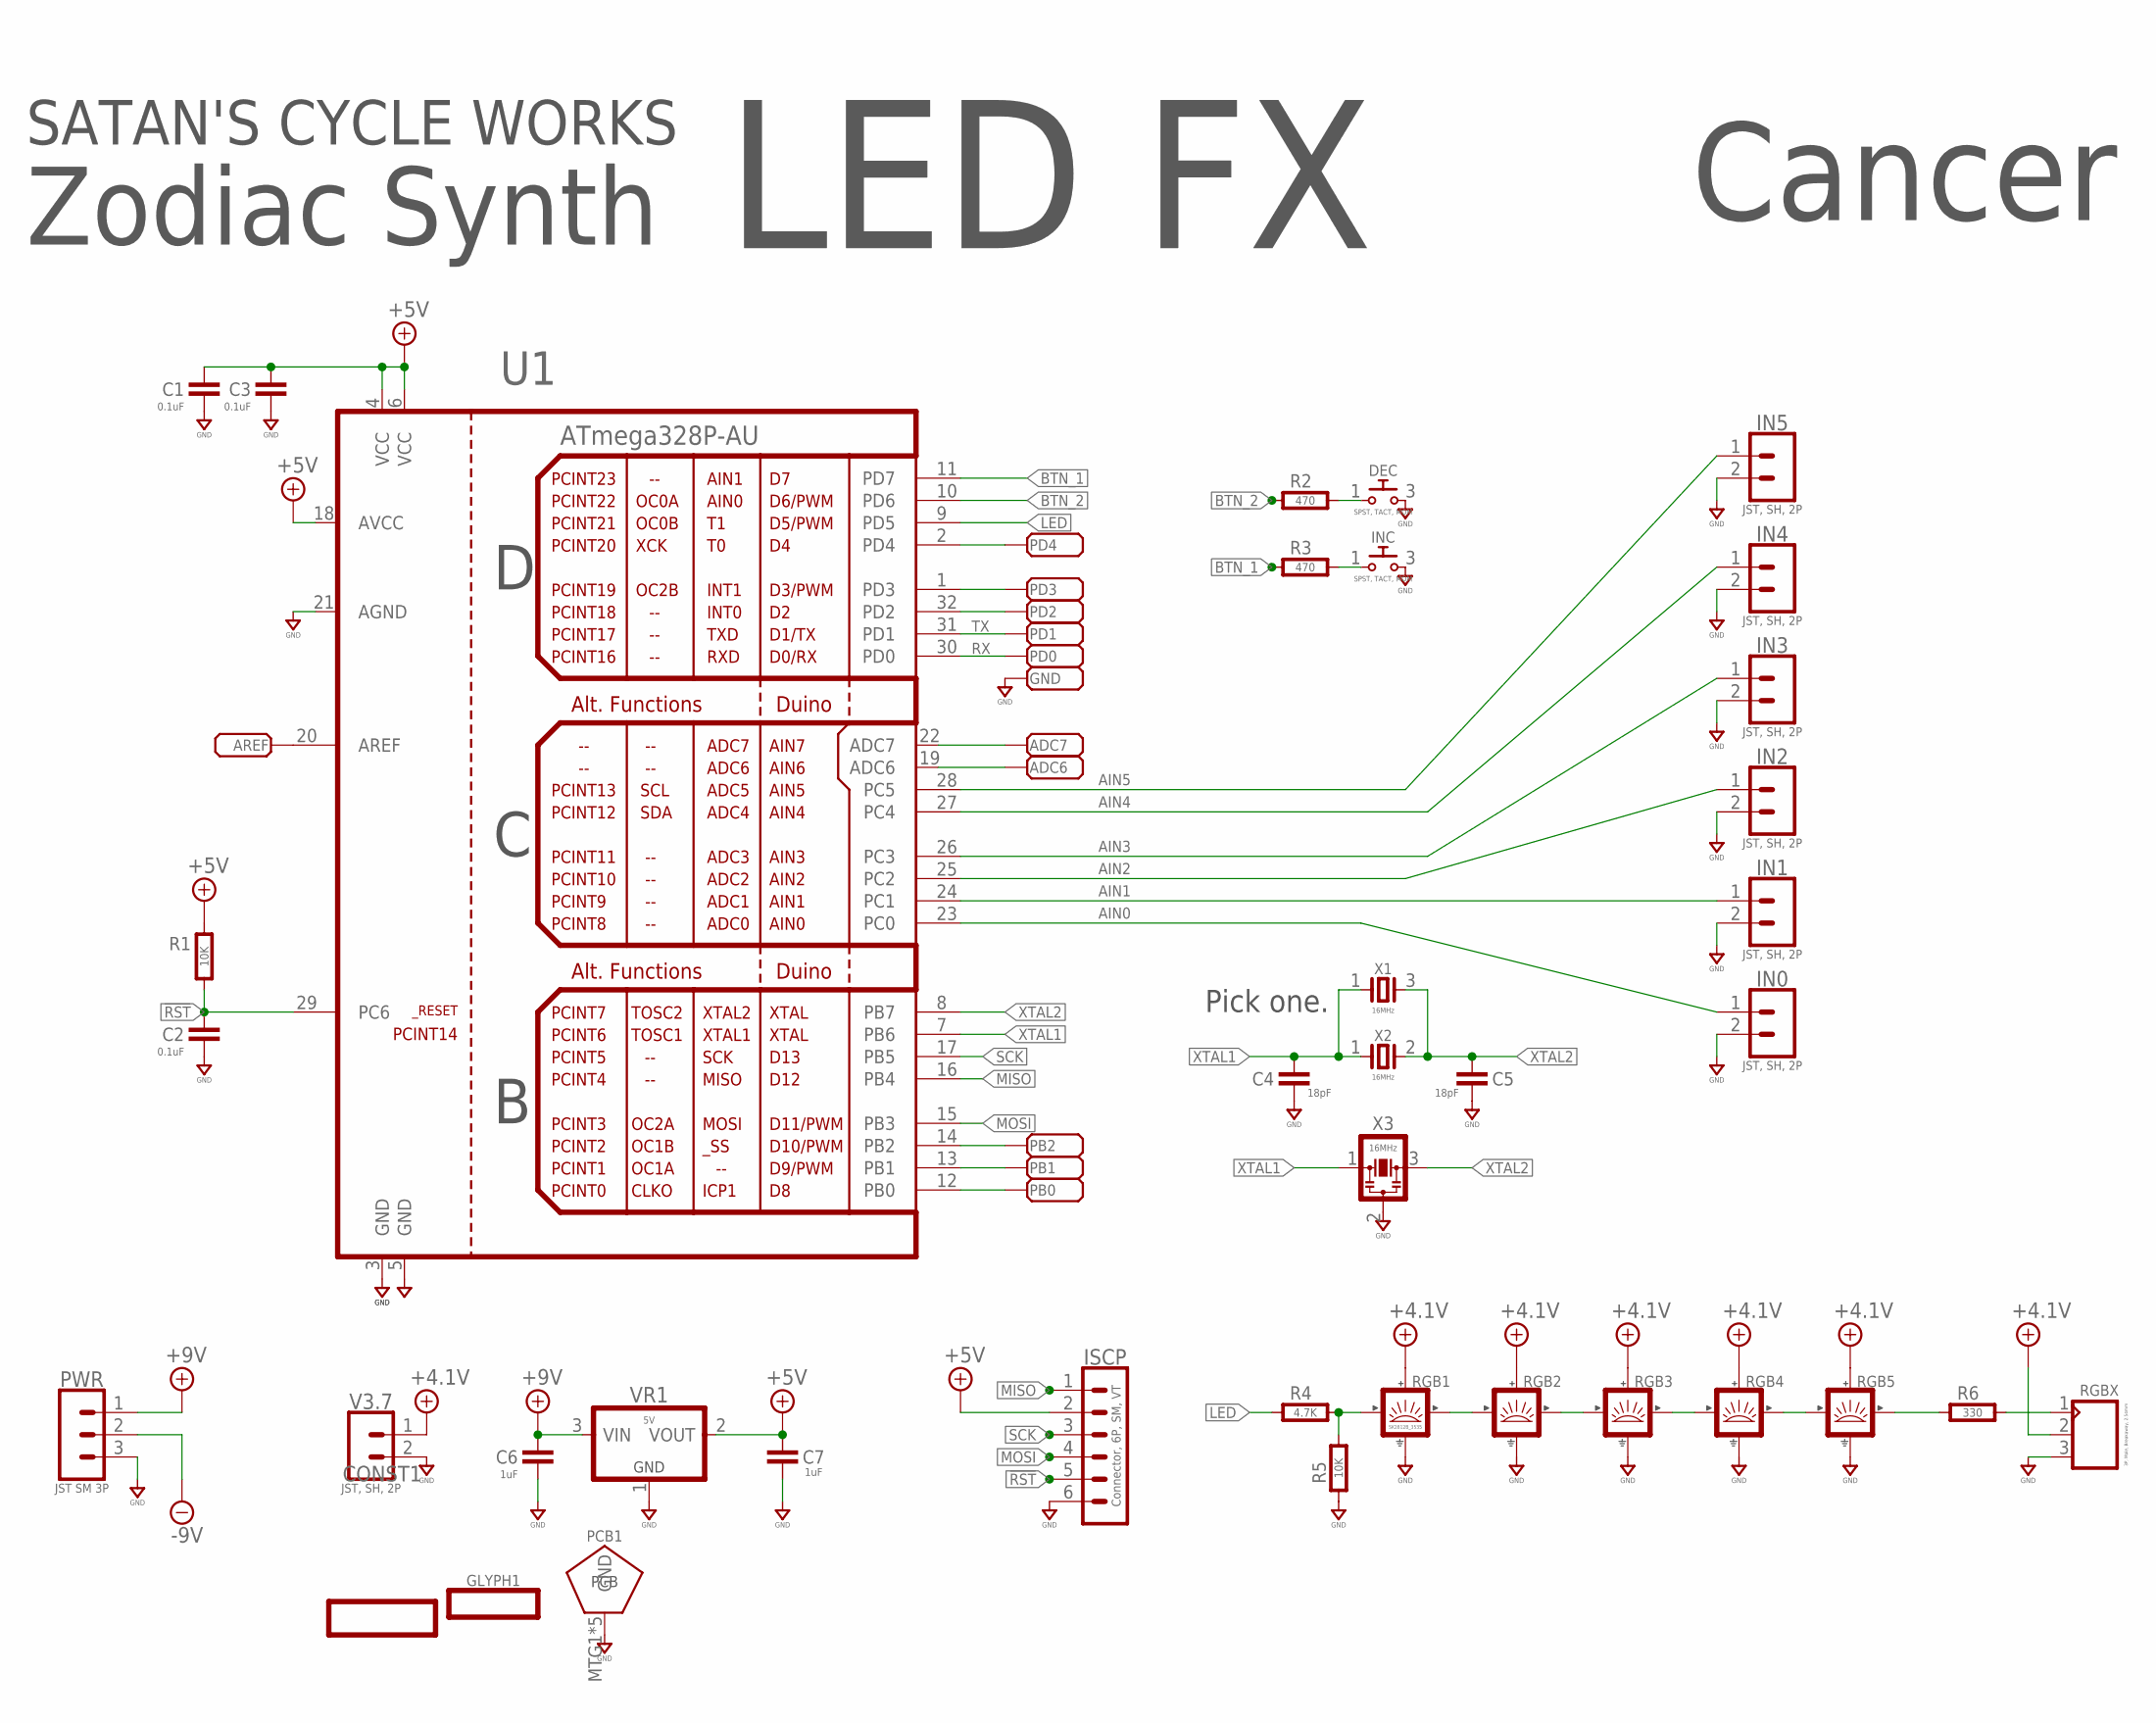
[picture p32: schematic synth-zodiac-cancer-led.sch]

Parts:
ADC6, ADC7: PADSMD-050X050; SMD-050X050
AREF: PADSMD-050X050; SMD-050X050
C1, C2, C3: 0.1uF; 0603-CAP
C4, C5: 18pF; 0603-CAP
C6, C7: 1uF; 0603-CAP
CONST1: CONSTELLATION-CANCER; CANCER-CONST
DEC: SPST, TACT, MOM; B3FS-BACKMOUNT
GLYPH1: GLYPH-CANCER; CANCER-GLYPH
GND: PADSMD-050X050; SMD-050X050
IN0, IN1, IN2, IN3, IN4, IN5: JST, SH, 2P; BM02B-SRSS-TB
INC: SPST, TACT, MOM; B3FS-BACKMOUNT
ISCP: Connector, 6P, SM, VT; BM06B-SRSS-TB
PB0, PB1, PB2: PADSMD-050X050; SMD-050X050
PCB1: PCB FAB; PENTAGON-40MM-RAD
PD0, PD1, PD2, PD3, PD4: PADSMD-050X050; SMD-050X050
PWR: JST SM 3P; BM03B-SRSS-TB
R1, R5: 10K; 0603-RES
R2, R3: 470; 0603-RES
R4: 4.7K; 0603-RES
R6: 330; 0603-RES
RGB1: SK2812B_3535; SMD_3535
RGB2, RGB3, RGB4, RGB5: SMART_LED4020-SIDE; SMD_4020
RGBX: 3P, Male, Breakaway, 2.54mm; MA03X1-EDGE-2.54MM
U1: ATmega328P-AU; TQFP-32-08
V3.7: JST, SH, 2P; BM02B-SRSS-TB
VR1: 5V; SOT-23
X1: 16MHz; 32X25
X2: 16MHz; CTS_5X3
X3: 16MHz; CSTE-RESONATOR

Connections:
!RST: C2.1, ISCP.5, R1.2, U1.29 (PC6)
+4.1V: RGB1.4 (VDD), RGB2.2 (VDD), RGB3.2 (VDD), RGB4.2 (VDD), RGB5.2 (VDD), RGBX.2, V3.7.1
+5V: C1.1, C3.1, C7.1, ISCP.2, R1.1, U1.4 (VCC), U1.6 (VCC), U1.18 (AVCC), VR1.2 (VOUT)
+9V: C6.1, PWR.1, VR1.3 (VIN)
-9V: PWR.2
AIN0: IN0.1, U1.23 (PC0)
AIN1: IN1.1, U1.24 (PC1)
AIN2: IN2.1, U1.25 (PC2)
AIN3: IN3.1, U1.26 (PC3)
AIN4: IN4.1, U1.27 (PC4)
AIN5: IN5.1, U1.28 (PC5)
BTN_1: R3.1, U1.11 (PD7)
BTN_2: R2.1, U1.10 (PD6)
GND: C1.2, C2.2, C3.2, C4.2, C5.2, C6.2, C7.2, DEC.3 (2), GND.1, IN0.2, IN1.2, IN2.2, IN3.2, IN4.2, IN5.2, INC.3 (2), ISCP.6, PCB1.MTG1, PCB1.MTG2, PCB1.MTG3, PCB1.MTG4, PCB1.MTG5, PWR.3, R5.1, RGB1.2 (GND), RGB2.4 (GND), RGB3.4 (GND), RGB4.4 (GND), RGB5.4 (GND), RGBX.3, U1.3 (GND), U1.5 (GND), U1.21 (AGND), V3.7.2, VR1.1 (GND), X3.2
LED: R4.1, U1.9 (PD5)
MISO: ISCP.1, U1.16 (PB4)
MOSI: ISCP.4, U1.15 (PB3)
unnamed: INC.1, R3.2
unnamed: RGB1.1 (OUT), RGB2.1 (IN)
unnamed: RGB2.3 (OUT), RGB3.1 (IN)
unnamed: RGB3.3 (OUT), RGB4.1 (IN)
unnamed: RGB4.3 (OUT), RGB5.1 (IN)
unnamed: R6.2, RGBX.1
unnamed: R4.2, R5.2, RGB1.3 (IN)
unnamed: PD4.1, U1.2 (PD4)
unnamed: R6.1, RGB5.3 (OUT)
unnamed: DEC.1, R2.2
unnamed: PD3.1, U1.1 (PD3)
unnamed: PD2.1, U1.32 (PD2)
unnamed: PB2.1, U1.14 (PB2)
unnamed: PB1.1, U1.13 (PB1)
unnamed: PB0.1, U1.12 (PB0)
unnamed: ADC6.1, U1.19 (ADC6)
unnamed: ADC7.1, U1.22 (ADC7)
unnamed: AREF.1, U1.20 (AREF)
RX: PD0.1, U1.30 (PD0)
SCK: ISCP.3, U1.17 (PB5)
TX: PD1.1, U1.31 (PD1)
XTAL1: C4.1, U1.7 (PB6), X1.1, X2.1, X3.1
XTAL2: C5.1, U1.8 (PB7), X1.3, X2.2, X3.3

Notes on the sheet:
Pick one.
LED FX
Zodiac Synth
Cancer
SATAN'S CYCLE WORKS

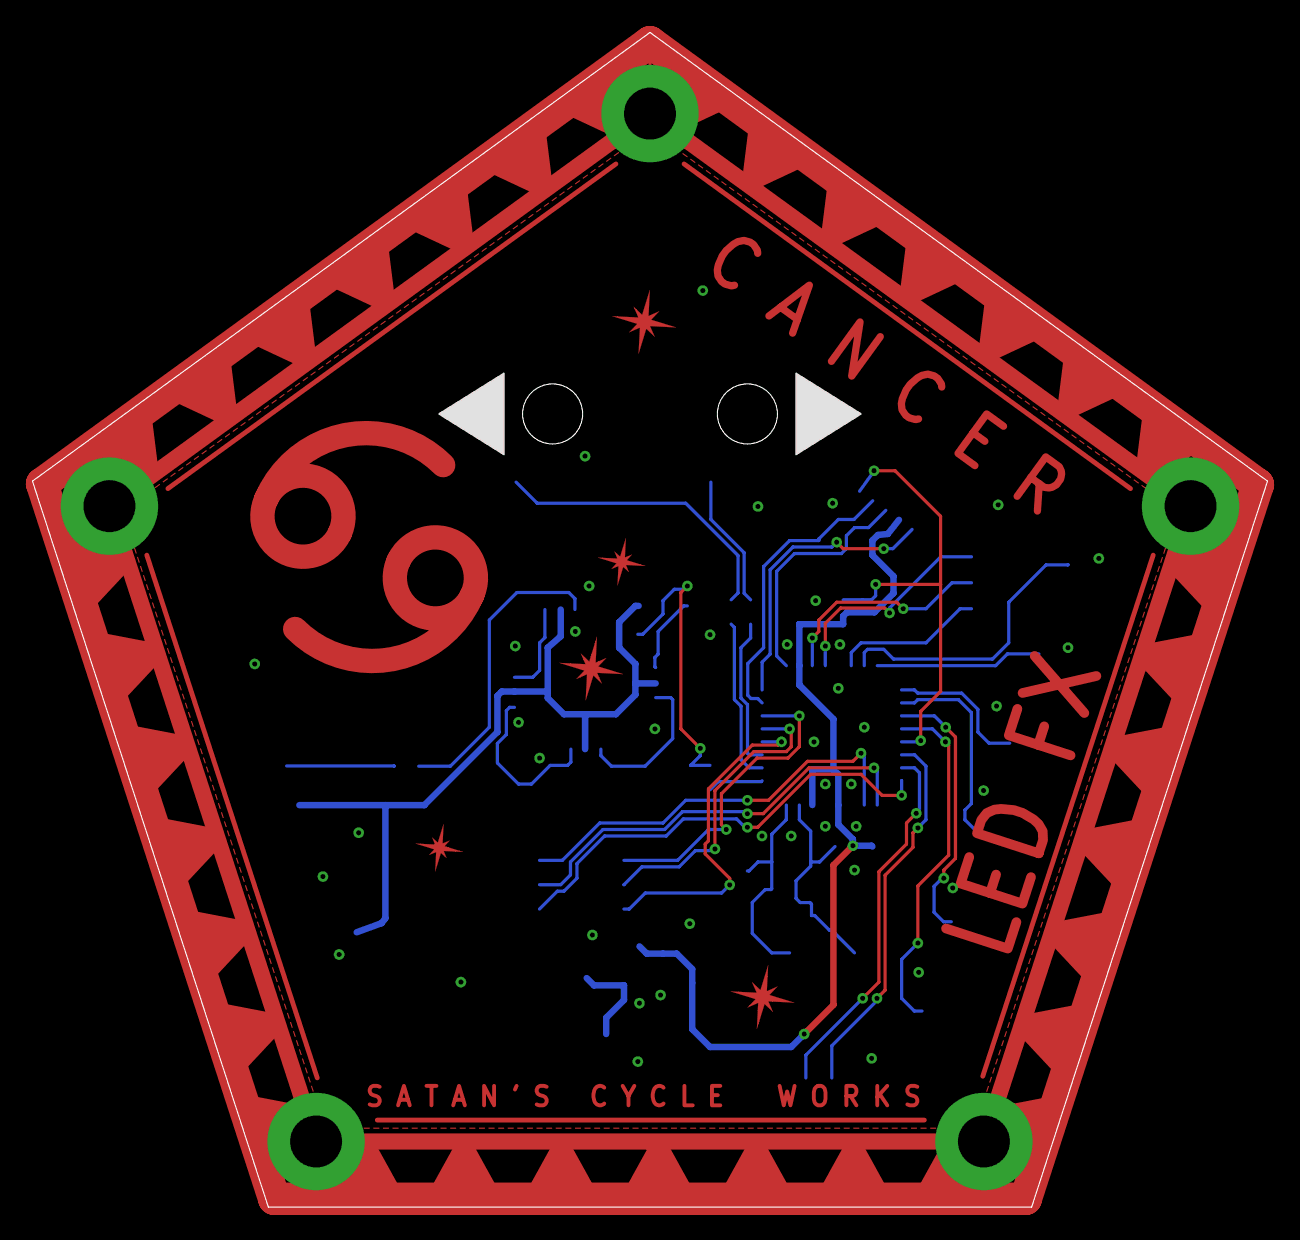
[picture p33: board synth-zodiac-cancer-led.brd from above]

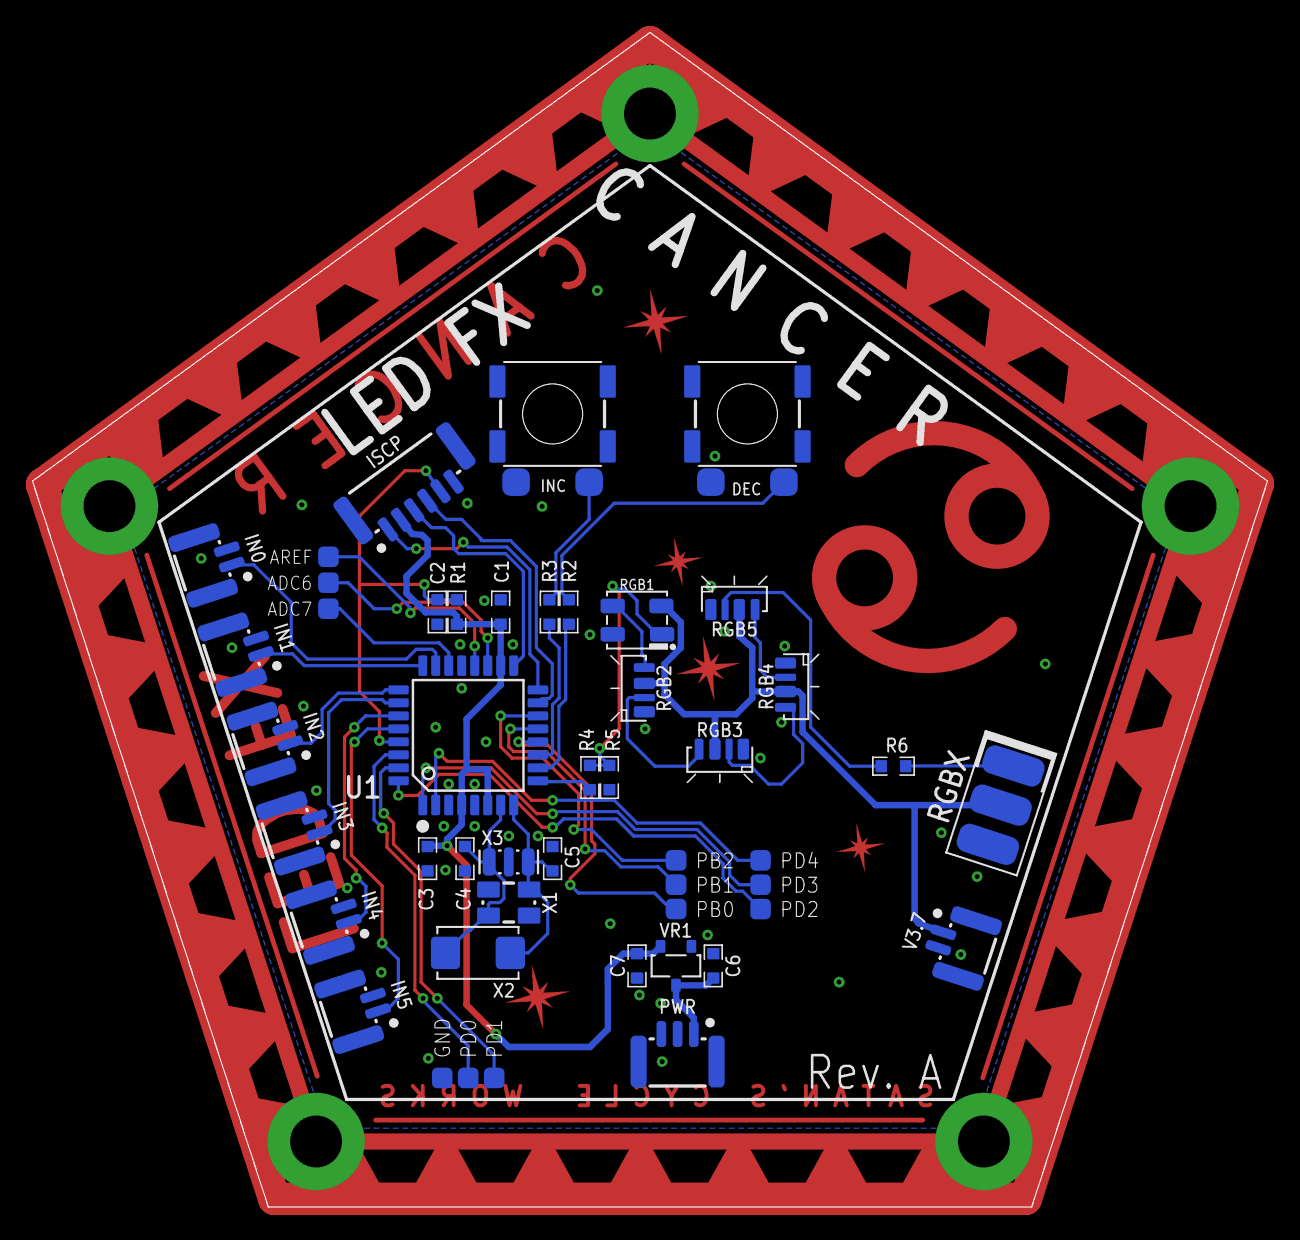
[picture p34: board synth-zodiac-cancer-led.brd from below]

Board: 2 copper layers, 76.1 x 72.4 mm, 50 parts (45 on the bottom side), 39 nets.
