CircuitMonkey/synth-zodiac/PCB/synth-zodiac-sagittarius-speaker.brd

## EAGLE design PCB/synth-zodiac-sagittarius-speaker.brd (2023-12-11)

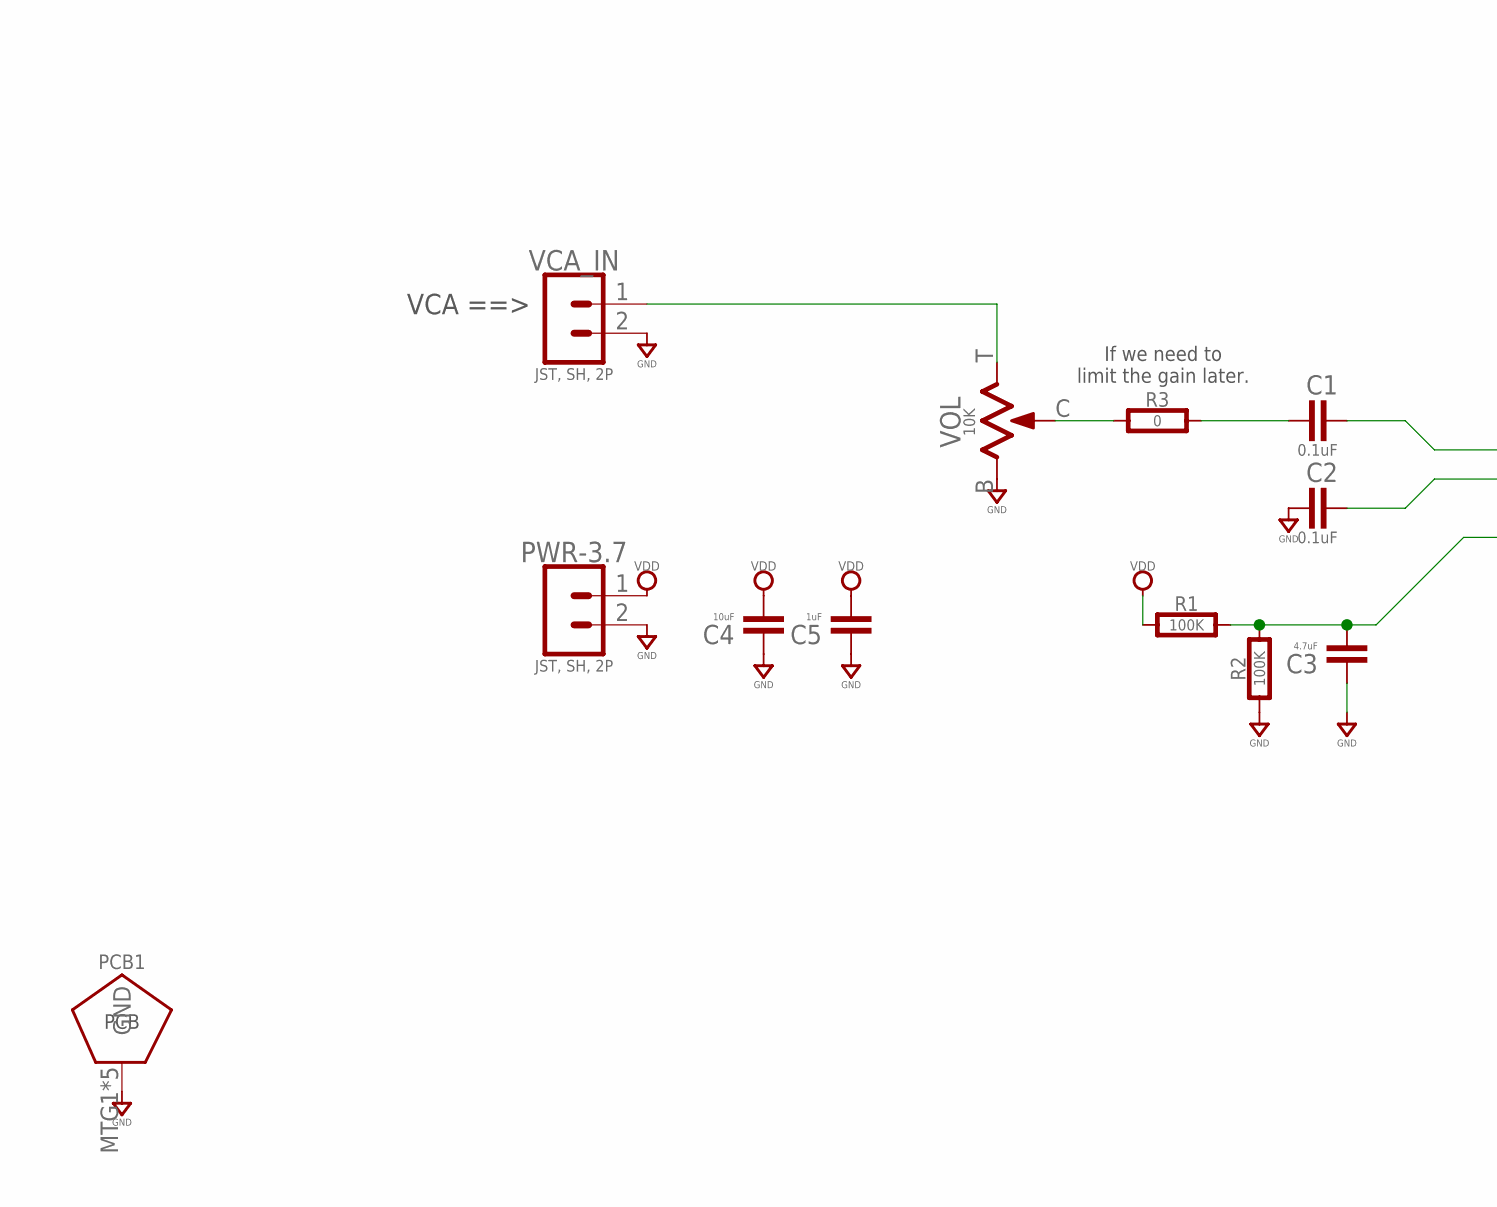
[picture p35: schematic synth-zodiac-sagittarius-speaker.sch, part in row 2, column 1]

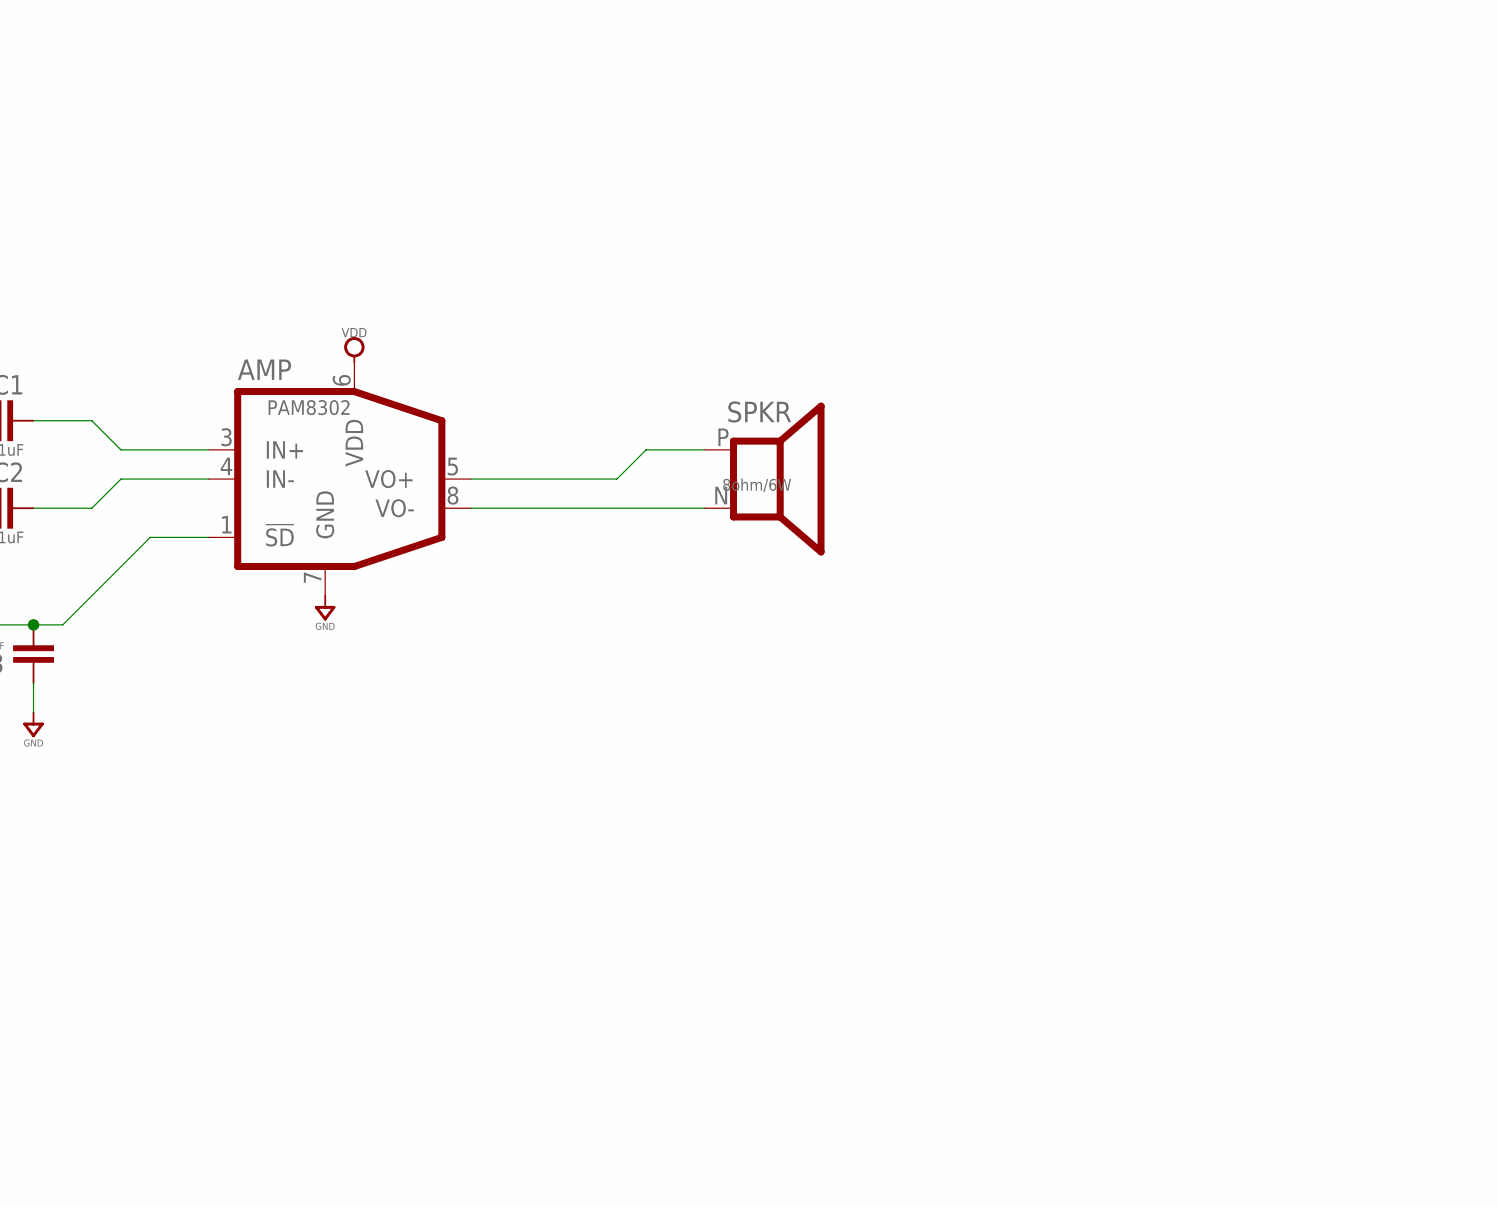
[picture p36: schematic synth-zodiac-sagittarius-speaker.sch, part in row 2, column 2]

Parts:
AMP: PAM8302; U-DFN3030-8
C1, C2: 0.1uF; 0603-CAP
C3: 4.7uF; 0603-CAP
C4: 10uF; 0603-CAP
C5: 1uF; 0603-CAP
PCB1: PCB FAB; PENTAGON-40MM-RAD
PWR-3.7: JST, SH, 2P; BM02B-SRSS-TB
R1, R2: 100K; 0603-RES
R3: 0; 0603-RES
SPKR: 8ohm/6W; SPKR-40X30
VCA_IN: JST, SH, 2P; BM02B-SRSS-TB
VOL: 10K; POT-RV9110

Connections:
GND: AMP.7 (GND), C2.1, C3.1, C4.1, C5.1, PCB1.MTG1, PCB1.MTG2, PCB1.MTG3, PCB1.MTG4, PCB1.MTG5, PWR-3.7.2, R2.1, VCA_IN.2, VOL.B (1)
unnamed: AMP.3 (IN+), C1.2
unnamed: AMP.4 (IN-), C2.2
unnamed: VCA_IN.1, VOL.T (3)
unnamed: C1.1, R3.2
unnamed: AMP.1 (!SD), C3.2, R1.2, R2.2
unnamed: AMP.5 (VO+), SPKR.P (+)
unnamed: AMP.8 (VO-), SPKR.N (-)
unnamed: R3.1, VOL.C (2)
VDD: AMP.6 (VDD), C4.2, C5.2, PWR-3.7.1, R1.1

Notes on the sheet:
VCA ==>
If we need to limit the gain later.
Amp & Speaker
Zodiac Synth
Sagittarius
SATAN'S CYCLE WORKS

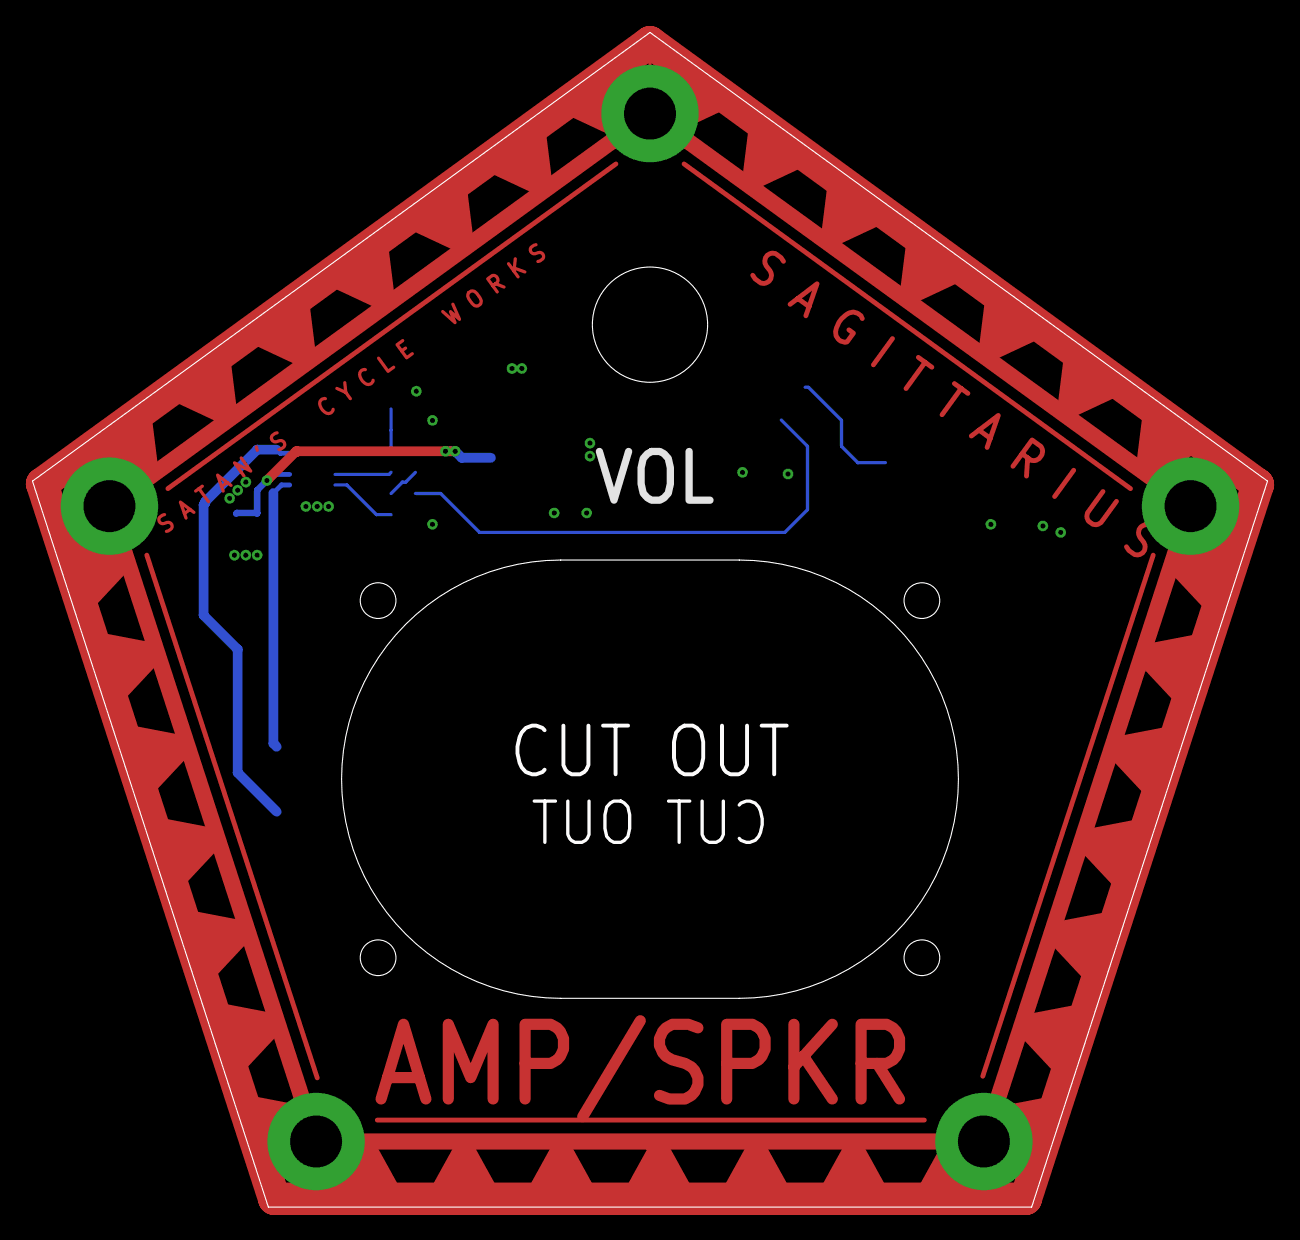
[picture p37: board synth-zodiac-sagittarius-speaker.brd from above]

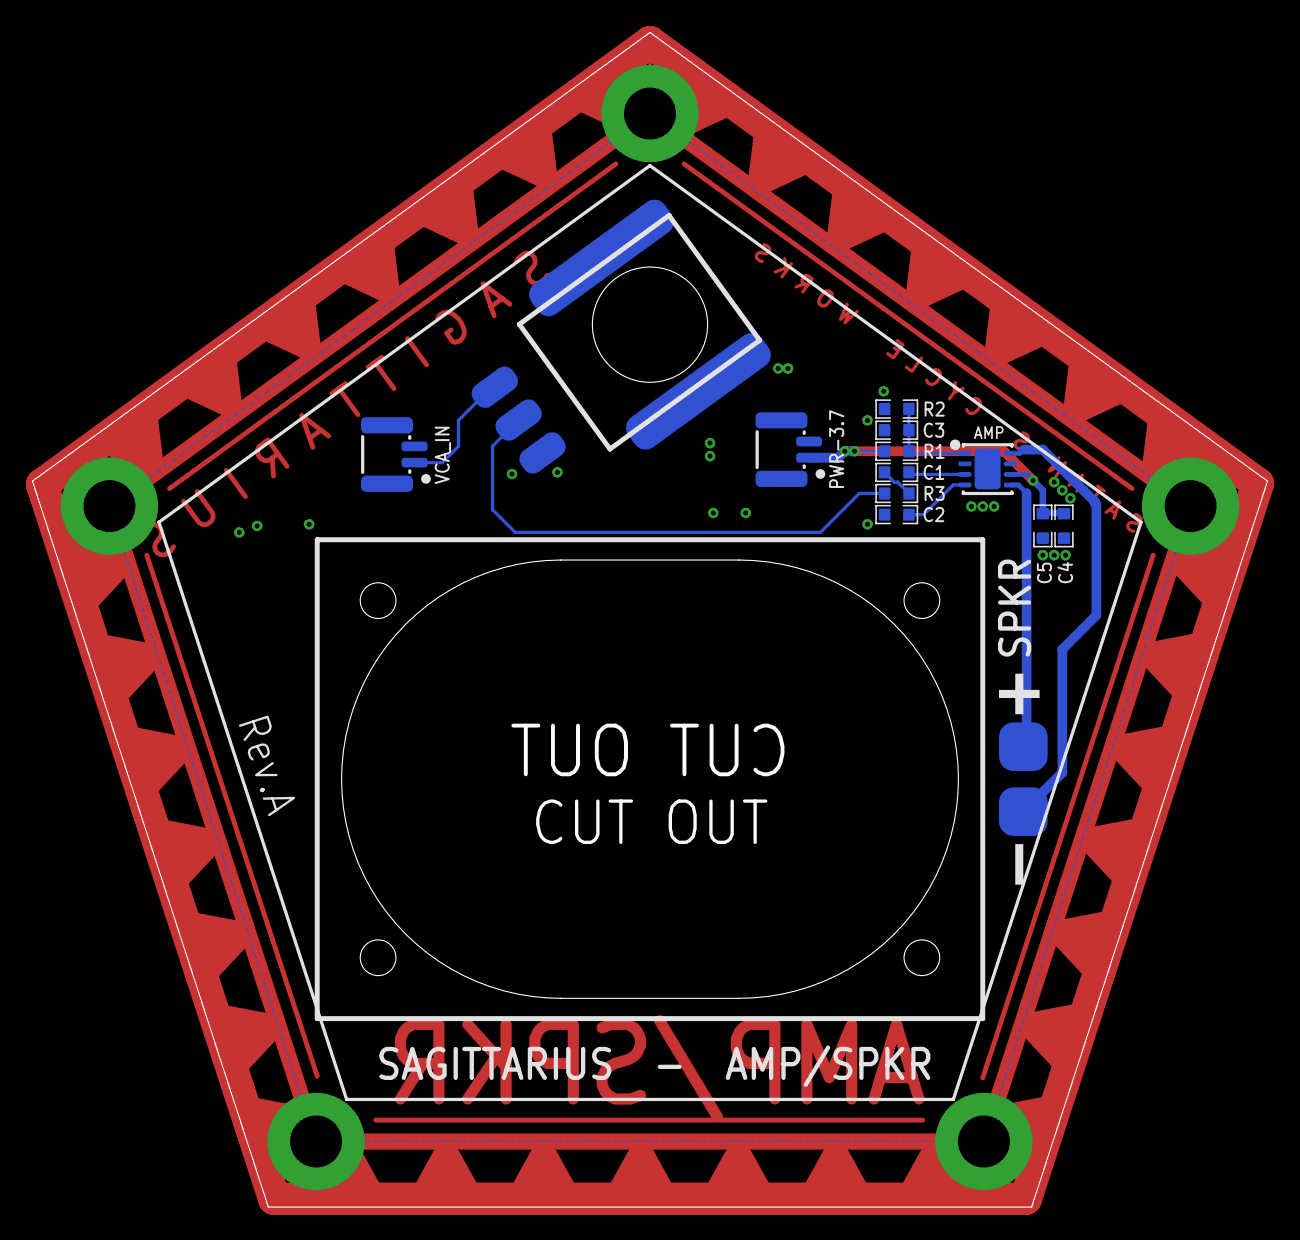
[picture p38: board synth-zodiac-sagittarius-speaker.brd from below]

Board: 2 copper layers, 76.1 x 72.4 mm, 14 parts (13 on the bottom side), 10 nets.
