CircuitMonkey/synth-zodiac/PCB/synth-zodiac-pisces-vco-mod.brd

## EAGLE design PCB/synth-zodiac-pisces-vco-mod.brd (2023-12-11)

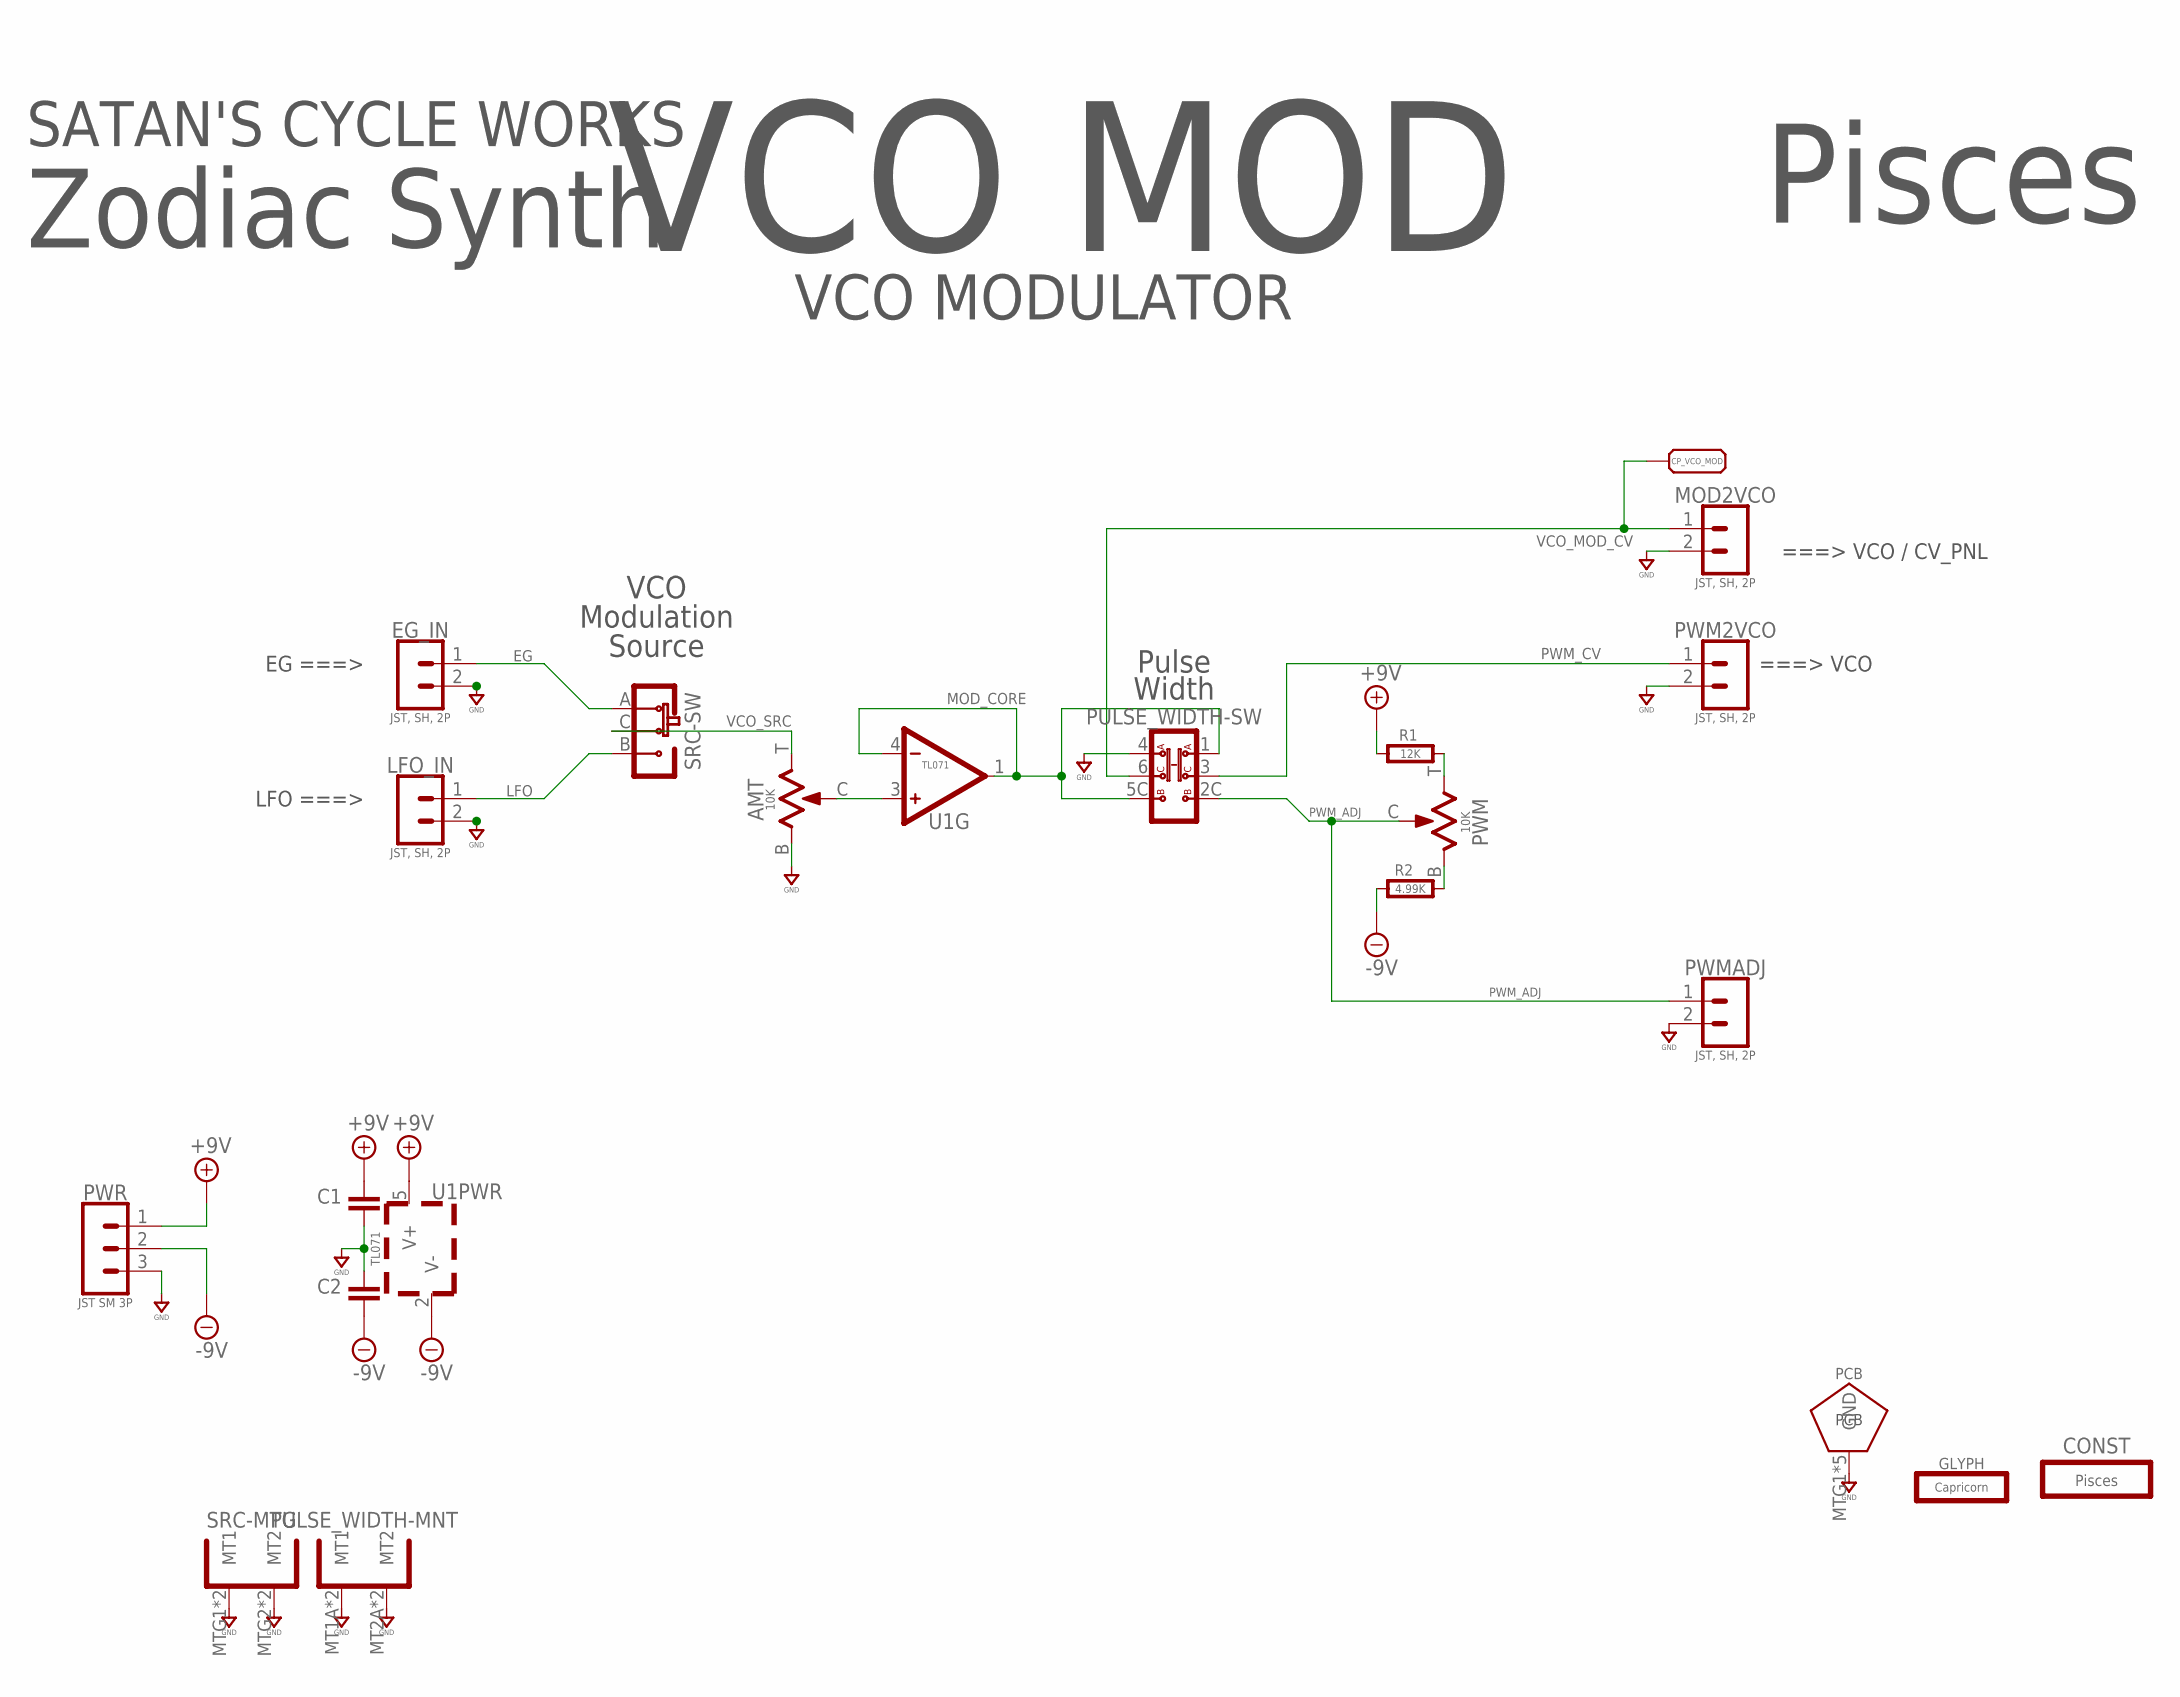
[picture p39: schematic synth-zodiac-pisces-vco-mod.sch]

Parts:
AMT: 10K; POT-RV9110
C1, C2: 0.1uF; 0603-CAP
CONST: Pisces; PISCES-CONST
CP_VCO_MOD: PADSMD-070X070; SMD-070MIL
EG_IN: JST, SH, 2P; BM02B-SRSS-TB
GLYPH: Capricorn; CAPRICORN-GLYPH
LFO_IN: JST, SH, 2P; BM02B-SRSS-TB
MOD2VCO: JST, SH, 2P; BM02B-SRSS-TB
PCB: PCB FAB; PENTAGON-40MM-RAD
PULSE_WIDTH: Switch, DPDT; CK_OS202013MT5-PNL-SMT-2
PWM: 10K; POT-RV9110
PWM2VCO: JST, SH, 2P; BM02B-SRSS-TB
PWMADJ: JST, SH, 2P; BM02B-SRSS-TB
PWR: JST SM 3P; BM03B-SRSS-TB
R1: 12K; 0603-RES
R2: 4.99K; 0603-RES
SRC: SLIDE-SPDT-MNTSS-12-F45-TH-PCB-2; SS-12-F45-PNL-SMT-2
U1: TL071; SOT-23-5

Connections:
+9V: C1.1, PWR.1, R1.1, U1.5 (V+)
-9V: C2.2, PWR.2, R2.2, U1.2 (V-)
EG: EG_IN.1, SRC.A
GND: AMT.B (1), C1.2, C2.1, EG_IN.2, LFO_IN.2, MOD2VCO.2, PCB.MTG1, PCB.MTG2, PCB.MTG3, PCB.MTG4, PCB.MTG5, PULSE_WIDTH.4 (2A), PULSE_WIDTH.MT1A (MT1), PULSE_WIDTH.MT2A (MT2), PULSE_WIDTH.MT3A (MT1), PULSE_WIDTH.MT4A (MT2), PWM2VCO.2, PWMADJ.2, PWR.3, SRC.MTG1 (MT1), SRC.MTG2 (MT2), SRC.MTG3 (MT1), SRC.MTG4 (MT2)
LFO: LFO_IN.1, SRC.B
MOD_CORE: PULSE_WIDTH.1 (1A), PULSE_WIDTH.5C (2B), U1.1 (OUT), U1.4 (-)
unnamed: AMT.C (2), U1.3 (+)
unnamed: PWM.B (1), R2.1
unnamed: PWM.T (3), R1.2
PWM_ADJ: PULSE_WIDTH.2C (1B), PWM.C (2), PWMADJ.1
PWM_CV: PULSE_WIDTH.3 (1C), PWM2VCO.1
VCO_MOD_CV: CP_VCO_MOD.1, MOD2VCO.1, PULSE_WIDTH.6 (2C)
VCO_SRC: AMT.T (3), SRC.C

Notes on the sheet:
VCO MODULATOR
VCO Modulation Source
Pulse Width
EG ===>
LFO ===>
===> VCO / CV_PNL
===> VCO
VCO MOD
Zodiac Synth
Pisces
SATAN'S CYCLE WORKS

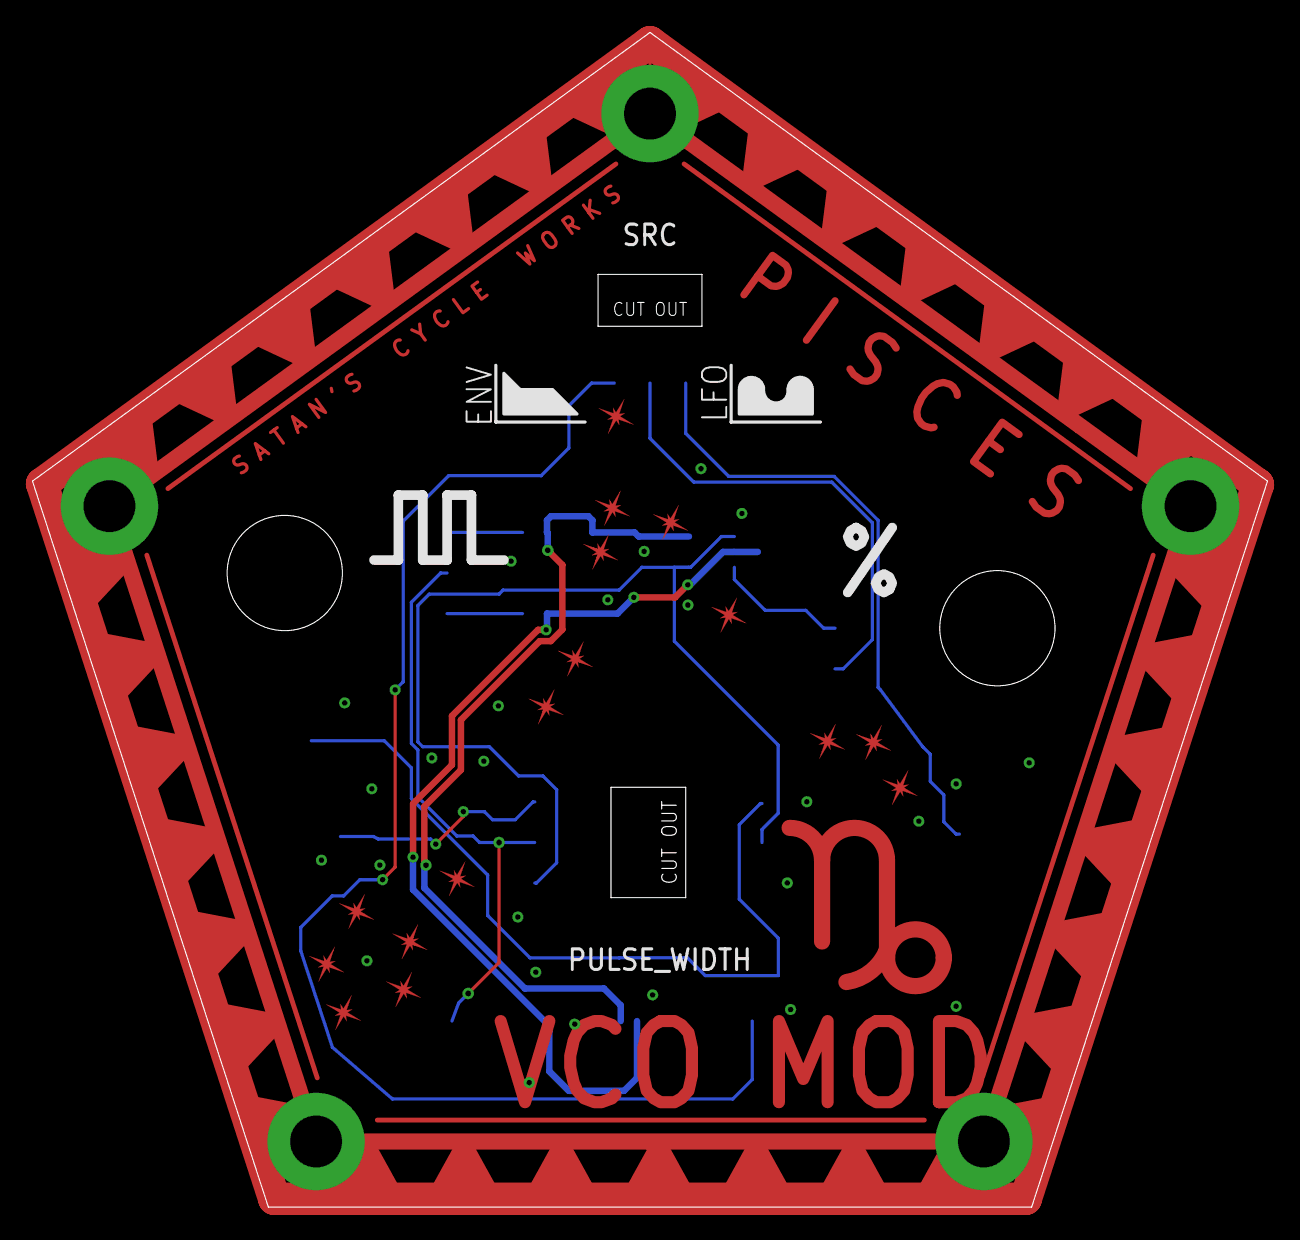
[picture p40: board synth-zodiac-pisces-vco-mod.brd from above]

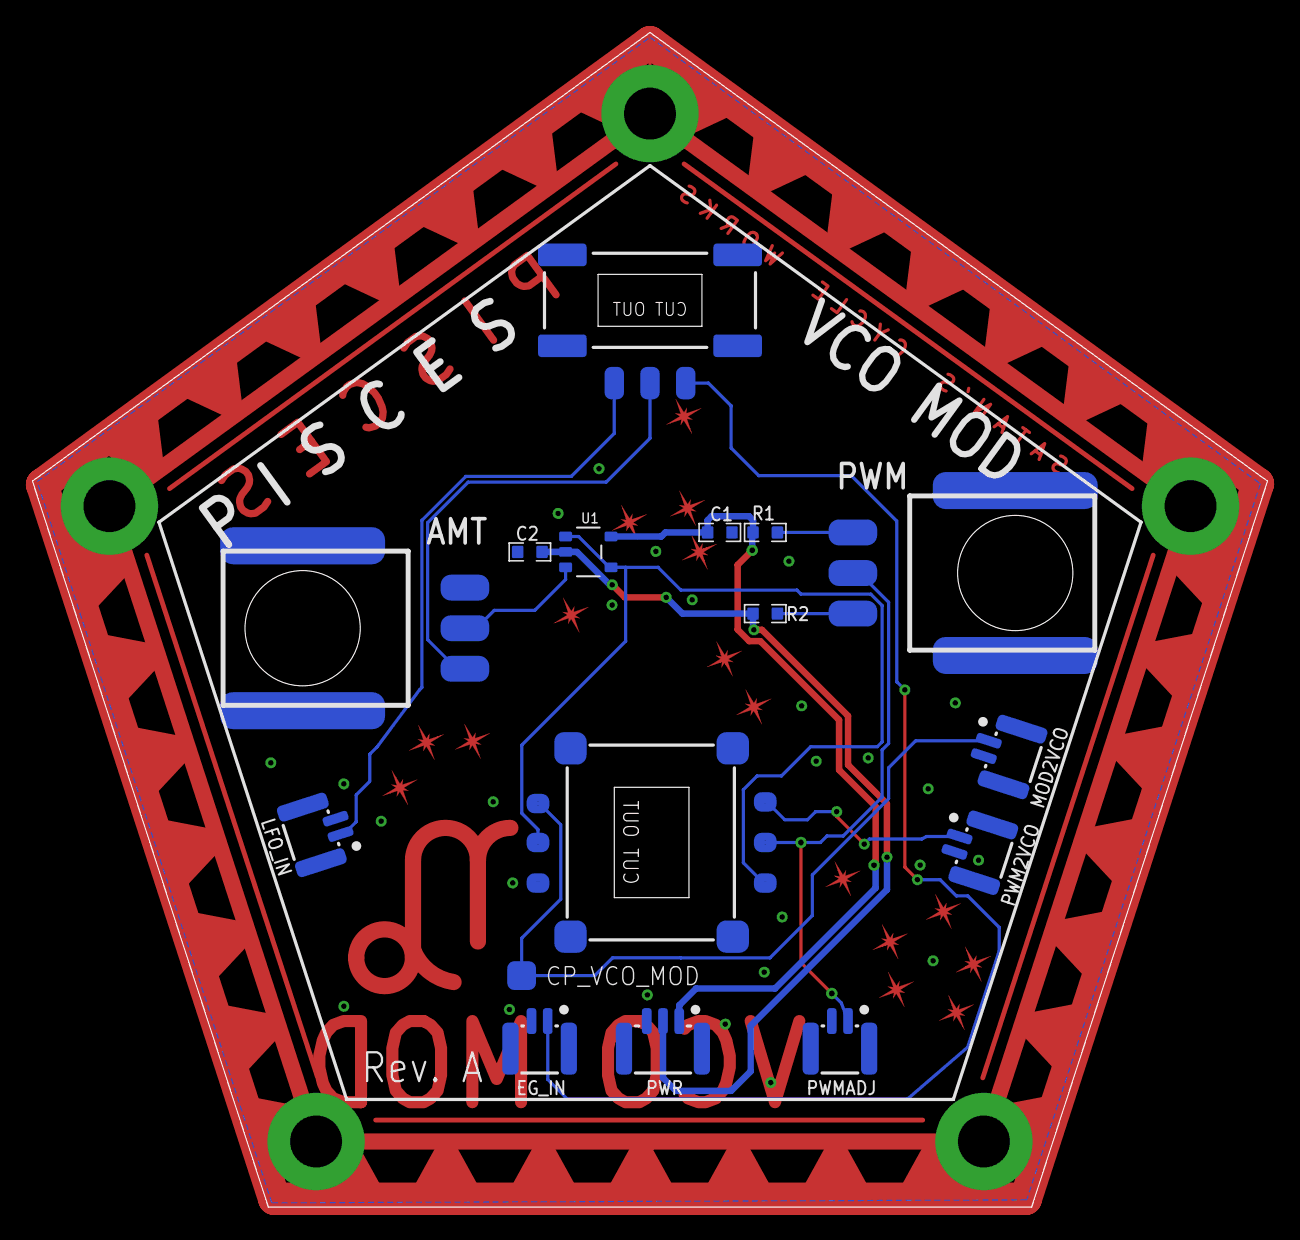
[picture p41: board synth-zodiac-pisces-vco-mod.brd from below]

Board: 2 copper layers, 76.1 x 72.4 mm, 19 parts (14 on the bottom side), 13 nets.
