CircuitMonkey/synth-zodiac/PCB/synth-zodiac-libra-vca.brd

## EAGLE design PCB/synth-zodiac-libra-vca.brd (2023-12-11)

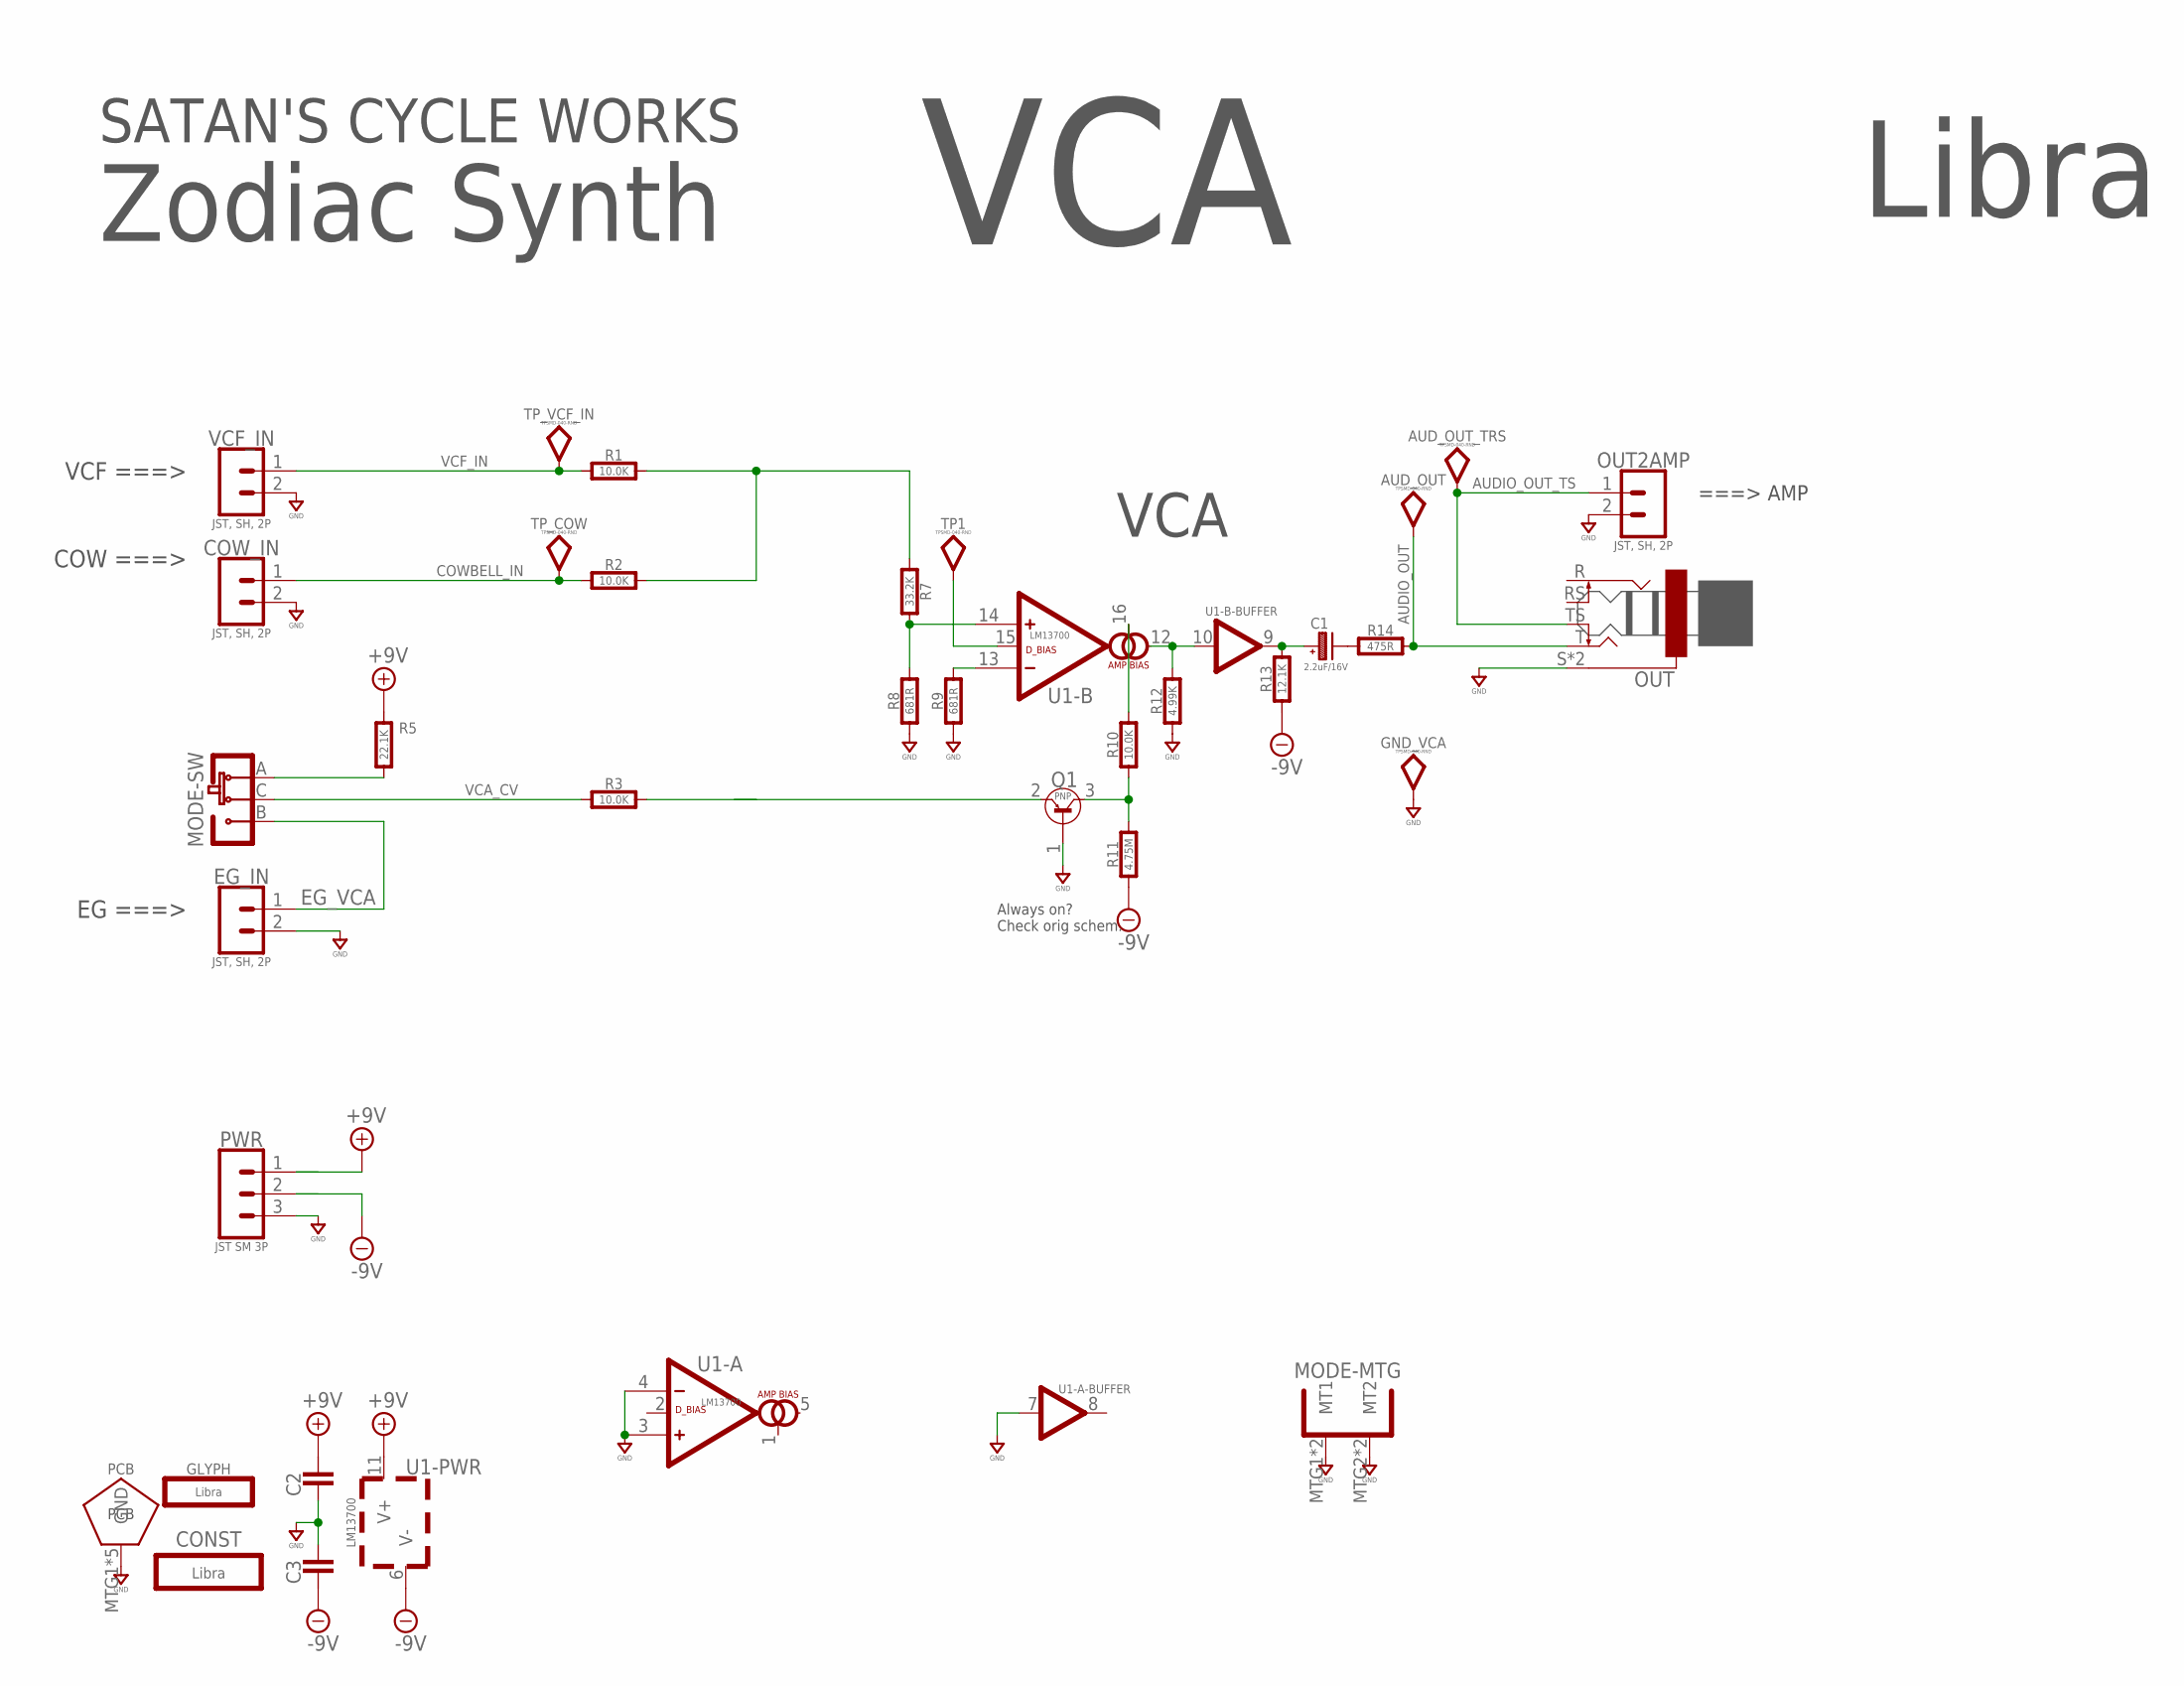
[picture p42: schematic synth-zodiac-libra-vca.sch]

Parts:
AUD_OUT: TPSMD-040-RND; SMD-040MIL-RND
AUD_OUT_TRS: TPSMD-040-RND; SMD-040MIL-RND
C1: 2.2uF/16V; CAP_ALUM_SMT_4
C2, C3: 0.1uF; 0603-CAP
CONST: Libra; LIBRA-CONST
COW_IN: JST, SH, 2P; BM02B-SRSS-TB
EG_IN: JST, SH, 2P; BM02B-SRSS-TB
GLYPH: Libra; LIBRA-GLYPH
GND_VCA: TPSMD-040-RND; SMD-040MIL-RND
MODE: SLIDE-SPDT-MNTSS-12-F45-TH-PCB-2; SS-12-F45-PNL-SMT-2
OUT: 6.35MM JACK; PNL-6.35-SMT-PADS
OUT2AMP: JST, SH, 2P; BM02B-SRSS-TB
PCB: PCB FAB; PENTAGON-40MM-RAD
PWR: JST SM 3P; BM03B-SRSS-TB
Q1: PNP; SOT-23
R1, R2, R3, R10: 10.0K; 0603-RES
R5: 22.1K; 0603-RES
R7: 33.2K; 0603-RES
R8, R9: 681R; 0603-RES
R11: 4.75M; 0603-RES
R12: 4.99K; 0603-RES
R13: 12.1K; 0603-RES
R14: 475R; 0603-RES
TP1: TPSMD-040-RND; SMD-040MIL-RND
TP_COW: TPSMD-040-RND; SMD-040MIL-RND
TP_VCF_IN: TPSMD-040-RND; SMD-040MIL-RND
U1: LM13700; SO16
VCF_IN: JST, SH, 2P; BM02B-SRSS-TB

Connections:
+9V: C2.2, PWR.1, R5.2, U1.11 (V+)
-9V: C3.1, PWR.2, R11.1, R13.1, U1.6 (V-)
AUDIO_OUT: AUD_OUT.TP, OUT.T, R14.2
AUDIO_OUT_TS: AUD_OUT_TRS.TP, OUT.TS (TN), OUT2AMP.1
COWBELL_IN: COW_IN.1, R2.1, TP_COW.TP
EG_VCA: EG_IN.1, MODE.B
GND: C2.1, C3.2, COW_IN.2, EG_IN.2, GND_VCA.TP, MODE.MTG1 (MT1), MODE.MTG2 (MT2), MODE.MTG3 (MT1), MODE.MTG4 (MT2), OUT.S, OUT.SS (S), OUT2AMP.2, PCB.MTG1, PCB.MTG2, PCB.MTG3, PCB.MTG4, PCB.MTG5, PWR.3, Q1.1 (BASE), R8.1, R9.1, R12.1, U1.3 (+), U1.4 (-), U1.7 (IN), VCF_IN.2
unnamed: R9.2, U1.13 (-)
unnamed: R7.2, R8.2, U1.14 (+)
unnamed: TP1.TP, U1.15 (DIODE-BIAS)
unnamed: R12.2, U1.10 (IN), U1.12 (OUT)
unnamed: R10.2, U1.16 (AMP-BIAS)
unnamed: C1.POS, R13.2, U1.9 (OUT)
unnamed: C1.NEG (N), R14.1
unnamed: Q1.3 (COLLECTOR), R10.1, R11.2
unnamed: Q1.2 (EMITTER), R3.2
unnamed: MODE.A, R5.1
VCA_CV: MODE.C, R3.1
VCF_IN: R1.1, TP_VCF_IN.TP, VCF_IN.1
VCF_OUT: R1.2, R2.2, R7.1

Notes on the sheet:
VCA
Always on? Check orig schem.
===> AMP
VCF ===>
EG ===>
COW ===>
Zodiac Synth
Libra
SATAN'S CYCLE WORKS

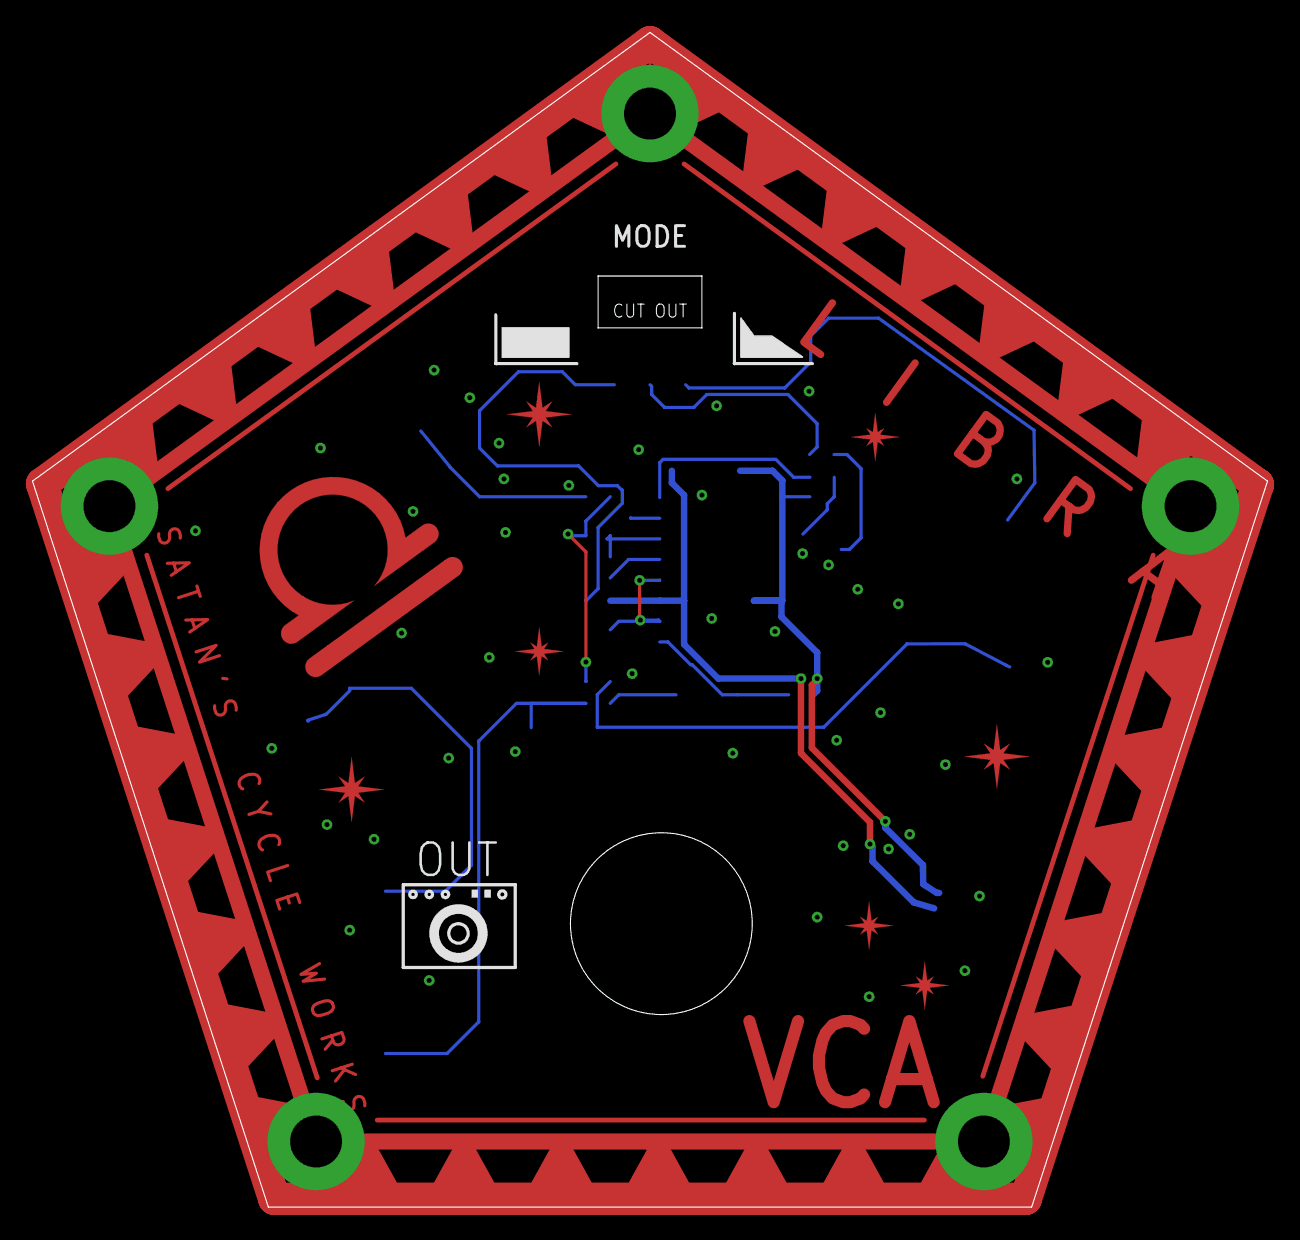
[picture p43: board synth-zodiac-libra-vca.brd from above]

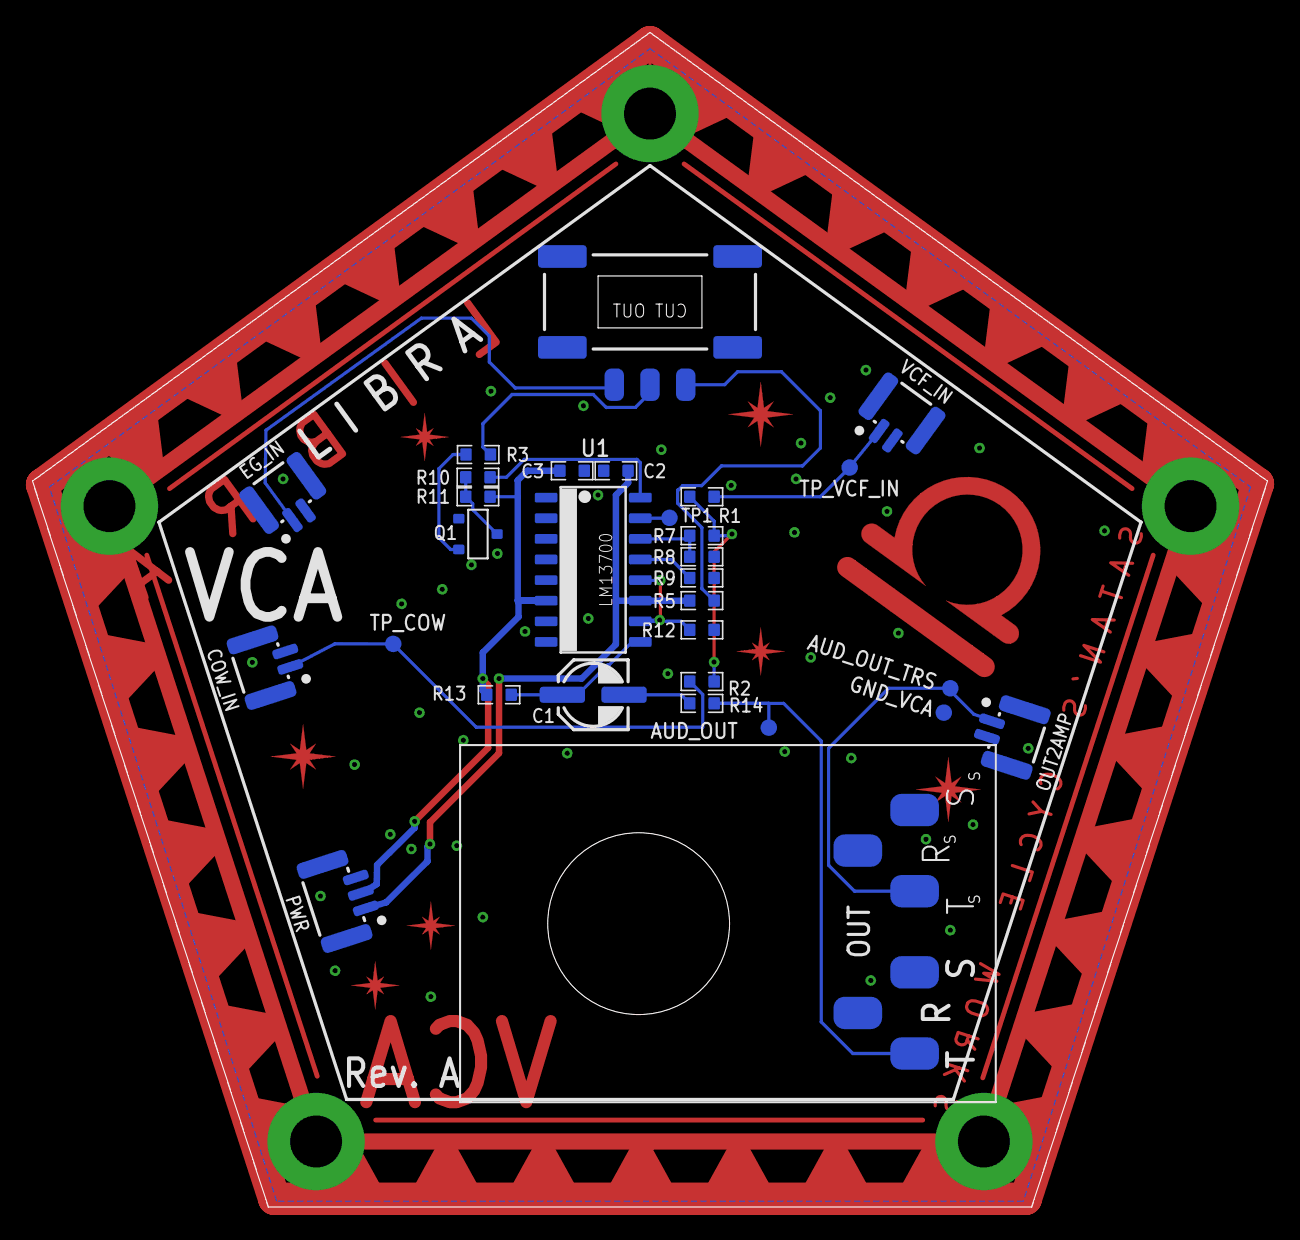
[picture p44: board synth-zodiac-libra-vca.brd from below]

Board: 2 copper layers, 76.1 x 72.4 mm, 33 parts (29 on the bottom side), 20 nets.
