CircuitMonkey/synth-zodiac/PCB/synth-zodiac-aries-vcf.brd

## EAGLE design PCB/synth-zodiac-aries-vcf.brd (2023-12-11)

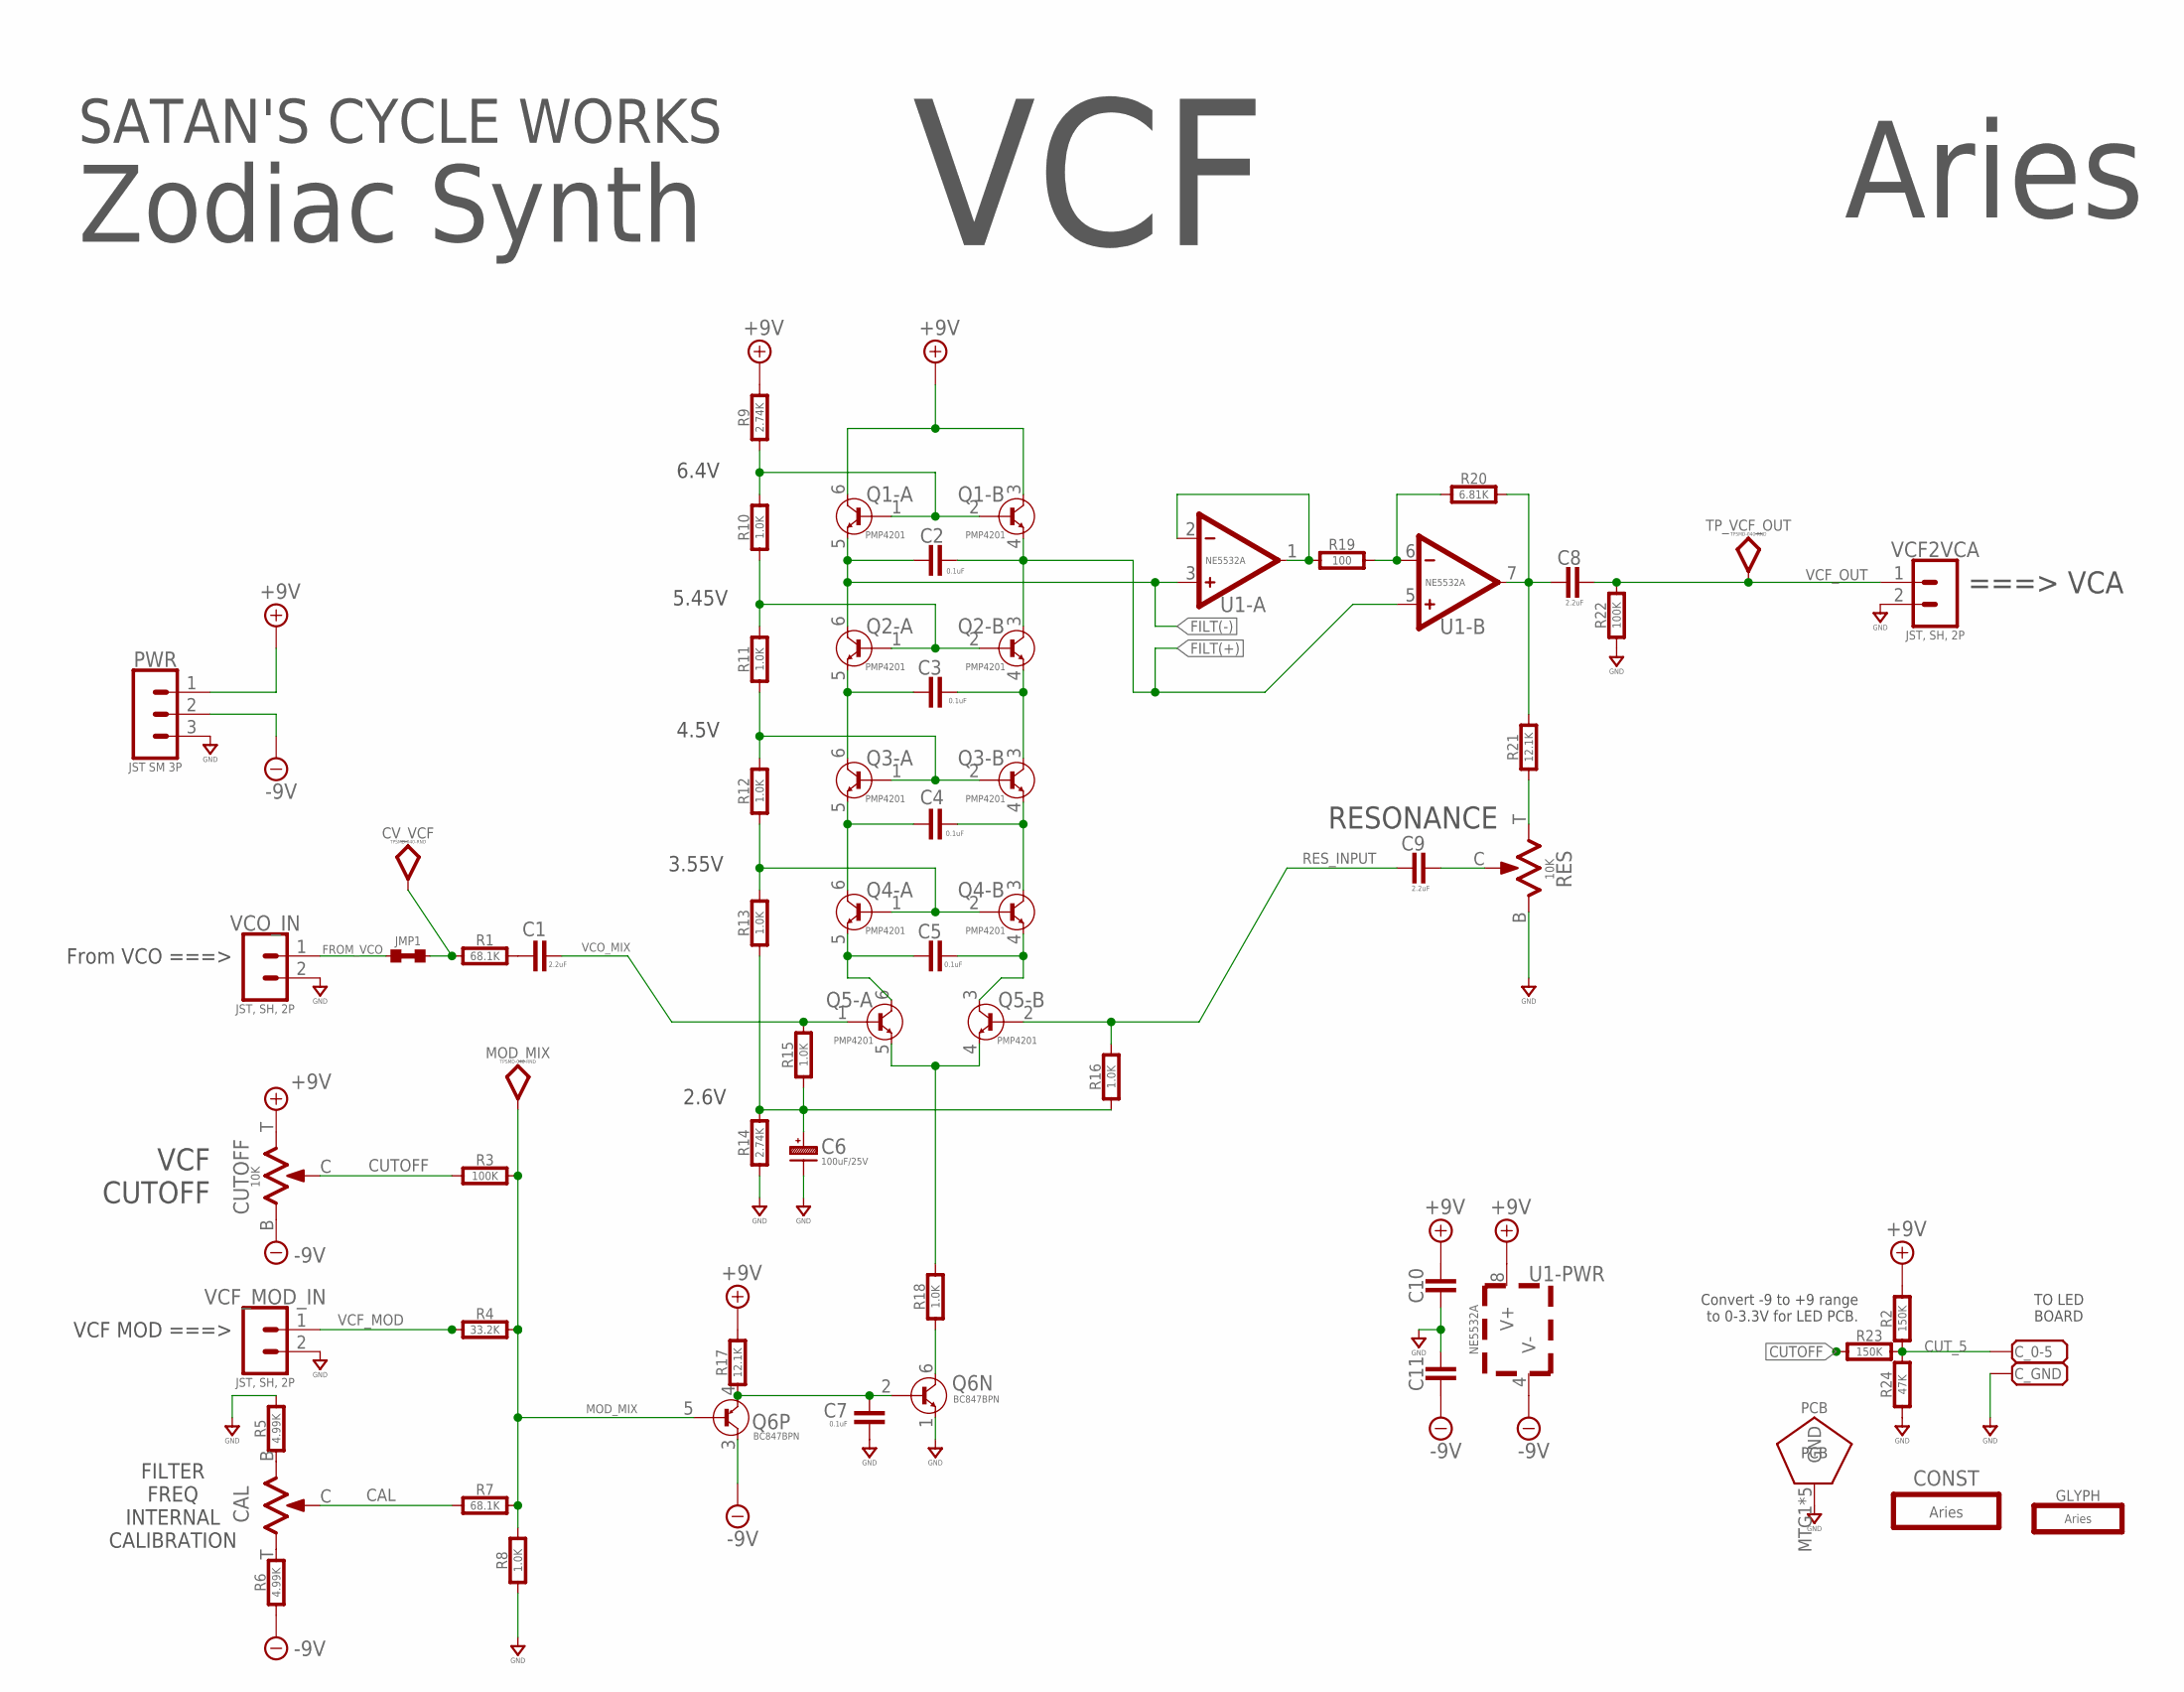
[picture p45: schematic synth-zodiac-aries-vcf.sch]

Parts:
C1, C8, C9: 2.2uF; 0603-CAP
C2, C3, C4, C5, C7, C10, C11: 0.1uF; 0603-CAP
C6: 100uF/25V; CAP_ALUM_SMT_6.3; MPN 865090445008
CAL: 10K; TRIM_BOURNS_TC33X
CONST: Aries; ARIES-CONST
CUTOFF: 10K; POT-RV9110
CV_VCF: TPSMD-040-RND; SMD-040MIL-RND
C_0-5: PADSMD-070X070; SMD-070MIL
C_GND: PADSMD-070X070; SMD-070MIL
GLYPH: Aries; ARIES-GLYPH
JMP1: NP; 0603-SHORT
MOD_MIX: TPSMD-040-RND; SMD-040MIL-RND
PCB: PCB FAB; PENTAGON-40MM-RAD
PWR: JST SM 3P; BM03B-SRSS-TB
Q1, Q2, Q3, Q4, Q5: PMP4201; SOT666
Q6: BC847BPN; SOT363
R1, R7: 68.1K; 0603-RES
R2, R23: 150K; 0603-RES
R3, R22: 100K; 0603-RES
R4: 33.2K; 0603-RES
R5, R6: 4.99K; 0603-RES
R8, R10, R11, R12, R13, R15, R16, R18: 1.0K; 0603-RES
R9, R14: 2.74K; 0603-RES
R17, R21: 12.1K; 0603-RES
R19: 100; 0603-RES
R20: 6.81K; 0603-RES
R24: 47K; 0603-RES
RES: 10K; POT-RV9110
TP_VCF_OUT: TPSMD-040-RND; SMD-040MIL-RND
U1: NE5532A; SOP08
VCF2VCA: JST, SH, 2P; BM02B-SRSS-TB
VCF_MOD_IN: JST, SH, 2P; BM02B-SRSS-TB
VCO_IN: JST, SH, 2P; BM02B-SRSS-TB

Connections:
+9V: C10.2, CUTOFF.T (3), PWR.1, Q1.3 (COLLECTOR), Q1.6 (COLLECTOR), R2.2, R9.2, R17.2, U1.8 (V+)
-9V: C11.1, CUTOFF.B (1), PWR.2, Q6.3 (COLLECTOR), R6.1, U1.4 (V-)
CAL: CAL.C (2), R7.1
CUTOFF: CUTOFF.C (2), R3.1, R23.1
CUT_5: C_0-5.1, R2.1, R23.2, R24.2
FILT(+): C2.2, Q1.4 (EMITTER), Q2.3 (COLLECTOR), U1.5 (+)
FILT(-): C2.1, Q1.5 (EMITTER), Q2.6 (COLLECTOR), U1.3 (+)
FROM_VCO: JMP1.3 (1), VCO_IN.1
GND: C6.- (N), C7.2, C10.1, C11.2, C_GND.1, PCB.MTG1, PCB.MTG2, PCB.MTG3, PCB.MTG4, PCB.MTG5, PWR.3, Q6.1 (EMITTER), R5.2, R8.1, R14.1, R22.1, R24.1, RES.B (1), VCF2VCA.2, VCF_MOD_IN.2, VCO_IN.2
MOD_MIX: MOD_MIX.TP, Q6.5 (BASE), R3.2, R4.2, R7.2, R8.2
unnamed: R19.2, R20.1, U1.6 (-)
unnamed: Q1.1 (BASE), Q1.2 (BASE), R9.1, R10.2
unnamed: C3.1, Q2.5 (EMITTER), Q3.6 (COLLECTOR)
unnamed: C3.2, Q2.4 (EMITTER), Q3.3 (COLLECTOR)
unnamed: Q2.1 (BASE), Q2.2 (BASE), R10.1, R11.2
unnamed: C4.1, Q3.5 (EMITTER), Q4.6 (COLLECTOR)
unnamed: C4.2, Q3.4 (EMITTER), Q4.3 (COLLECTOR)
unnamed: Q3.1 (BASE), Q3.2 (BASE), R11.1, R12.2
unnamed: C5.1, Q4.5 (EMITTER), Q5.6 (COLLECTOR)
unnamed: C5.2, Q4.4 (EMITTER), Q5.3 (COLLECTOR)
unnamed: Q4.1 (BASE), Q4.2 (BASE), R12.1, R13.2
unnamed: Q5.4 (EMITTER), Q5.5 (EMITTER), R18.2
unnamed: Q6.6 (COLLECTOR), R18.1
unnamed: C6.+, R13.1, R14.2, R15.1, R16.1
unnamed: C7.1, Q6.2 (BASE), Q6.4 (EMITTER), R17.1
unnamed: CAL.T (3), R6.2
unnamed: CAL.B (1), R5.1
unnamed: C1.1, R1.2
unnamed: R19.1, U1.1 (OUT), U1.2 (-)
unnamed: C8.1, R20.2, R21.2, U1.7 (OUT)
unnamed: R21.1, RES.T (3)
unnamed: C9.2, RES.C (2)
RES_INPUT: C9.1, Q5.2 (BASE), R16.2
VCF_IN: CV_VCF.TP, JMP1.4 (2), R1.1
VCF_MOD: R4.1, VCF_MOD_IN.1
VCF_OUT: C8.2, R22.2, TP_VCF_OUT.TP, VCF2VCA.1
VCO_MIX: C1.2, Q5.1 (BASE), R15.2

Notes on the sheet:
FILTER FREQ INTERNAL CALIBRATION
RESONANCE
VCF CUTOFF
===> VCA
From VCO ===>
VCF MOD ===>
6.4V
5.45V
4.5V
3.55V
2.6V
TO LED BOARD
Convert -9 to +9 range to 0-3.3V for LED PCB.
VCF
Zodiac Synth
Aries
SATAN'S CYCLE WORKS
