CircuitMonkey/synth-zodiac/PCB/synth-zodiac-aries-vcf.brd

## EAGLE design PCB/synth-zodiac-aries-vcf.brd (continued)

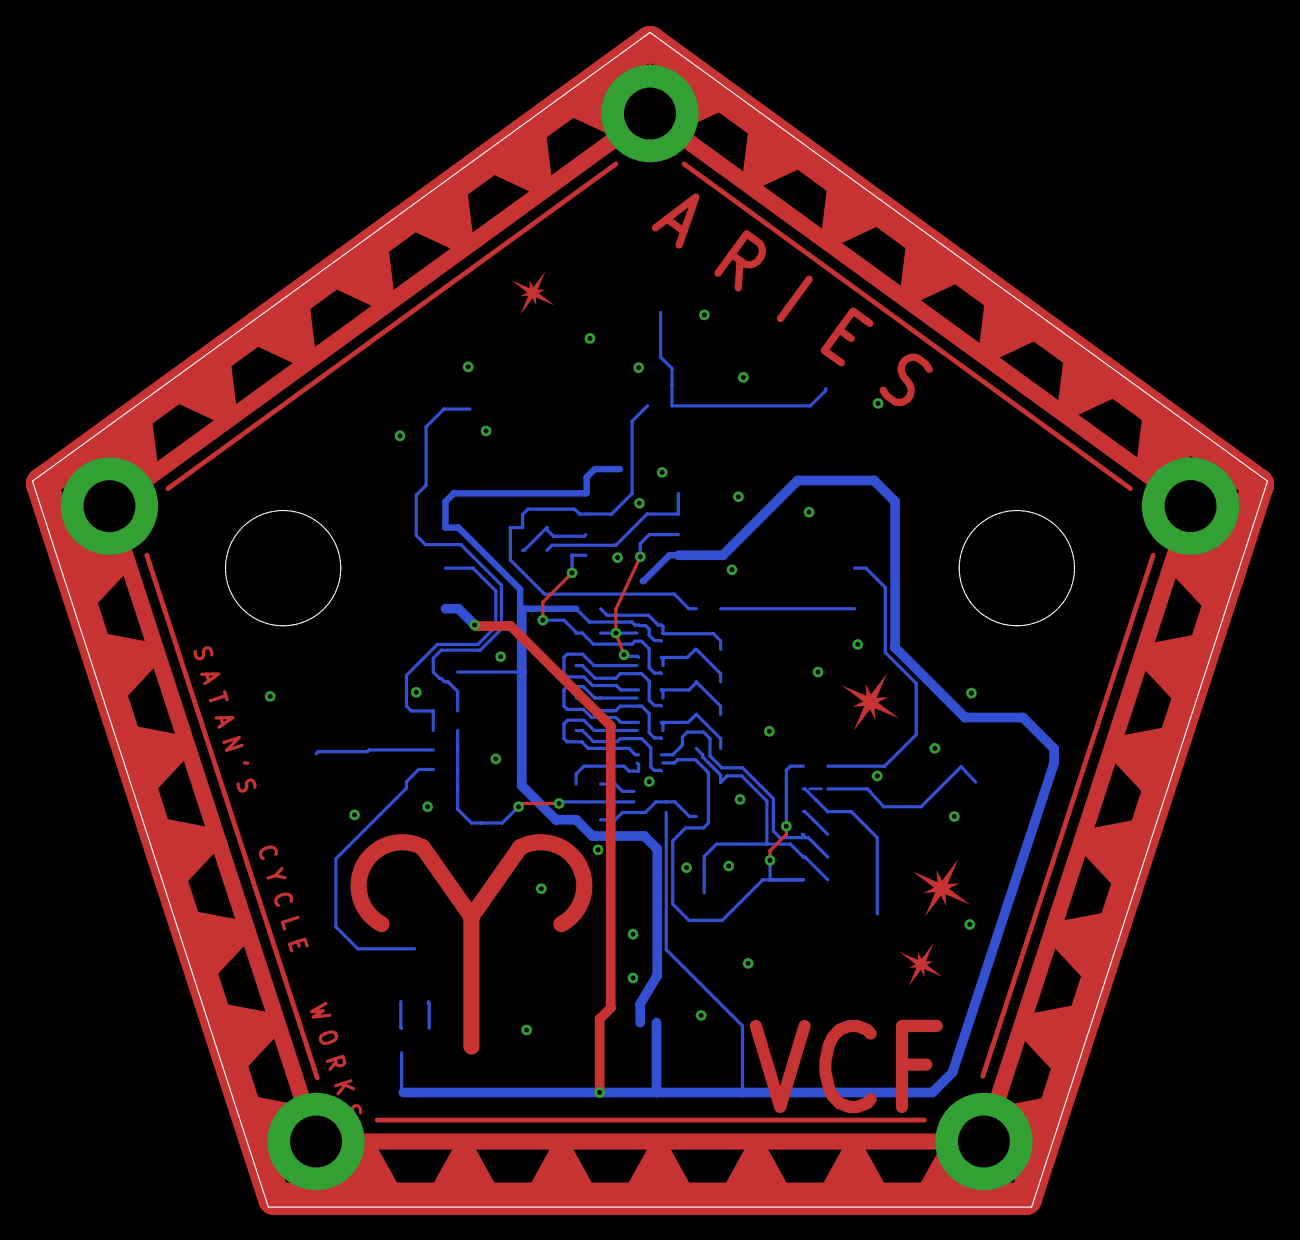
[picture p46: board synth-zodiac-aries-vcf.brd from above]

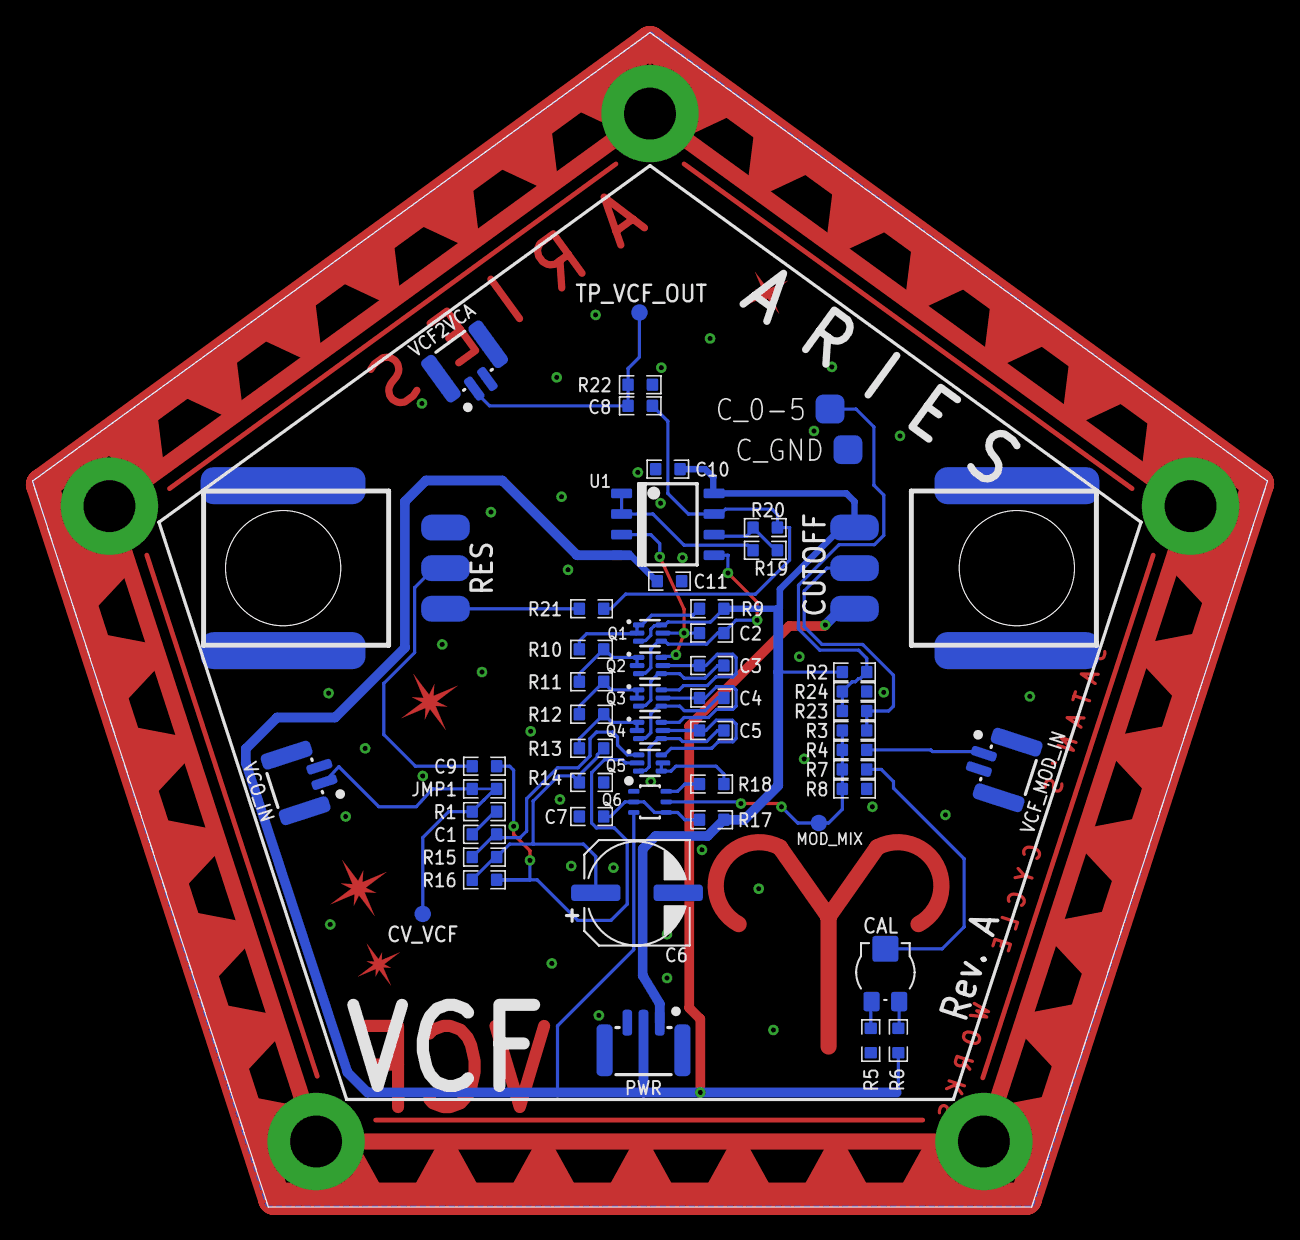
[picture p47: board synth-zodiac-aries-vcf.brd from below]

Board: 2 copper layers, 76.1 x 72.4 mm, 58 parts (55 on the bottom side), 37 nets.
