CircuitMonkey/synth-zodiac/PCB/synth-zodiac-aquarius-vco.brd

## EAGLE design PCB/synth-zodiac-aquarius-vco.brd (2023-12-11)

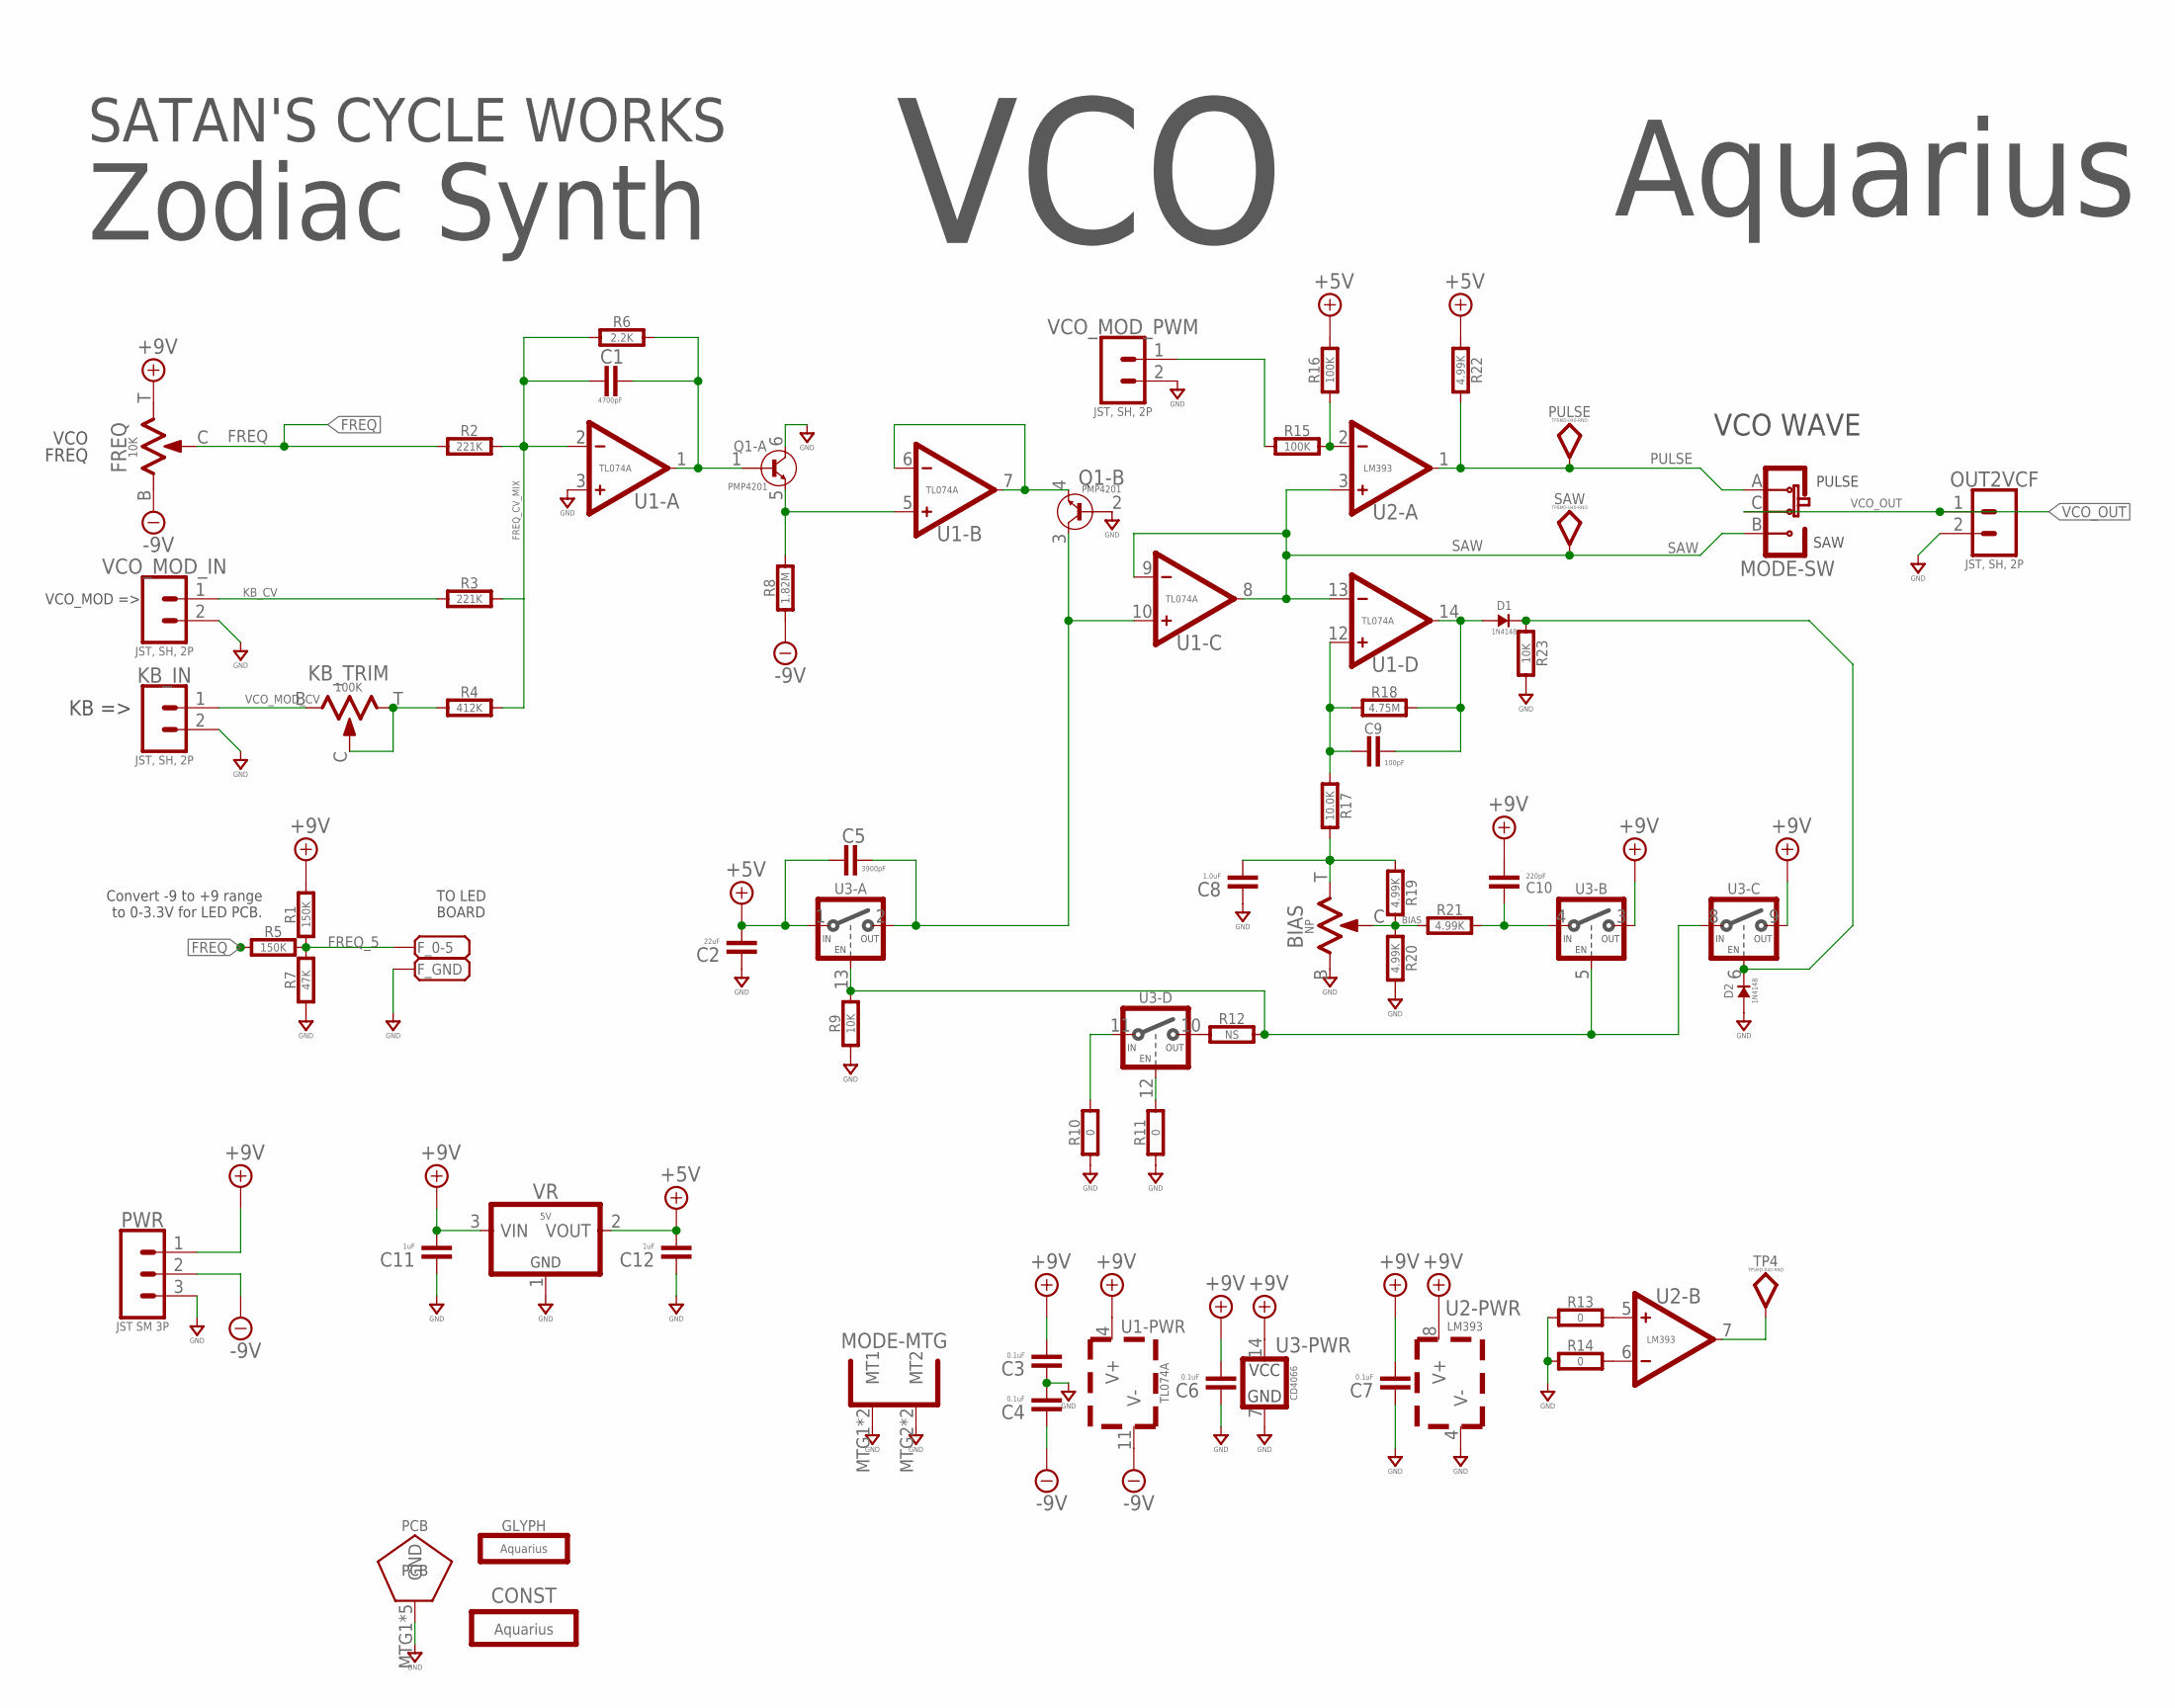
[picture p48: schematic synth-zodiac-aquarius-vco.sch]

Parts:
BIAS: NP; TRIM_BOURNS_TC33X
C1: 4700pF; 0603-CAP
C2: 22uF; 0603-CAP
C3, C4, C6, C7: 0.1uF; 0603-CAP
C5: 3900pF; 0603-CAP
C8: 1.0uF; 0603-CAP
C9: 100pF; 0603-CAP
C10: 220pF; 0603-CAP
C11, C12: 1uF; 0603-CAP
CONST: Aquarius; AQUARIUS-CONST
D1, D2: 1N4148; SOD-123
FREQ: 10K; POT-RV9110
F_0-5: PADSMD-070X070; SMD-070MIL
F_GND: PADSMD-070X070; SMD-070MIL
GLYPH: Aquarius; AQUARIUS-GLYPH
KB_IN: JST, SH, 2P; BM02B-SRSS-TB
KB_TRIM: 100K; TRIM_BOURNS_TC33X
MODE: SLIDE-SPDT-MNTSS-12-F45-TH-PCB-2; SS-12-F45-PNL-SMT-2
OUT2VCF: JST, SH, 2P; BM02B-SRSS-TB
PCB: PCB FAB; PENTAGON-40MM-RAD
PULSE: TPSMD-040-RND; SMD-040MIL-RND
PWR: JST SM 3P; BM03B-SRSS-TB
Q1: PMP4201; SOT666
R1, R5: 150K; 0603-RES
R2, R3: 221K; 0603-RES
R4: 412K; 0603-RES
R6: 2.2K; 0603-RES
R7: 47K; 0603-RES
R8: 1.82M; 0603-RES
R9, R23: 10K; 0603-RES
R10, R11, R13, R14: 0; 0603-RES
R12: NS; 0603-RES
R15, R16: 100K; 0603-RES
R17: 10.0K; 0603-RES
R18: 4.75M; 0603-RES
R19, R20, R21, R22: 4.99K; 0603-RES
SAW: TPSMD-040-RND; SMD-040MIL-RND
TP4: TPSMD-040-RND; SMD-040MIL-RND
U1: TL074A; SOP14
U2: LM393; SOP08
U3: CD4066; SOP14
VCO_MOD_IN: JST, SH, 2P; BM02B-SRSS-TB
VCO_MOD_PWM: JST, SH, 2P; BM02B-SRSS-TB
VR: 5V; SOT-23

Connections:
+5V: C2.2, C5.1, C12.2, R16.2, R22.1, U3.1 (IN), VR.2 (VOUT)
+9V: C3.2, C6.2, C7.2, C10.2, C11.2, FREQ.T (3), PWR.1, R1.2, U1.4 (V+), U2.8 (V+), U3.3 (OUT), U3.9 (OUT), U3.14 (VCC), VR.3 (VIN)
-9V: C4.1, FREQ.B (1), PWR.2, R8.1, U1.11 (V-)
BIAS: BIAS.C (2), R19.2, R20.1, R21.1
FREQ: FREQ.C (2), R2.1, R5.1
FREQ_5: F_0-5.1, R1.1, R5.2, R7.2
FREQ_CV_MIX: C1.1, R2.2, R3.2, R4.2, R6.1, U1.2 (-)
GND: BIAS.B (1), C2.1, C3.1, C4.2, C6.1, C7.1, C8.1, C11.1, C12.1, D2.A, F_GND.1, KB_IN.2, MODE.MTG1 (MT1), MODE.MTG2 (MT2), MODE.MTG3 (MT1), MODE.MTG4 (MT2), OUT2VCF.2, PCB.MTG1, PCB.MTG2, PCB.MTG3, PCB.MTG4, PCB.MTG5, PWR.3, Q1.2 (BASE), Q1.6 (COLLECTOR), R7.1, R9.1, R10.1, R11.1, R13.1, R14.1, R20.2, R23.2, U1.3 (+), U2.4 (V-), U3.7 (GND), VCO_MOD_IN.2, VCO_MOD_PWM.2, VR.1 (GND)
KB_CV: KB_IN.1, KB_TRIM.B (1)
unnamed: KB_TRIM.C (2), KB_TRIM.T (3), R4.1
unnamed: Q1.5 (EMITTER), R8.2, U1.5 (+)
unnamed: Q1.4 (EMITTER), U1.6 (-), U1.7 (OUT)
unnamed: C1.2, Q1.1 (BASE), R6.2, U1.1 (OUT)
unnamed: R9.2, R12.2, U3.5 (EN), U3.8 (IN), U3.13 (EN)
unnamed: C9.1, R17.1, R18.1, U1.12 (+)
unnamed: R14.2, U2.6 (-)
unnamed: C9.2, D1.A, R18.2, U1.14 (OUT)
unnamed: C5.2, Q1.3 (COLLECTOR), U1.10 (+), U3.2 (OUT)
unnamed: BIAS.T (3), C8.2, R17.2, R19.1
unnamed: C10.1, R21.2, U3.4 (IN)
unnamed: R12.1, U3.10 (OUT)
unnamed: D1.K, D2.K, R23.1, U3.6 (EN)
unnamed: R10.2, U3.11 (IN)
unnamed: R11.2, U3.12 (EN)
unnamed: R13.2, U2.5 (+)
unnamed: R15.2, R16.1, U2.2 (-)
unnamed: TP4.TP, U2.7 (OUT)
PULSE: MODE.A, PULSE.TP, R22.2, U2.1 (OUT)
PWM_CV: R15.1, VCO_MOD_PWM.1
SAW: MODE.B, SAW.TP, U1.8 (OUT), U1.9 (-), U1.13 (-), U2.3 (+)
VCO_MOD_CV: R3.1, VCO_MOD_IN.1
VCO_OUT: MODE.C, OUT2VCF.1

Notes on the sheet:
VCO FREQ
VCO WAVE
VCO
PULSE
SAW
KB =>
VCO_MOD =>
Zodiac Synth
Aquarius
TO LED BOARD
Convert -9 to +9 range to 0-3.3V for LED PCB.
SATAN'S CYCLE WORKS

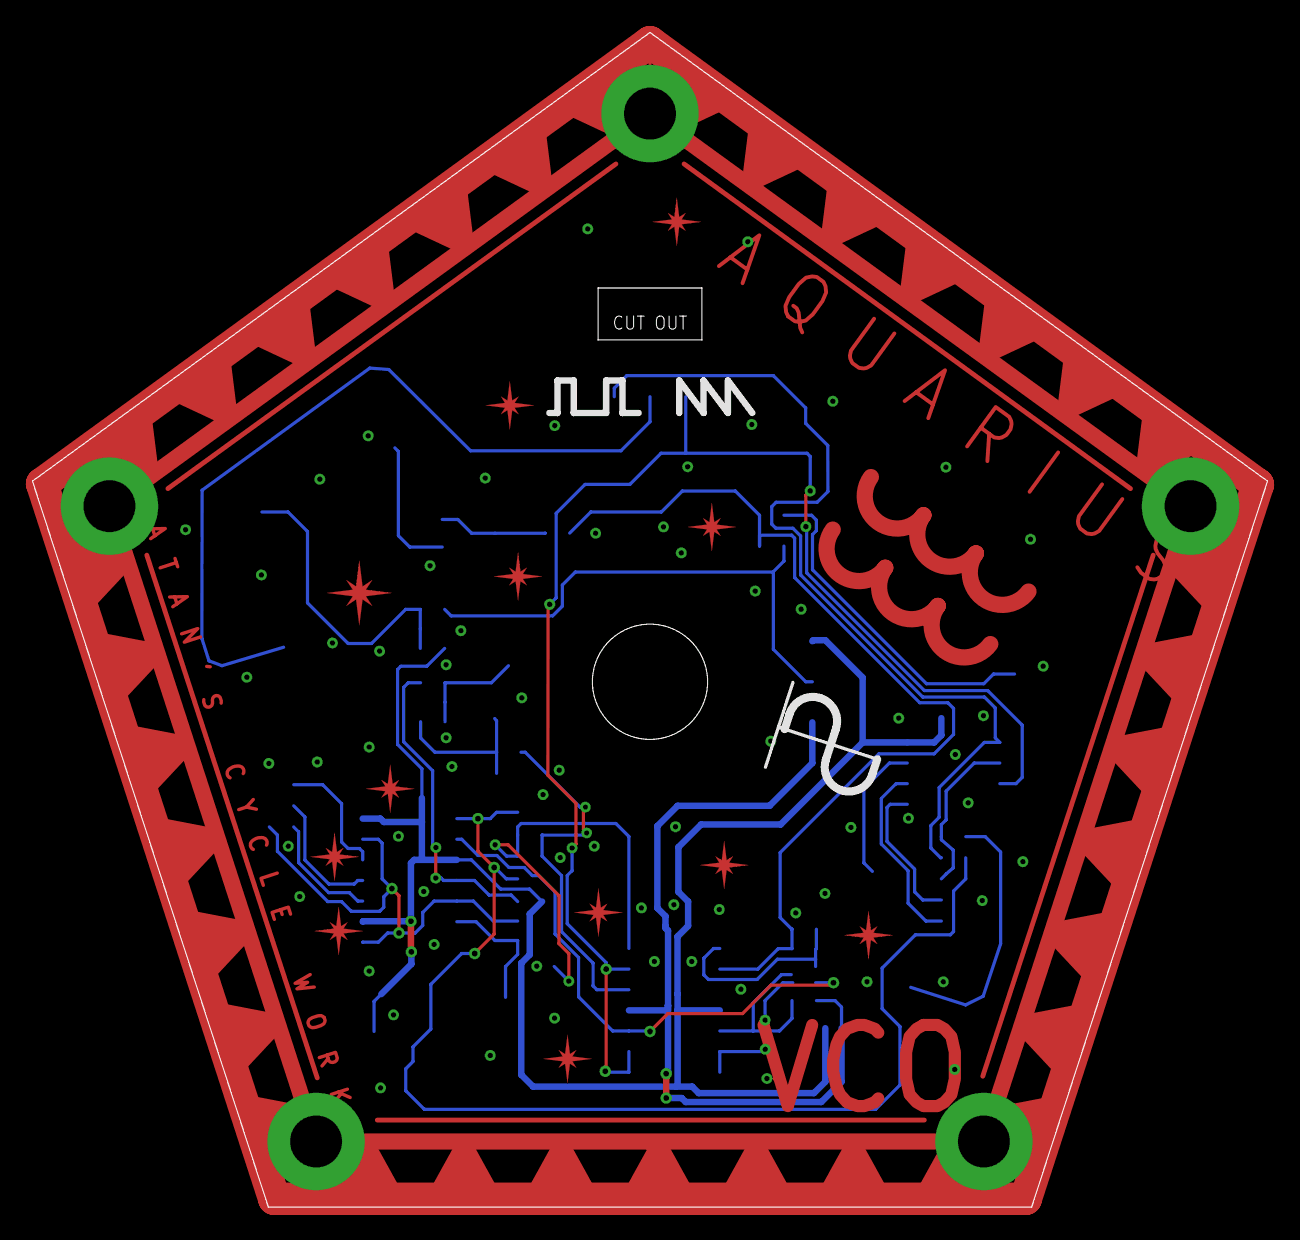
[picture p49: board synth-zodiac-aquarius-vco.brd from above]

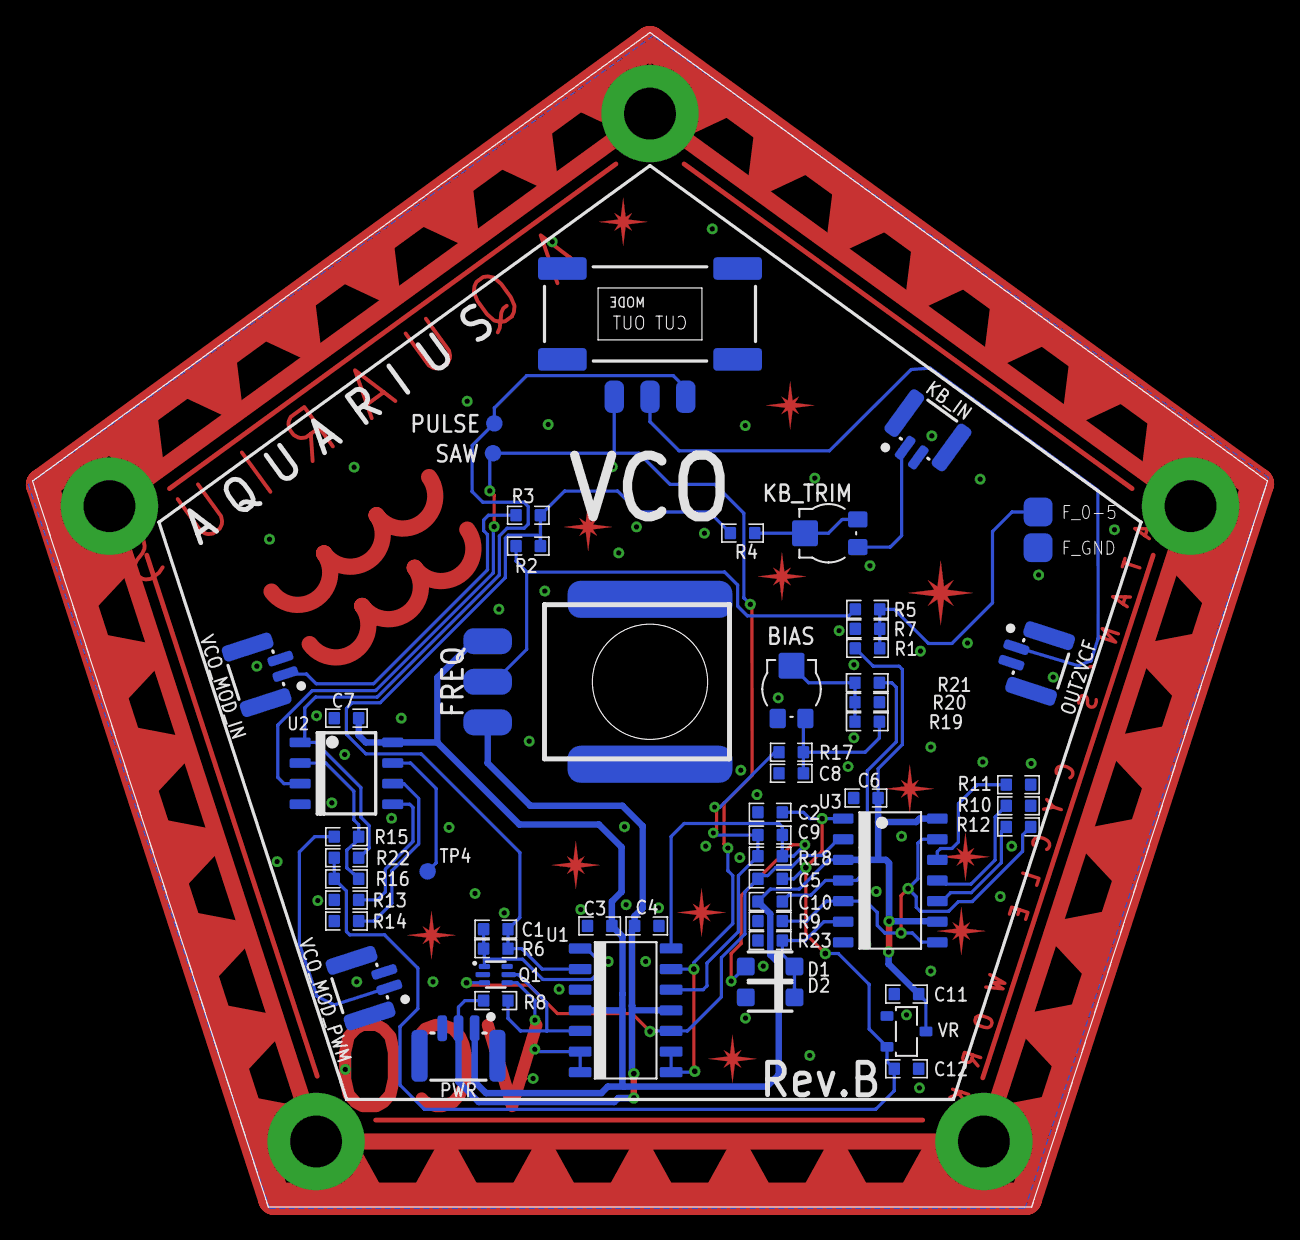
[picture p50: board synth-zodiac-aquarius-vco.brd from below]

Board: 2 copper layers, 76.1 x 72.4 mm, 59 parts (55 on the bottom side), 32 nets.
