CircuitMonkey/synth-zodiac/PCB/synth-zodiac-capricorn-vcf-mod.brd

## EAGLE design PCB/synth-zodiac-capricorn-vcf-mod.brd (2023-12-11)

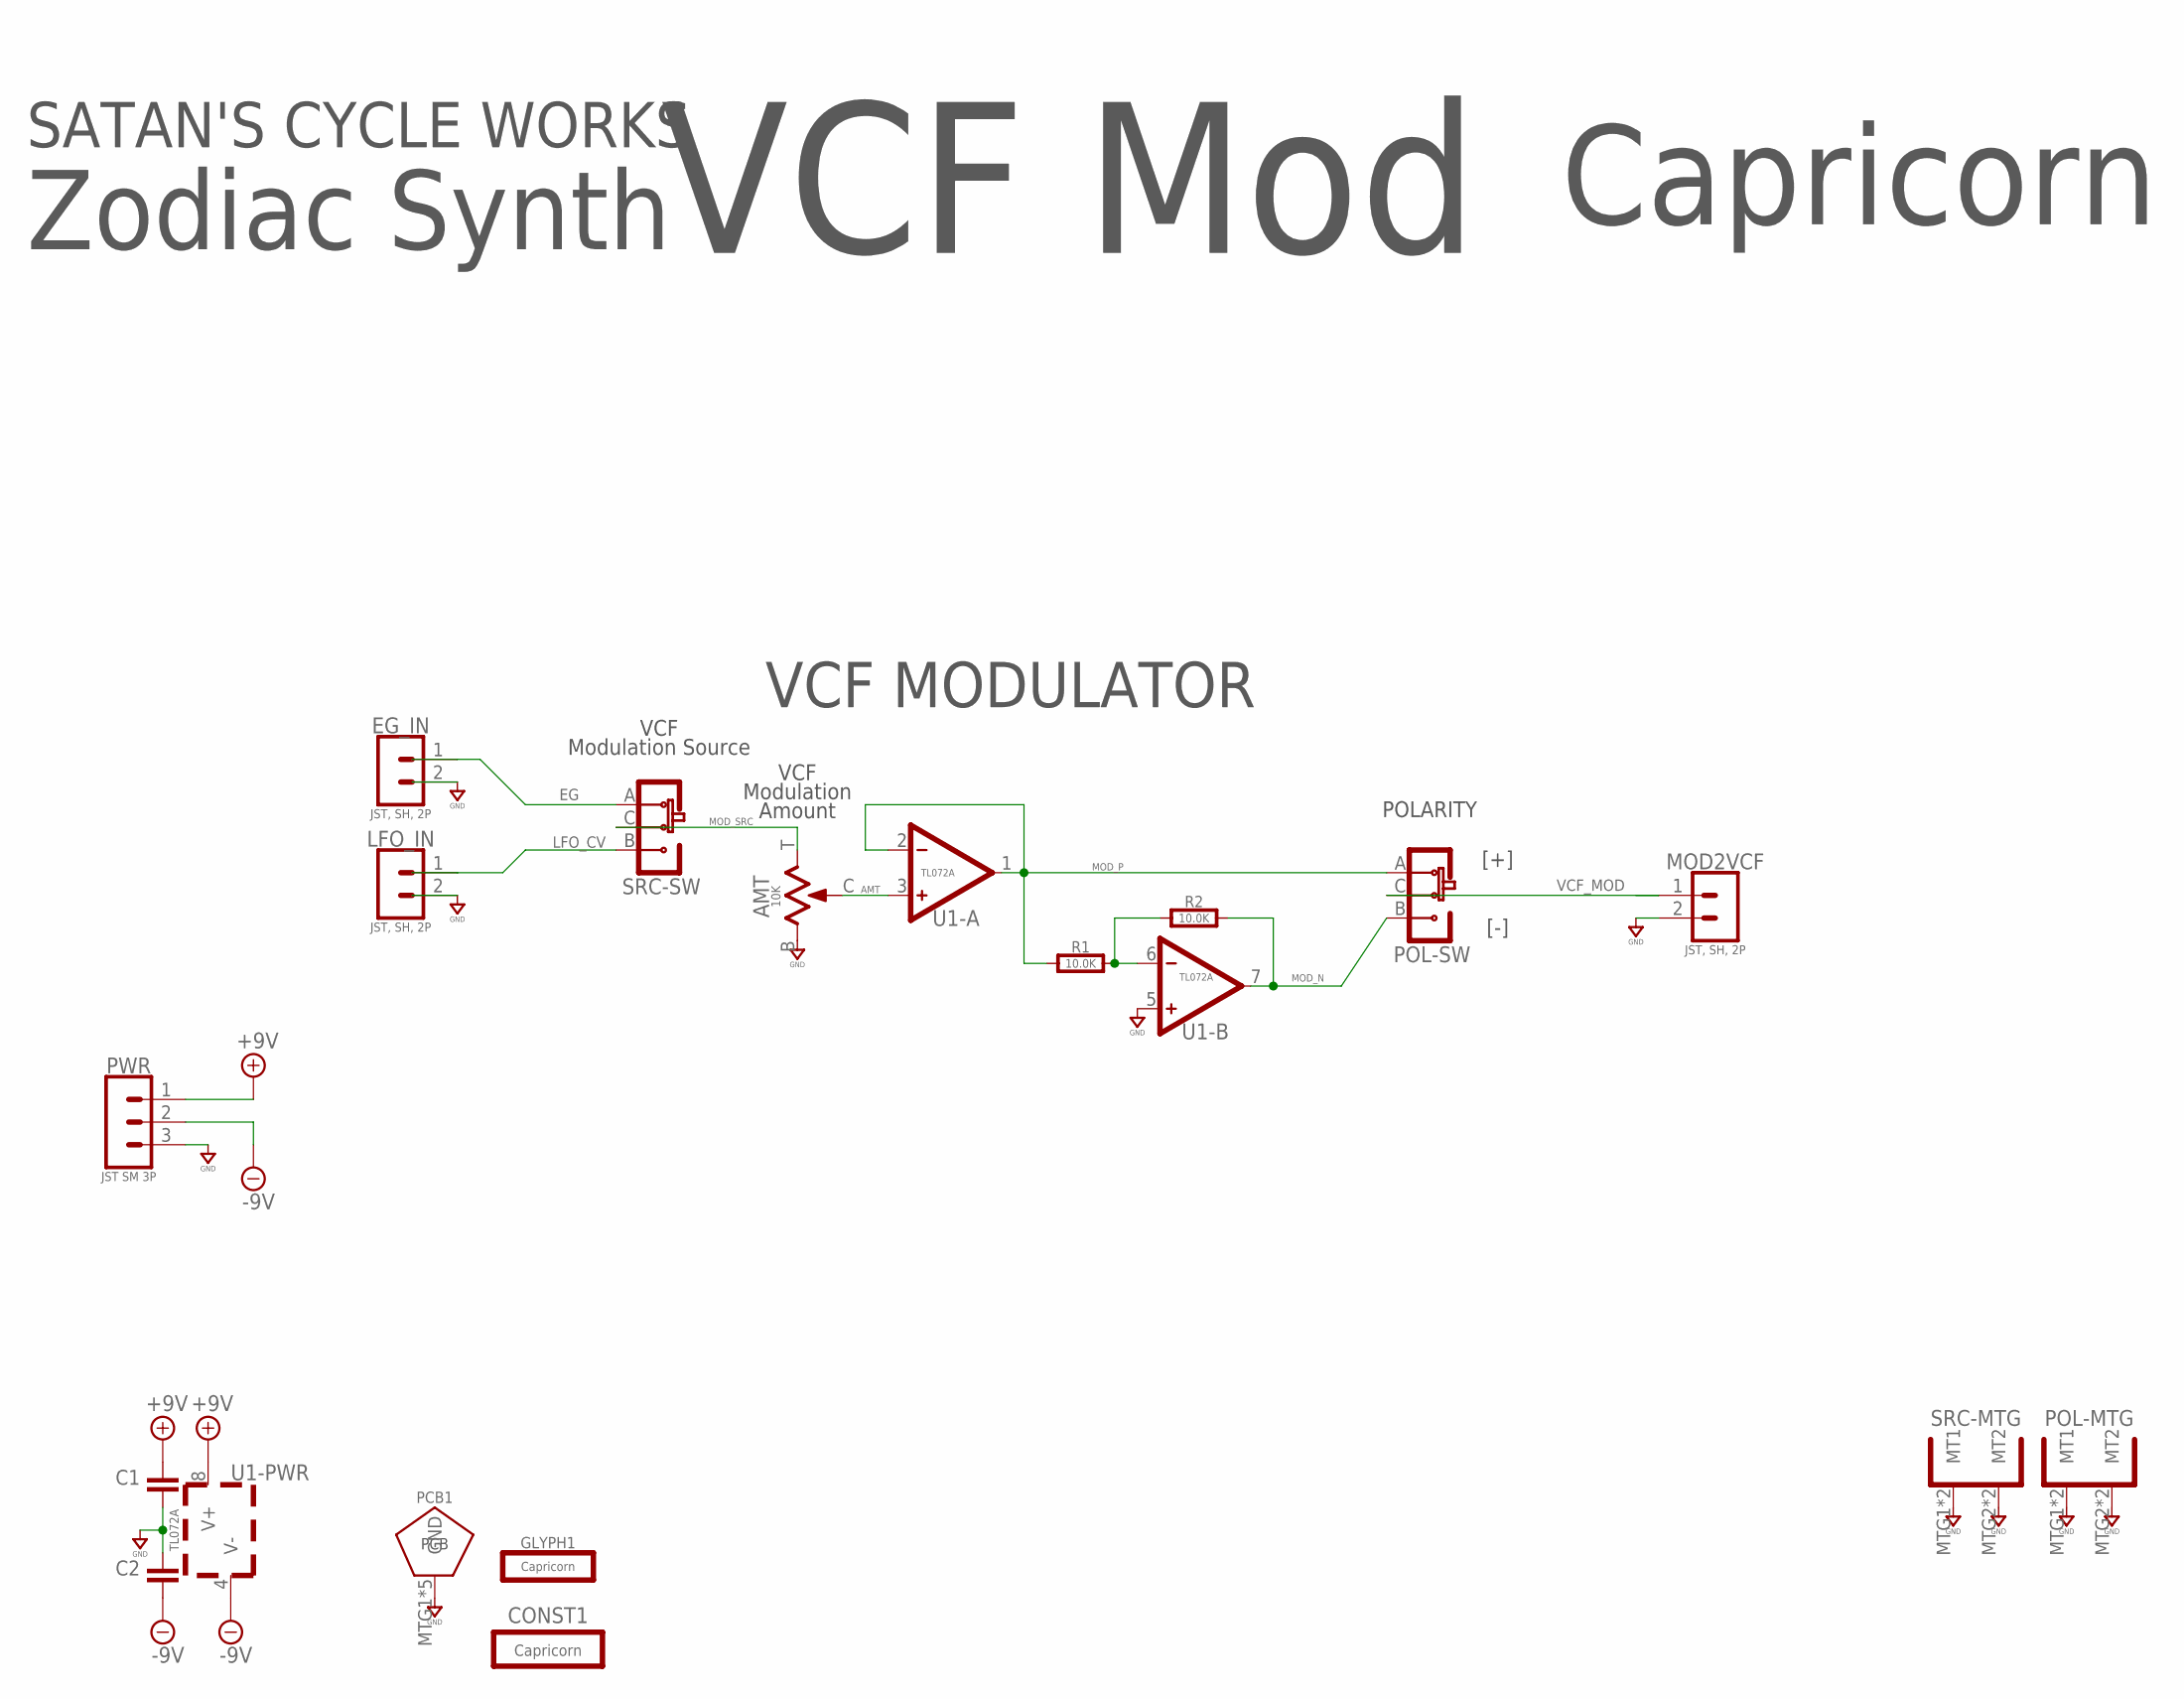
[picture p51: schematic synth-zodiac-capricorn-vcf-mod.sch]

Parts:
AMT: 10K; POT-RV9110
C1, C2: 0.1uF; 0603-CAP
CONST1: Capricorn; CAPRICORN-CONST
EG_IN: JST, SH, 2P; BM02B-SRSS-TB
GLYPH1: Capricorn; CAPRICORN-GLYPH
LFO_IN: JST, SH, 2P; BM02B-SRSS-TB
MOD2VCF: JST, SH, 2P; BM02B-SRSS-TB
PCB1: PCB FAB; PENTAGON-40MM-RAD
POL: SLIDE-SPDT-MNTSS-12-F45-TH-PCB-2; SS-12-F45-PNL-SMT-2
PWR: JST SM 3P; BM03B-SRSS-TB
R1, R2: 10.0K; 0603-RES
SRC: SLIDE-SPDT-MNTSS-12-F45-TH-PCB-2; SS-12-F45-PNL-SMT-2
U1: TL072A; SOP08

Connections:
+9V: C1.1, PWR.1, U1.8 (V+)
-9V: C2.2, PWR.2, U1.4 (V-)
AMT: AMT.C (2), U1.3 (+)
EG: EG_IN.1, SRC.A
GND: AMT.B (1), C1.2, C2.1, EG_IN.2, LFO_IN.2, MOD2VCF.2, PCB1.MTG1, PCB1.MTG2, PCB1.MTG3, PCB1.MTG4, PCB1.MTG5, POL.MTG1 (MT1), POL.MTG2 (MT2), POL.MTG3 (MT1), POL.MTG4 (MT2), PWR.3, SRC.MTG1 (MT1), SRC.MTG2 (MT2), SRC.MTG3 (MT1), SRC.MTG4 (MT2), U1.5 (+)
LFO_CV: LFO_IN.1, SRC.B
MOD_N: POL.B, R2.2, U1.7 (OUT)
MOD_P: POL.A, R1.1, U1.1 (OUT), U1.2 (-)
MOD_SRC: AMT.T (3), SRC.C
unnamed: R1.2, R2.1, U1.6 (-)
VCF_MOD: MOD2VCF.1, POL.C

Notes on the sheet:
POLARITY
VCF MODULATOR
VCF Modulation Source
[+]
[-]
VCF Modulation Amount
VCF Mod
Zodiac Synth
Capricorn
SATAN'S CYCLE WORKS

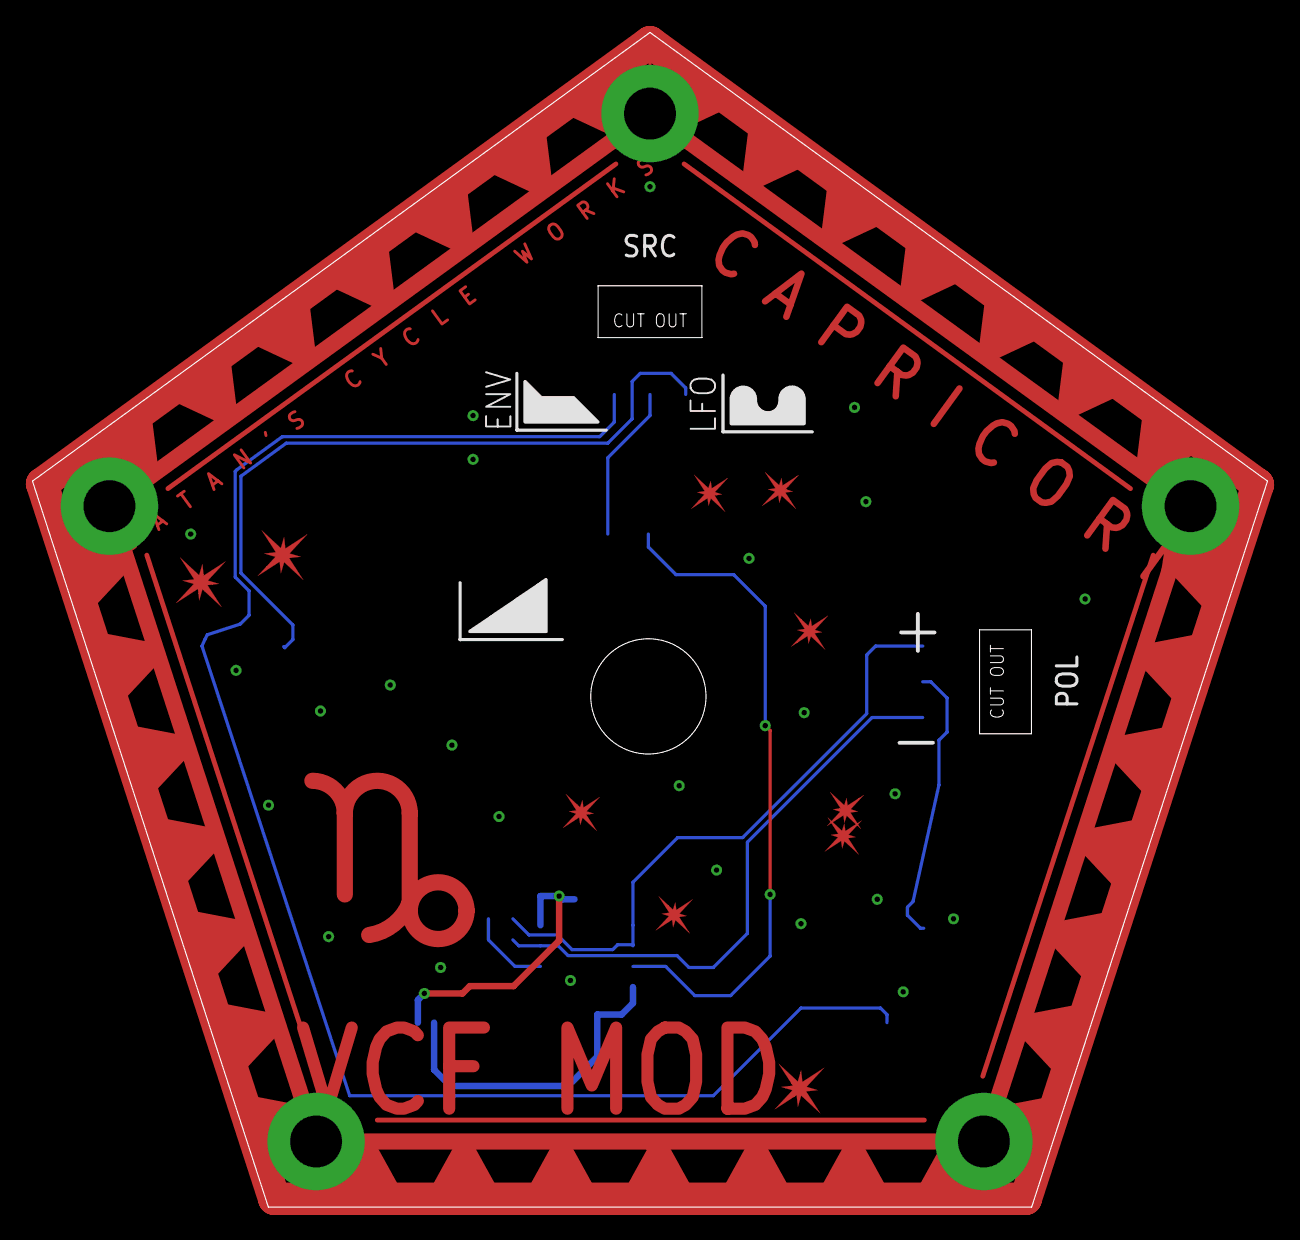
[picture p52: board synth-zodiac-capricorn-vcf-mod.brd from above]

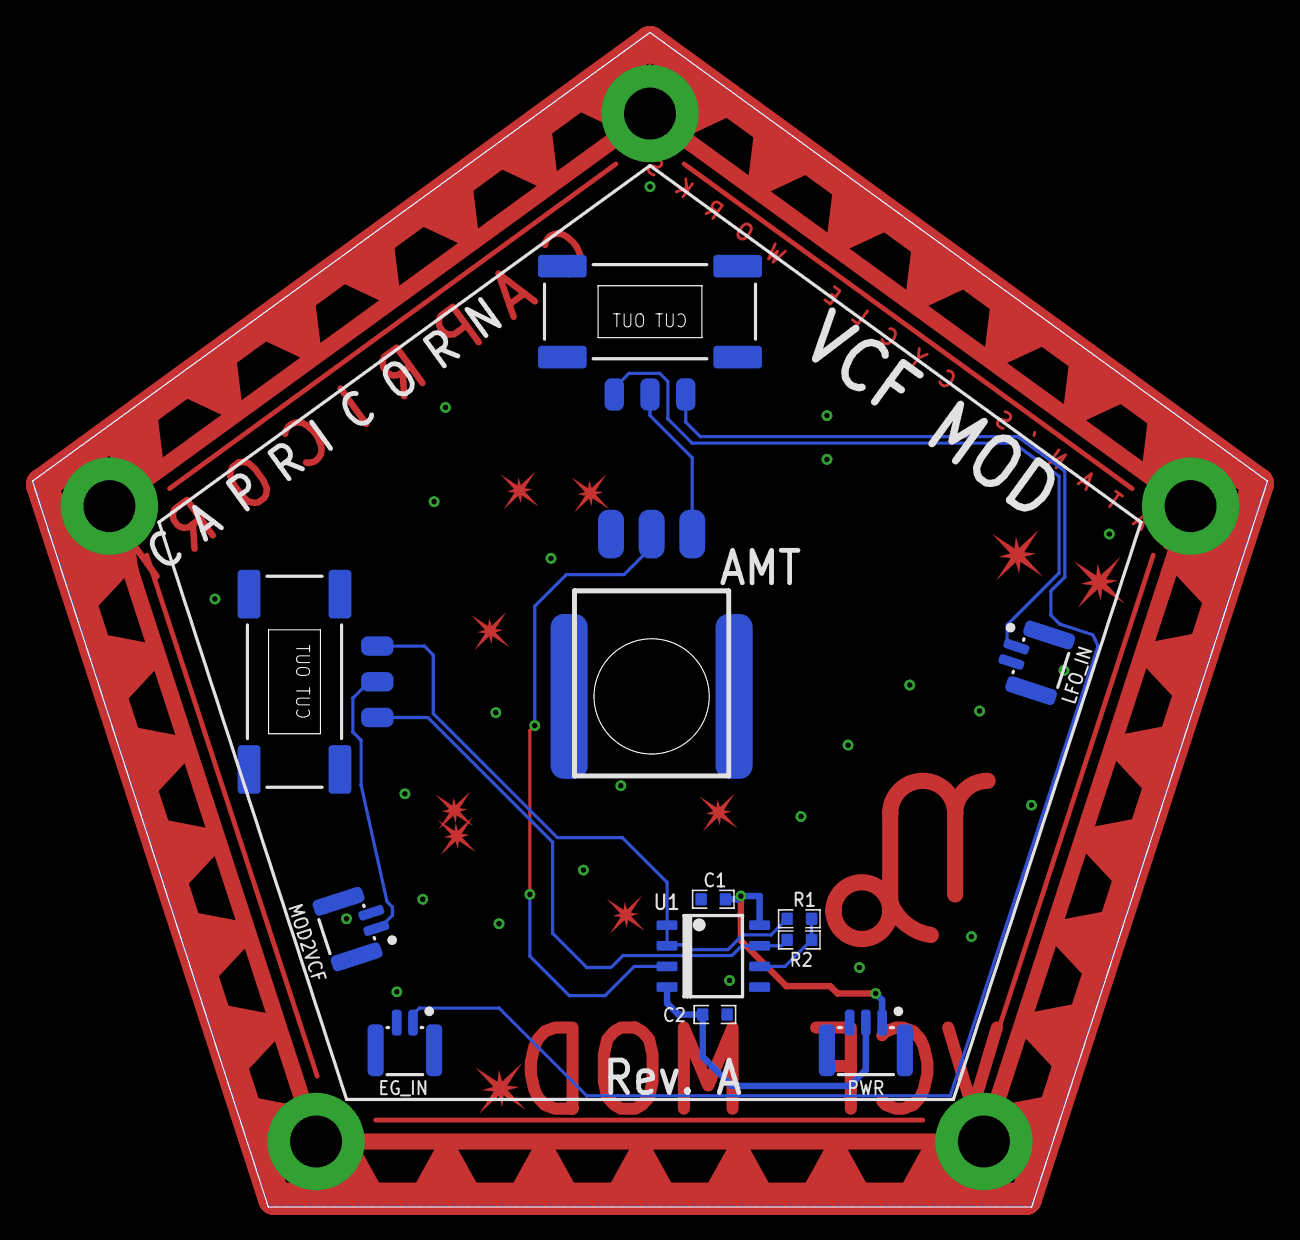
[picture p53: board synth-zodiac-capricorn-vcf-mod.brd from below]

Board: 2 copper layers, 76.1 x 72.4 mm, 15 parts (10 on the bottom side), 11 nets.
