CircuitMonkey/synth-zodiac/PCB/synth-zodiac-sw-test.brd

## EAGLE design PCB/synth-zodiac-sw-test.brd (2023-11-18)

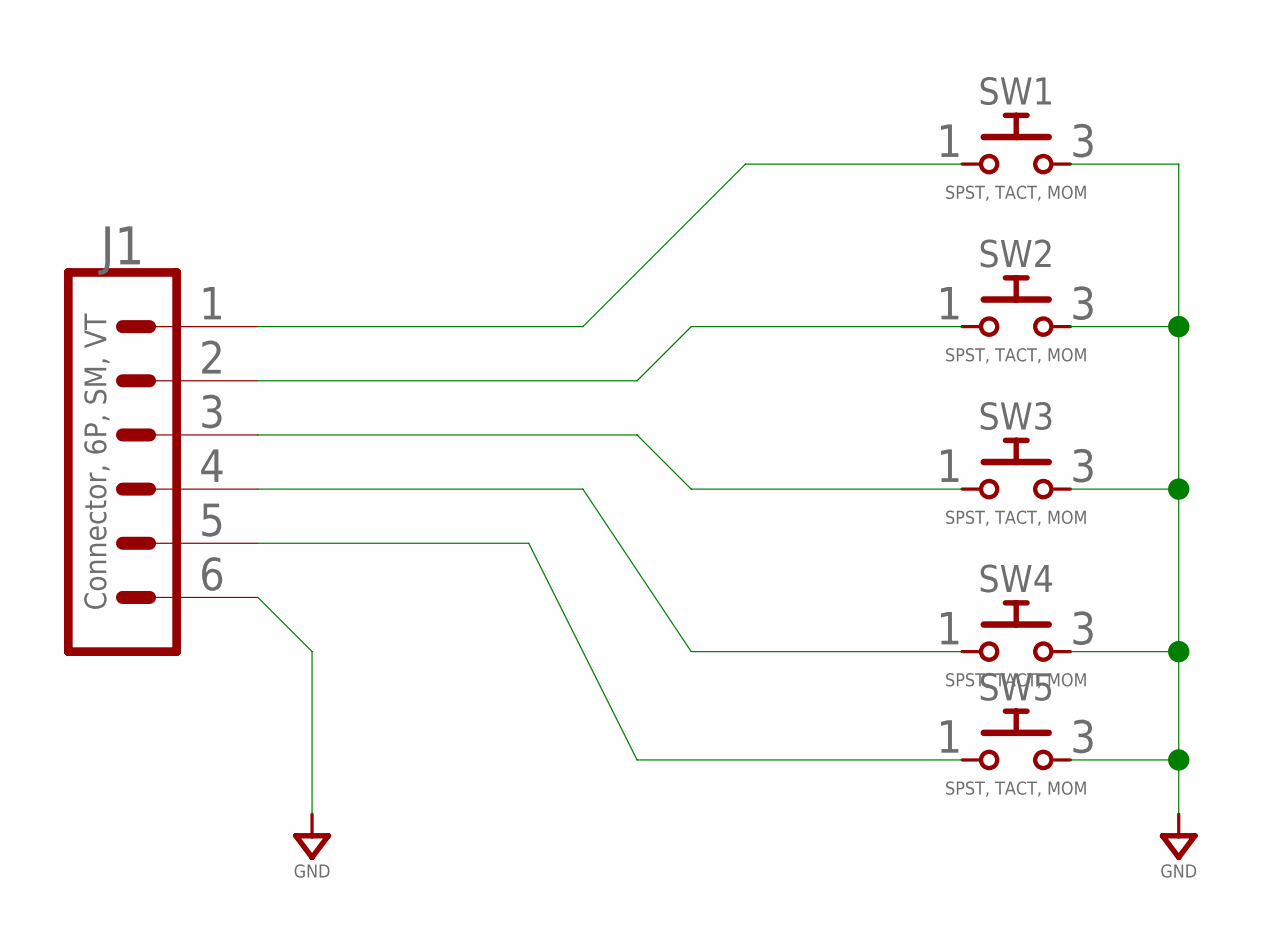
[picture p54: schematic synth-zodiac-sw-test.sch]

Parts:
J1: Connector, 6P, SM, VT; BM06B-SRSS-TB
SW1, SW2, SW3, SW4, SW5: SPST, TACT, MOM; B3FS-BACKMOUNT

Connections:
GND: J1.6, SW1.3 (2), SW2.3 (2), SW3.3 (2), SW4.3 (2), SW5.3 (2)
unnamed: J1.5, SW5.1
unnamed: J1.4, SW4.1
unnamed: J1.3, SW3.1
unnamed: J1.2, SW2.1
unnamed: J1.1, SW1.1

Board: 2 copper layers, 6 parts (1 on the bottom side), 6 nets.
