CircuitMonkey/synth-zodiac/PCB/synth-zodiac-comp-test-2.brd

## EAGLE design PCB/synth-zodiac-comp-test-2.brd (2023-11-18)

Board: 2 copper layers, 4 parts (0 on the bottom side), 2 nets, no tracks yet.

Parts:
J1: USB-C, POWER; GCT-USB4515-PANEL
J2: USB-C, PWR; UJC-HP-3-SMT-TR-PANEL
SW1: Switch, DPDT; CK_OS202013MT5-PNL-SMT-2
SW2: SS-12-F45-PNL-SMT-2

Connections:
GND: J1.GNDA, J1.GNDB, J2.BNGB, J2.GNDA
VBUS: J1.VA, J1.VB, J2.VB-A, J2.VB-B
