CircuitMonkey/synth-zodiac/(commit log)

2022-05-21 Start of four sections.
    [synth-zodiac-aquarius-vco.brd, synth-zodiac-aquarius-vco.sch, synth-zodiac-aries-vcf.brd, synth-zodiac-aries-vcf.sch, synth-zodiac-leo-power.brd, synth-zodiac-leo-power.sch, synth-zodiac-libra-vca.brd, synth-zodiac-libra-vca.sch]
2022-06-20 Cowbell test board sent to fab.
    [synth-zodiac-taurus-cowbell.brd, synth-zodiac-taurus-cowbell.sch]
2022-06-20 Snapshot of designs so far.
    [synth-zodiac-aquarius-vco.brd, synth-zodiac-aries-vcf.brd, synth-zodiac-aries-vcf.sch, synth-zodiac-cancer-cv-panel.brd, synth-zodiac-cancer-cv-panel.sch, synth-zodiac-capricorn-vcf-mod.brd, synth-zodiac-capricorn-vcf-mod.sch, synth-zodiac-gemini-envelope.brd]
2022-06-30 Almost ready for FAB.
    Sagittarius was mis-spelled, renamed it. Taurus is still WIP.
    [synth-zodiac-aquarius-vco.brd, synth-zodiac-aquarius-vco.sch, synth-zodiac-aries-vcf.brd, synth-zodiac-aries-vcf.sch, synth-zodiac-capricorn-vcf-mod.brd, synth-zodiac-capricorn-vcf-mod.sch, synth-zodiac-gemini-envelope.brd, synth-zodiac-gemini-envelope.sch]
2023-09-08 Work in progress for rev A, VCO rev.B
    [synth-zodiac-aquarius-vco.brd, synth-zodiac-aquarius-vco.sch, synth-zodiac-aries-vcf.brd, synth-zodiac-aries-vcf.sch, synth-zodiac-cancer-cv-panel.brd, synth-zodiac-cancer-cv-panel.sch, synth-zodiac-cancer-led.brd, synth-zodiac-cancer-led.sch]
2023-09-08 Archive old version of KBD
    [synth-zodiac-scorpio-kbd-old.brd, synth-zodiac-scorpio-kbd-old.sch]
2023-09-08 VCO Rev. A documents
    [synth-zodiac-aquarius-vco-bom.ods]
2023-11-18 Update and create component test boards
    [synth-zodiac-comp-test-2.brd, synth-zodiac-comp-test-2.sch, synth-zodiac-sw-test.brd, synth-zodiac-sw-test.sch]
2023-11-18 Various board updates.
    [synth-zodiac-aquarius-vco.brd, synth-zodiac-gemini-envelope.brd, synth-zodiac-taurus-cowbell.brd]
2023-12-11 Perhaps final Rev. A?
    [synth-zodiac-aquarius-vco.brd, synth-zodiac-aquarius-vco.sch, synth-zodiac-aries-vcf.brd, synth-zodiac-aries-vcf.sch, synth-zodiac-cancer-led.brd, synth-zodiac-cancer-led.sch, synth-zodiac-capricorn-vcf-mod.brd, synth-zodiac-capricorn-vcf-mod.sch]
2023-12-23 Gerbers as FABed 12-2023.
2024-01-21 Tune values and some schematic visual tweaks.
    [synth-zodiac-aquarius-vco.sch, synth-zodiac-aries-vcf.sch, synth-zodiac-gemini-envelope.brd, synth-zodiac-gemini-envelope.sch, synth-zodiac-leo-power.brd, synth-zodiac-leo-power.sch, synth-zodiac-pisces-vco-mod.sch, synth-zodiac-scorpio-kbd-mcu.brd]
2024-01-21 Bill of Materials spreadsheets added.
    [synth-zodiac-cancer-led-bom.ods, synth-zodiac-capricorn-vcf-mod-bom.ods, synth-zodiac-gemini-envelope-bom.ods, synth-zodiac-leo-power-bom.ods, synth-zodiac-libra-vca-bom.ods, synth-zodiac-pisces-vco-mod-bom.ods, synth-zodiac-sagittarius-speaker-bom.ods, synth-zodiac-scorpio-kbd-mcu-bom.csv]
2024-01-21 VCO BOM and schematic
    [synth-zodiac-aquarius-vco-bom.ods]
2024-01-21 Firmware for some boards.
2024-01-21 Schematic for VCO Rev.b
2024-01-27 Update component value for charging rate.
    [synth-zodiac-leo-power.brd, synth-zodiac-leo-power.sch]
